rapidrabbitsliu/pc-chassis-designs/outputs/ATX-Desk-v12-print-review/Perspective.png

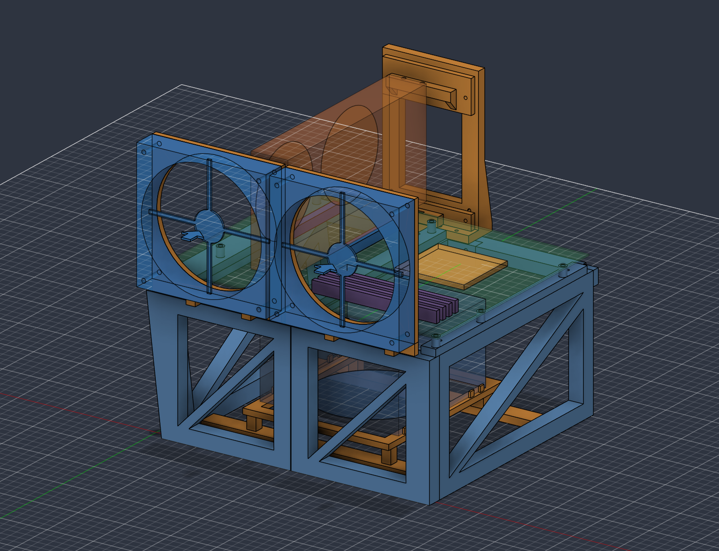
outputs/ATX-Desk-v12-print-review/Perspective.png
