rapidrabbitsliu/pc-chassis-designs/outputs/Style2-v09/Assembly.png

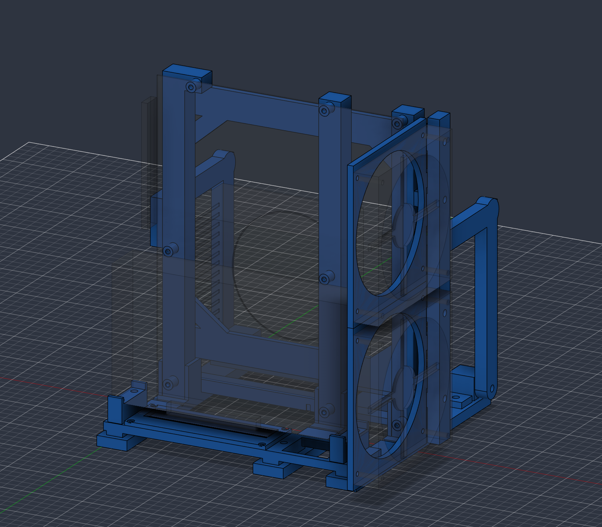
outputs/Style2-v09/Assembly.png
