rapidrabbitsliu/pc-chassis-designs/outputs/ATX-Desk-v24/README.txt

样式1 V24：M3×6、螺丝头直径7 mm配合修正，2026-11-01。
8件20处头井由CAD Ø6.6扩至Ø8.2：P03(2)、P04(2)、P05(2)、P08(4)、P09(2)、P10(2)、P11(2)、P15(4)。P12两处原Ø8.2保留并核对。
打印实测旧孔6.3 mm；旧CAD6.6 mm。结合早期0.6 mm缩孔反馈，预计新净径7.6～7.9 mm，目标>=7.5 mm，需实际试装。
仅扩大螺丝头通道，保留原3 mm承压层、M3 Ø3.4通孔和热熔螺母孔。风扇自攻螺丝孔保持V23设计，不能按M3头孔扩孔。
15件单实体、20处Ø7.6量规通道通过、2处原Ø8.2通道通过；切除范围局限于头井，整机几何干涉0、时间线健康。均不代表实体强度验证。
全套15件9盘沿用A1/0.4、PETG、0.2 mm层高、5墙、40% gyroid和各零件原支撑/裙边设置。V24未切片，打开后重新切片；V23约49小时44分/1106.22 g仅历史预算。未发送打印。
PRINT_STL为15件完整打印件，REPRINT_STL为8件补打；均为毫米。
43个有效M3短热熔螺母，P05另1孔停用。固定M3×6螺丝41颗，显卡上耳另0～2颗，风扇另8颗短自攻。
离线HTML说明书含15件独立图、13步完成图和19组热熔孔位；全部打印件图源为本版3MF。在线 https://rapidrabbitsliu.github.io/pc-chassis-designs/
