rapidrabbitsliu/pc-chassis-designs/outputs/Hook-Fit-v03/README.txt

双钩深度比较试片 V03 — 2026-10-19

优先打印 PRINT_BOTH_4.0_4.2mm.stl：两个分离零件已摆在同一平面，边缘间隔10 mm，总占地74×15 mm。导入单位mm，不要整体缩放。若软件提示拆分对象，可保留为两个对象，同一层打印，勿使用逐对象顺序打印。

每件只有32×15×3 mm前板和两个上挂钩；已去掉原来的下方定位点。孔距20 mm、钩宽3.8 mm、回钩向下3 mm与旧试片相同。钩喉净深分别4.0和4.2 mm。此数值不是总突出长度，也不是板厚。前面凹刻相应数字，槽深0.6 mm、最小笔画约0.8 mm，用于打印后辨认。两件实体总体积约3.36 cm³，不含支撑。

打印：沿用上次PETG及切片设置以便比较。大平面朝下、挂钩朝上，已摆好方向；上钩倒扣底部需要少量支撑，支撑应能从模型表面生成，不能只允许从平台生成。数字凹槽位于贴床面，短笔画顶部会出现小跨度桥接；预览确认，清理底部毛边后辨认。无需为文字额外加支撑。

试装：不用垫片。带钩朝向洞洞板、钩头朝下，将双钩同时插入横向中心距20 mm的两个孔，然后轻轻下移落位。拆卸先抬起约5 mm再向外取下。不要硬推、掰钩或挂重物。没有下部定位点的小试片可能较易摇摆或旋转，不能直接用总体晃动与原四孔4.4 mm试片比较；重点检查前后夹持松紧、能否落位和取下。

记录每件：插入是否顺畅；能否自然落位；前后松紧；能否轻松抬起取下。4.4 mm原试片已达到不晃且不紧的状态，并非越紧越好。选能完整落位且方便拆装的版本；如4.0不能落位先停下，不打磨。

文件：
PRINT_BOTH_4.0_4.2mm.stl：一起打印。
PRINT_depth_4.0mm.stl / PRINT_depth_4.2mm.stl：单件打印备用，不要与合并文件重复导入。
HookDepth_4.0_4.2_v03.f3d：实际Fusion MCP生成的可编辑双组件设计。
raw_depth_*.stl：Fusion原坐标导出，优先使用PRINT文件。
HookDepthBatch/：重生成脚本与manifest，新建文档，不修改现有设计。
verification.json、mesh_check.json：单一实体、时间线健康、STL封闭与体积检查；没有承载验证。

两件均仅供无负载配合测试，没有防抬起锁扣，不能挂电源。新文件独立保存，旧版本保留。
