rapidrabbitsliu/pc-chassis-designs/outputs/Single-Bracket-v05/README.txt

单侧完整挂钩支架 V05 — 2026-10-19

这是单侧装配与后续替代载荷测试的样件，不是已经确认可挂电源的成品。先只打印一只托架与一个防抬起插销。旧版完整电源防脱、左右托架连接仍未完成。本版不包括电源外壳螺丝孔，也不在电源上钻孔。

一、零件与候选紧固件
PRINT_Bracket_v05_mm.stl：主托架一只。
PRINT_AntiLiftKey_v05_mm.stl：可拆防抬起插销一只。
候选紧固件：普通金属M3六角螺母一颗、M3×8非沉头机螺丝一颗。螺母按对边5.5 mm、厚2.4 mm参考，槽对边5.7 mm、深2.6 mm；打印误差可能影响放入和止转。
规格参考：https://www.accu.co.uk/hexagon-nuts/7888-HPN-M3-A2
螺丝长度按头下长度计，不在头下额外加垫片。本几何中8 mm螺杆恰好从插销前面到背板后表面；实际打印后必须核对，端部不可突出并顶住洞洞板。若不能轻松完整啮合螺母，不换更长螺丝硬拧。
没有这套螺丝螺母时，可以先无负载挂板检查配合，但不能把松放插销当作已固定的防抬起结构。

二、采用的几何
上方双钩中心距20 mm，钩宽3.8 mm、喉深4.0 mm、向下回钩3 mm；保持已验证的挂钩接触截面。下方双定位舌与上方孔中心相距80 mm，跨两个40 mm竖向间隔。
背板32 mm宽、6 mm厚，托面32 mm宽、6 mm厚，从背板前面伸出92 mm；靠单侧的8 mm厚三角筋，留有切去尖角的三角减重窗口。前挡边高出托面6 mm。托架总包络约107×120×32 mm，实体体积61.41 cm³，不含打印支撑。
电源占位体140×150×86 mm，从背板前面留2 mm，托面前端留2 mm。占位体没有真实接口或风扇格栅，实际使用前需检查接口、风道与线缆。它不是打印零件。
板后实际净空按约10 mm记录，板厚仍未精确测量；不再用板厚5 mm强行校核4 mm喉深，而以试片实配结果为依据。

三、打印
STL单位mm，PRINT文件已经摆好打印朝向。托架三角筋的外侧大平面与背板、托面、前挡边的同侧边缘共面，直接贴打印平台，不再悬空。三角筋本体不需要大面积底部支撑，挂钩和局部孔槽仍需检查支撑。允许局部支撑从模型表面生成；不要误把整个三角减重窗口塞满支撑。
平移三角筋会改变托面的扭转受力，本版托面和前挡边从24 mm加宽至32 mm；这只是装配与打印改进，没有证明与居中筋承载等效。后续左右件需镜像，并复核电源侧面和插头空间。
几何对比：V04离床水平朝下面积约3209 mm²，V05约131 mm²；贴床面积约3841 mm²。此统计只看水平面，不能当作切片支撑体积或打印时间。实际支撑请以逐层预览为准。
插销大平面贴床、舌头向上，通常不需要支撑，螺丝孔为竖直孔。两个文件分别导入，各打印一件，不导入raw文件以免重复。
沿用已验证的PETG材料配置；这不是单纯的配合小片，建议使用足够外壁（例如5道）并检查根部、斜撑和托面切片连续。外壁数量不构成承重保证。侧放方向是装配样件起点，并非经过强度优化的最终方案。

四、安装顺序（先无负载）
1. 清除支撑，重点清理4 mm钩喉、插销导向孔和六角螺母槽。勿改变已验证的接触尺寸。
2. 在挂板前，把M3螺母从背面放入上部右侧六角槽，应低于或齐于背面。不得凸出造成背板离板。若槽过紧，不硬压开裂。
3. 先不要装防抬起插销。选同一块洞洞板内的矩形四孔：左右20 mm、上下80 mm，避开拼缝和墙面固定螺丝。仅一只样件，不要求现在与第二只相距120 mm。
4. 上方双钩与下方双舌同时对孔，轻推，向下落位约3–5 mm。较大的背板可能改变贴合手感，不能认为小片通过就一定完整件通过。
5. 落位后，从正面把插销的短舌推入背板右上方长方导向孔。舌头进入上部长孔剩余空间，用来限制支架上抬。前部小平板应贴住背板前面。
6. M3×8螺丝穿过插销圆孔，拧入预装螺母，轻轻锁住即可；不要靠强拧消除不配合。
7. 空载、手托着托架，轻试上抬，检查插销能否限制抬起而不是从孔里退出。检查左右摇晃、背板翘起、孔边局部挤压和实际拆卸。
8. 拆卸必须先卸螺丝、取下插销，再上抬并抽出整只支架。托住零件，避免螺母掉落。

插销是新的试验设计，尚未实物验证。只做名义几何检查，未用真实板厚、孔边倒角及漆层验证其限制行程。若插销无法插入、不能阻止上抬或难以退出，记录卡点，不进行载荷测试。

五、这次反馈哪些
四点能否同时入孔和落位；背板是否贴板；托面是否大致水平；螺母能否齐平放入；插销能否装入、固定和取出；锁住后能否限制上抬。暂不放电源，不用单只托架承接整台电源。
完整装配通过后再制定替代载荷与受热蠕变观察步骤，单侧样件不代表左右均分载荷，也未验证插拔线缆的额外力矩。仍需后续左右件、电源侧向和抬起防脱设计。

六、文件和验证
Single_Bracket_v05.f3d为Fusion MCP实际创建并导出的设计，保留草图和时间线，含电源占位参考。草图使用固定尺寸，此版不是全尺寸实时关联模型；改动需统一复核。
SingleBracket/为可重新生成的新文档脚本和manifest。不会修改已有设计。
verification.json记录实体包络和体积，mesh_check.json记录打印网格封闭与朝向检查。Fusion装配干涉检查为0（托架、插销和电源占位体，排除仅面接触）。尚未进行强度计算、载荷、温升或实物装配验证。

本轮V05变化摘要：三角筋从宽度中间移到z=-16至-8 mm一侧；托面和前挡边加宽并从z=-16 mm起始，使各部分共面贴床；三角减重窗口尖角改为短边过渡。4.0 mm钩喉、双钩20 mm间距、上下80 mm孔距、防抬起插销及M3孔槽不变。旧V04保留，请勿混用两版主托架。V04插销与V05插销几何相同，已打印的插销可以继续试配。
