rapidrabbitsliu/pc-chassis-designs/docs/风格1 桌面双层开放式机箱.md

# 风格 1 桌面双层开放式机箱

登记日期：2026年10月22日。机箱记为 **风格 1**；当前为 **V16 显卡插入与工具避让修正版**，其余结构沿用 **V13 一体横梁与重新拆件版**。风格编号表示结构方案，V15 表示该方案的模型版本；风格 2 是另一套方案。

## V16 装机避让修订

2026年10月24日，根据最新实物照片修订三件：P12显卡塔取消音频接口遮挡的X158底部孔，只收短该孔所在前伸底脚24 mm，后部立柱及调节固定点保留，整体宽度仍104 mm。P14下插脚座导向块截到X132，露出X140底部固定孔；两个下插脚槽的位置与尺寸不变。

P13撤销V14/V15的平台加长和孔前移，改为从最初V13的前缘缩回2 mm（Y246.84），上下厚度10 mm不变。用户确认孔从原位向支架侧退1.5 mm（X100/120、Y251），给外径5 mm短热熔螺母保留约1.66 mm前壁。

[V16 Fusion](../outputs/ATX-Desk-v16/ATX_Desk_v16_gpu_access.f3d)、[V16十盘工程](../outputs/ATX-Desk-v16/Style1_V16_All_Parts_10_Plates_With_Temporary_Repair.3mf)、[三件补打包](../outputs/Style1-V16-GPU-Replacement-Parts.zip)、[完整修订说明](../outputs/ATX-Desk-v16/README.txt)。第10盘改放P12/P13/P14三件，V16尚未在Bambu Studio重切片；旧版两件盘的时间与用量不适用。

先紧固底部X80/X140两颗M3×6，再安装上托片和显卡。后横梁原第三热熔孔停用，可保留，后横梁无需重打。剩余两孔Ø10 mm竖直工具包络与P12/P14无体积相交；音频接口没有详细CAD实体，最终配合仍需实物确认。本次不是强度或热性能验收。下文V15及更早尺寸均为历史记录，不适用于这三件新件。

## V15 平台长度最终修订

2026年10月24日，用户将平台延长量改为2 mm，两个螺母孔仍向显卡侧前移3 mm。平台前缘Y=242.84，孔中心仍为X=100/120、Y=246.5；外径5 mm螺母的前壁约1.16 mm。P12及V14其余改动不变，本次仅P13变化。

[V15 Fusion](../outputs/ATX-Desk-v15/ATX_Desk_v15_gpu_fit.f3d)、[V15修订说明](../outputs/ATX-Desk-v15/README.txt)、[V15补打包](../outputs/Style1-V15-GPU-Replacement-Parts.zip)。一盘项目尚未重新切片。已采用V14显卡塔时无须重打P12；先打印新P13核对配合和热熔薄壁。原参考显卡方盒的局部重叠减至约1 mm，仍以实物试装为准。下方V14的3 mm平台加长量为历史记录，已由本节替代。

## V14 显卡实物配合修正

2026年10月24日，依据用户实物照片，仅更新 P12 显卡塔及 P13 上托片：四条头部滑槽和塔底头井扩大至 CAD 8.2 mm，下槽同时穿过加强筋形成后方进入通道；保留3 mm承压腹板。以既有槽约6 mm的打印结果作补偿参考，目标打印后约7.5 mm净宽，尚需复打实测。

P13 两个热熔孔及平台前缘同时向显卡侧 −Y 移动或延伸3 mm，孔中心改为 X=100/120、Y=246.5，平台前缘 Y=241.84。外径5 mm的螺母前面约有2.16 mm材料。下插脚座和其他15件不改。

[当前 Fusion 模型](../outputs/ATX-Desk-v14/ATX_Desk_v14_gpu_fit.f3d)、[修订说明](../outputs/ATX-Desk-v14/README.txt)、[两件补打包](../outputs/Style1-V14-GPU-Replacement-Parts.zip)。补打包内的一盘3MF已经摆好并带基线配置，但尚未重切片。P13延长区域与原简化显卡方盒有约2 mm、800 mm³重叠，需先核对实卡局部轮廓；结构件间无体积干涉，四条滑槽的连续Ø7.5量规相交为0。不能将这些检查视为实物装机验收。

以下章节是V13完整结构、九盘及说明书基线，涉及P12/P13时以本节和V14修订说明为准。

硬件型号、尺寸和九孔坐标统一引用[硬件尺寸与通用设计基准](硬件尺寸与通用设计基准.md)。本文件记录风格 1 的最终布局、结构、拆件、打印配置及验证范围。

## 布局与外观

这是一个 PETG 打印的桌面双层开放式框架：上层主板平放、显卡正常直插，下层电源横放并居中。前上方设置两把并排的 140 风扇，向主板及显卡区域送风；背部保留主板与显卡接口、电源排风通道。

参考当前装配：[V13 Fusion 装配图](../outputs/ATX-Desk-v13/Assembly.png)。图中的蓝色框架、浅色主板梁、橙色附件、绿色主板和透明显卡只是识别部件的显示颜色，不限定实际耗材颜色。CPU、内存、显卡和电源的简化实体用于检查布局，不能当作完整实物模型。

保留左右及前侧承重框架。CPU 右侧保持垂直并与上方结构对齐；PCIe 左侧单侧内收，使底部宽度达到 290。后侧由连续横梁连接左右框架，不设置遮挡电源排风的大面积支撑板。

早期的双侧内斜、下层前挡板、显卡尾部托架、电源上方完整限位框，以及后横梁中间拼接，均不属于本基线。

## 朝向与气流

沿用硬件文档的坐标：X 朝 CPU 右侧，Y 朝背部接口，Z 向上。

| 部位 | 风格 1 的方向 |
| --- | --- |
| 主板 | 水平放置，CPU 在显卡插槽右侧，内存在右前侧 |
| 显卡 | 插第一条长 PCIe，风扇朝 −X，背板朝 CPU 一侧 |
| 主板 DP 和显卡显示接口 | 均朝后，即 +Y |
| 电源 | 下层横放，进风大风扇朝下 −Z，排风朝后 +Y |
| 两把机箱风扇 | 前上方并排安装，朝后 +Y 送风 |

电源通过底部开放托架吸气，托架只承托外壳边缘并限制位移。细扎带用于防脱。整机主要载荷经框架传递至桌面，不通过电源外壳承担。

## 关键尺寸

以下为当前 CAD 的设计值，单位 mm。Z 从桌面计算。

| 项目 | 当前值 | 含义 |
| --- | --- | --- |
| 桌面接触宽度 | 290 | 沿 9→8→7 号孔方向，X 12.45～302.45 |
| 左侧内收量 | 16.45 | PCIe 侧在 140 高度内向内收；CPU 侧垂直 |
| 框架上沿 | Z 140 | 主板梁安装基面 |
| 主板纵梁上表面 | Z 148 | 安装柱从这里继续向上 |
| 主板底面 | Z 158 | 安装柱高约 10；PCB 暂按厚 1.6 建模 |
| 电源包络 | X 77.4～227.4，Y 51.92～191.92，Z 30～116 | 150 × 140 × 86，下层居中 |
| 电源底部进风离桌面 | 约 30 | 中央进风区域保持开放，实物需留意线缆和桌面杂物 |
| 主板底面与电源顶面高度差 | 42 | 梁和加强筋占用部分空间，不能视为完整 42 的空腔 |
| 三根主板纵梁 | 每根长 243.84 | 沿前后方向布置，整根打印 |
| 后部一体横梁 | 304.45 × 47.34 × 20 | 连续单实体，无中间拼缝 |
| 双风扇一体底梁 | 284 × 31 × 20 | 四点固定至前框，面板通过安装耳固定 |
| 两根底部横条 | 每根 274 × 20 × 8 | 配合两侧框架形成 290 落地宽度；零件旧名称中的 290 不是本体长度 |
| 显卡固定塔 | 104 × 38 × 162 | Z 140～302，底部固定至后横梁 |

上层结构宽度约 306.45，主板仍有少量外伸。包含当前简化硬件和风扇的参考包络约为宽 309 × 深 332 × 高 302，未计实际 CPU 散热器、外接插头和线缆，不能直接据此判断完整实机占用空间。

## 承重与连接

主板九个安装点通过三根纵梁和侧部框架向下传力。左右框架、前框、后横梁和底横条形成闭合连接，避免只有孤立立柱支撑。前框角部有连接孔，中缝通过一体连接耳固定；底横条与侧框使用搭接座及螺丝连接。

显卡固定塔底部直接连接后部承重横梁，塔身设置加强筋。上部可调托片承接显卡金属挡板的安装耳，下部可调接收件容纳两个金属插脚；上下分别定位，避免仅靠一个横槽固定。可调件从背面锁紧，滑块内放短热熔螺母。实卡插脚和安装耳仍需试装核对，模型可调不等于已经验证实物适配。

两只风扇面板分别带安装耳，连接到一体底梁；底梁通过四个锚点连接前框。风扇本身为外购件，模型里的轮廓和十字只表达硬件位置，不应作为需要打印的叶片或风扇本体。

## 拆件与九盘安排

可打印件共 **17 件**，均为单个闭合实体。长件允许在热床平面内斜放，保持 100% 比例；不用为了单一方向长度超过 256 就强制拼接。所有零件的实际摆放及 brim 已按 256 × 256 检查。

| 盘号 | 零件 | 件数 | 支撑 | 已切片估时 |
| --- | --- | ---: | --- | --- |
| 1 | CPU 侧框架、三根主板纵梁 | 4 | 中纵梁需要 | 12小时45分 |
| 2 | PCIe 侧内斜框架 | 1 | 无 | 7小时12分 |
| 3 | 前侧 PCIe 框架、显卡上托片、下插脚接收件 | 3 | 下接收件需要 | 7小时04分 |
| 4 | 前侧 CPU 框架，含中缝连接耳 | 1 | 需要 | 5小时41分 |
| 5 | 一体后横梁、一体双风扇底梁，均斜放 | 2 | 风扇底梁需要 | 5小时14分 |
| 6 | GPU 侧 140 风扇安装面板 | 1 | 无 | 1小时44分 |
| 7 | CPU 侧 140 风扇安装面板 | 1 | 无 | 1小时44分 |
| 8 | 电源托架、显卡固定塔主体 | 2 | 两件均需要 | 8小时31分 |
| 9 | 两根 274 底横条，均斜放 | 2 | 无 | 2小时54分 |

后横梁平面斜放后包络约 220.94 × 220.94；风扇底梁约 209.30 × 209.30；底横条约 207.89 × 207.89，以上不含 brim。完整对象尺寸及支撑配置见[分盘清单](../outputs/ATX-Desk-v13/plate-list.csv)和[摆盘检查数据](../outputs/ATX-Desk-v13/plate-checks.json)。

## 已保存的打印配置

下表是 V13 最终 3MF 中的基线配置，不是所有 PETG 品牌的通用参数。Bambu Studio 2.7.1.62 已完成九盘切片。

| 设置 | 当前值 |
| --- | --- |
| 打印机与喷嘴 | Bambu Lab A1，0.4 |
| 材料与热床 | PETG Basic，纹理 PEI |
| 普通层高和首层层高 | 均为 0.20 |
| 墙层数 | 5 |
| 填充 | 40%，Gyroid |
| 顶部与底部层数 | 顶部 6，底部 5 |
| Brim | 左右侧框 3，其余 5；间距 0.1 |
| 支撑 | 六个对象启用普通自动支撑，仅热床；其余关闭 |
| 支撑顶部与底部 Z 间距 | 均为 0.16 |
| 支撑阈值角 | 25° |
| 喷嘴温度 | 首层和后续均 245°C |
| 热床温度 | 首层和后续均 70°C |
| 最大体积流量 | 13 mm³/s |
| 速度基线 | 外墙 60、内墙 150、稀疏填充 200、首层 50 mm/s |
| 打印顺序与比例 | 逐层打印，100% |

九盘切片总估计为 **52小时48分，1175.48 g PETG，其中支撑 34.89 g**。分盘时间分别取整后相加可能有一分钟差异。切片估计不等于实机实际耗时。

此前实际使用 AMS A4 的 PETG；发送每盘时仍需将项目材料映射到当时的实际 PETG 料槽，确认空板。不要把料槽编号当作模型固有属性。重新打开后如软件要求，重新切片再发送。

## 装配材料与顺序

以 M3 × 6 螺丝和 M3 H4.5 OD5 短热熔螺母为主，按约 48 组准备。现有 H8 螺母不能直接替换所有短螺母孔。风扇与面板之间另用匹配风扇的紧固件；电源另备宽约 3 的细扎带，绑带路径避开进风网、排风网、AC 插口及开关。

先安装热熔螺母，再依次装底横条及侧框、前框、后横梁、电源托架、主板纵梁、显卡塔和可调件、风扇底梁及面板。先轻紧，整体校正后再锁紧。采用完整 V13 连接体系，不根据已打印情况混用旧版连接件。

## 文件入口与验证范围

- [风格 1 V13 图解安装说明书](../outputs/ATX-Desk-v13/Style1_V13_Assembly_Manual.html)：2026年10月23日新增，17 件编号、21 组热熔孔位和 13 步完成状态图。
- [说明书及维护资料包](../outputs/ATX-Desk-v13/Style1_V13_Illustrated_Manual.zip)。装配顺序以说明书为准：电源在上方仍敞开时放入，再装主板纵梁和显卡塔。底部横条四颗螺丝头未沉入模型，须增加高于实测头部突出量的等高脚垫，防止螺丝头顶桌面。该要求未修改 CAD。
- [Fusion V13 完整装配模型](../outputs/ATX-Desk-v13/ATX_Desk_v13_one_piece.f3d)
- [Bambu Studio 最终九盘项目](../outputs/ATX-Desk-v13/ATX-Desk-v13-All-Parts-9-Plates.3mf)
- [可打印毫米 STL 文件夹](../outputs/ATX-Desk-v13/PRINT_STL/)
- [整套交付压缩包](../outputs/ATX-Desk-v13-complete.zip)
- [原始零件尺寸数据](../outputs/ATX-Desk-v13/parts.json)
- [V13 建模源文件](../outputs/ATX-Desk-v13/Sources/Build_V13.py)和[连接细节处理源文件](../outputs/ATX-Desk-v13/Sources/Finish_V13.py)

使用最终九盘项目，不使用中间的 Arranged 版本作为最终打印入口。Raw_STL 是 Fusion 原始导出，可能带原始单位及装配坐标，直接打印优先采用 PRINT_STL 或最终 3MF。

已完成 Fusion 时间线健康检查、单实体检查、装配体积干涉检查、关键接触检查、导出网格闭合与法线检查、CAD 和网格体积比对，以及九盘含 brim 的打印区域和切片检查。网格体积与 CAD 差异在 0.3% 以内。

目前仍是原型：没有完成整套实物承重、长期温升、PETG 蠕变和反复拆装验证；显卡金属挡板和完整硬件装配仍待实物核对。后续风格 2 可继承硬件基准与设计优先级，重新选择结构和气流，不需照搬风格 1 的朝向、框架外形或分件方式。
