rapidrabbitsliu/pc-chassis-designs/docs/风格2 竖板前置显卡机架.md

# 风格 2：竖板、前置显卡、竖放电源

2026年10月22日，当前为 V07 双140风扇布局原型，独立于风格 1 V13。下方早期版本参数保留为历史记录，当前变更以 V07 为准。

## 当前 V07：内存侧向接口侧送风的双140风扇

- 按用户确认，两把风扇平行向 −X（主板后置接口侧）吹，风向位于主板板面内，不是朝板面垂直吹。由于本方案主板竖放，风扇在右侧上下排列：上方对应内存/CPU，下方对应显卡。
- 暂用140×140×25风扇和124.5四孔距；上方中心Y−78/Z238，下方中心Y−78/Z86；风扇厚度方向X262～287。
- 新增一根侧安装立梁及两个独立风扇框。立梁用四个一体连接座固定到右立柱X248.49侧面，固定中心Z50、130、236、290，避开原侧框与风扇框连接耳。
- 新右立柱在上述四点增加M3热熔螺母孔。若已经打印V06，其余原件可沿用，右立柱须用V07版本。
- 总高314，低于315限制；现有模型前后包络306，比V06增加49；含风扇宽度约299.84，落地底座不变。实际CPU散热器与外接线缆不计入此包络。
- 打印结构件19个；不透明蓝色为打印件，半透明灰色为硬件。Fusion实体干涉为零、时间线健康；CPU散热器/内存没有实际包络，因此该结果不代表所有实机硬件已验证。
- 紧固件：M3×长4.5×外径5热熔螺母62个，M3×6螺丝62颗，建议各备70。新增风扇采用穿透安装，暂按8颗M4×40＋8个普通M4螺母，并非新增M4热熔螺母；实物风扇孔径需先核对。
- 当前模型：[彩色Fusion](../outputs/Style2-v07/Style2_V07_Dual140_Colored.f3d)、[STEP](../outputs/Style2-v07/Style2_V07_Dual140.step)、[效果](../outputs/Style2-v07/Dual140_Front.png)、[检查报告](../outputs/Style2-v07/verification.json)、[打印说明](../outputs/Style2-v07/PRINT_README.txt)、[源脚本](../work/build_style2_v07.py)。
- 打印项目：[V07 十三盘 3MF](../outputs/Style2-v07/Style2_V07_A1_PETG_All_Parts_13_Plates.3mf)、[完整打印包](../outputs/Style2-V07-Dual140-A1-PETG-Print-Package.zip)。19个单体、13盘均经Bambu Studio 2.7.1.62实际切片；预计1103.92g、51小时46分，全部无支撑。已验证保存后的机器、层高、墙层、填充、擦料塔设置；未发送打印。

## V06 历史：限位方向更正为左右

显示区分已另存为 [V06 彩色版 Fusion](../outputs/Style2-v06/Style2_V06_Colored.f3d)：16 个打印结构件统一不透明蓝色，7 个硬件示意实体统一灰色、25% 不透明度。[颜色预览](../outputs/Style2-v06/Colored_Structure.png)和[显示设置脚本](../work/color_style2_v06.py)一并保留；此修改不改变几何尺寸。

打印准备已完成：16 个结构件拆分为10盘，见 [Bambu Studio 十盘项目](../outputs/Style2-v06/Style2_V06_A1_PETG_All_Parts_10_Plates.3mf)、[打印说明](../outputs/Style2-v06/PRINT_README.txt)、[分盘清单](../outputs/Style2-v06/print_plate_list.csv)和[单件毫米 STL](../outputs/Style2-v06/PRINT_STL/)。A1/0.4/PETG/纹理PEI，0.20层高，5墙、40% Gyroid、顶6底5；245°C/70°C。立柱与横撑平躺、长件斜放，显卡承托梁翻面，全部无支撑；底脚3 brim，其余5。全部十盘经 Bambu Studio 2.7.1.62 实际切片，约932.24 g、43小时47分，未发送打印。完整打印包在 [ZIP](../outputs/Style2-V06-A1-PETG-Print-Package.zip)。这表示打印文件已准备好，实物配合和强度验收仍未完成。

用户通过两张圈图纠正限位方向：需要 X 左右两端限位，V05 的 Y 前后高挡边为错误理解，现已撤掉。

- 两根电源承托横条均在电源 X 两端设置挡块；排风端直挡，线缆端为 45° 导入斜面，挡高 10，左右各留 0.5 间隙。
- 电源仍为 X −0.84～139.16、Y38～124、Z22～172。直挡内侧面 X−1.34；斜面限位内侧面 X139.66，平顶 2、坡长 10。
- 从线缆侧略抬高 10.6，沿 −X 推入 60 后落座，85 个离散包络姿态通过检查。没有验证带线缆或真实外壳凸起的插入过程。
- 底部挡块占用壳体下缘，因此不再声称完整排风面都无遮挡；已检查模型中 Z36 以上的排风格栅外 100 及风扇外 30 的空间无框架干涉，实物格栅最低位置仍需核对。
- 16 个闭合结构件、Fusion 干涉为零、A1 含 brim 逐件包络通过。高度 313.8、结构深度257；尚未完成强度和实物适配验证。
- 当前文件：[V06 Fusion](../outputs/Style2-v06/Style2_V06_313_8mm.f3d)、[STEP](../outputs/Style2-v06/Style2_V06_313_8mm.step)、[左右限位细节](../outputs/Style2-v06/Left_Right_Stops_Detail.png)、[检查报告](../outputs/Style2-v06/verification.json)、[建模源码](../work/build_style2_v06.py)。

## V05 历史：方向错误的前后限位，已由 V06 替代

- 靠主板侧为直挡边，内侧面 Y37.5；外侧限位内侧面 Y124.5。电源范围 Y38～124，前后各留 0.5 装配间隙。
- 承托面 Z22，限位最高 Z32，即有效挡高 10。外侧导入斜面宽 90，45°，从 Y136.5/Z22 上升至 Y126.5/Z32，并保留 2 宽平顶；朝内为直面，落座后限制前后移动。
- 这不是弹性卡扣，不能防止电源向上脱出；后续仍需绑带或经实测确认的螺丝固定。应先略抬高电源再推入、落座，不能贴着底面直接水平硬推。
- 在完整框架中用 140 × 86 × 150 的保守电源包络检查：抬高 10.6、从后侧向主板平移 60，再垂直下降落座，共 85 个离散姿态均无碰撞。采样检查不等于实物装入验证，未包含插头、线材和机壳凸起。
- 后脚座前缘由 Y124 改为 Y124.5，避免与电源壳零间隙贴合。
- 整体仍高 313.8、前后深 257，结构件 16。Fusion 零干涉、时间线健康、进排风通道和逐件含 brim 打印包络均通过。
- 当前文件：[V05 Fusion](../outputs/Style2-v05/Style2_V05_313_8mm.f3d)、[STEP](../outputs/Style2-v05/Style2_V05_313_8mm.step)、[限位斜坡细节](../outputs/Style2-v05/PSU_Stop_Ramp_Detail.png)、[装配效果](../outputs/Style2-v05/Rear_PSU_Stops.png)、[检查报告](../outputs/Style2-v05/verification.json)、[打印包络](../outputs/Style2-v05/print_envelope_checks.json)、[建模源码](../work/build_style2_v05.py)。

## V04 历史：电源靠近主板，左右直角框，缩短后底座

- 电源向主板方向移动 17，当前 X −0.84～139.16、Y 38～124、Z 22～172。排风面与侧边柱齐平的关系保持；电源距立柱后表面 18，距横撑后表面 6。
- 左右外置框取消长斜段，改为顶面水平、后侧竖直的直角形。主截面 20 × 12，转角局部加圆形肉位；与主板立柱通过两颗间距 24 的侧向 M3 螺丝连接。
- 直角框顶梁底面 Z174，电源顶面 Z172，留 2；后竖杆前缘 Y126，电源后面 Y124，留 2。两侧框位于电源风口侧边，不压在风扇面上。
- 底脚后端从 Y195 缩至 Y152；底脚前端仍为 Y−105，故结构前后深度从 300 降为 257，减少 43。左右宽度没有因此缩小，总高仍为 313.8。
- 托架固定位置改为 Y35、111，后托架的中段延伸出限位唇，避开后脚座；电源由托架承重，不作为框架结构件。
- 16 件单闭合实体、Fusion 零干涉、时间线健康。完整排风面向外 100 的通道，以及 Ø120 风扇外侧 30 的保守方形通道，均未发现结构件遮挡。
- 每件含各边 5 brim 的 256 × 256 打印包络通过。仍未完成切片、实物装配、底座缩短后的稳定性、承载和 PETG 蠕变验证。
- 当前文件：[V04 Fusion](../outputs/Style2-v04/Style2_V04_313_8mm.f3d)、[STEP](../outputs/Style2-v04/Style2_V04_313_8mm.step)、[后侧效果](../outputs/Style2-v04/Rear_Compact_PSU.png)、[紧凑侧视](../outputs/Style2-v04/Compact_Side.png)、[检查报告](../outputs/Style2-v04/verification.json)、[打印包络](../outputs/Style2-v04/print_envelope_checks.json)、[建模源码](../work/build_style2_v04.py)。

## V03 历史：去长斜撑，电源排风面与边柱齐平

- 删除贯穿背面的长斜撑；横梁由高 18 改为 28，每根立柱处采用上下两颗 M3 螺丝，并在四角增加约 40 mm 的一体短角撑。它们不是已完成承重验证的替代方案。
- 电源沿 −X 外移 50.84；排风面 X = −0.84，与排风侧立柱外侧面 X = −0.84 齐平。电源当前范围 X −0.84～139.16，Y 55～141，Z 22～172。
- 电源托架、端部限位与绑带槽同步移动；左右外置折线撑保留，整体高度仍为 313.8。
- 下横梁中心高度从 54 提到 57，避免加高横梁与底脚套座干涉。
- 当前有 16 个单闭合结构实体；Fusion 干涉为零、时间线健康；完整排风面向外 100 mm 无结构件遮挡。
- 16 件指定平放方向并旋转后，含各边 5 mm brim 均通过 256 × 256 包络检查，最大包络边 246.46；没有完成切片和物理强度验收。
- 当前文件：[V03 Fusion](../outputs/Style2-v03/Style2_V03_313_8mm.f3d)、[STEP](../outputs/Style2-v03/Style2_V03_313_8mm.step)、[后侧效果](../outputs/Style2-v03/Rear_PSU_Aligned.png)、[排风侧视](../outputs/Style2-v03/Aligned_Exhaust_Side.png)、[检查报告](../outputs/Style2-v03/verification.json)、[打印包络](../outputs/Style2-v03/print_envelope_checks.json)、[建模源码](../work/build_style2_v03.py)。

## 用户当前要求

- MSI Z390-A PRO 主板保持竖向，接口朝侧面；框架顶部与主板齐平。
- 安装空间最高 318 mm，整机设计目标不超过 315 mm。
- 显卡位于主板前下方，通过已购买的 PCIe 延长线连接。
- 电源竖放，排风面与主板后置接口面平行、朝同侧。
- 左右侧撑都位于框架外侧，对称折弯避开电源排风面。
- Bambu A1、0.4 喷嘴、PETG，打印区域 256 × 256 mm，优先承重和可打印性。

## V02 布局

坐标：X 沿主板宽度，Y 向主板背后，Z 向上。主板接口与电源排风均朝 −X。

| 项目 | 模型值，mm |
| --- | --- |
| 框架及主板顶部 | Z 313.8 |
| 主板板框 | X 0～243.84，Z 9～313.8，厚 1.6 |
| 主板底部避让 | 底脚在 PCB 下边缘处局部降至 Z 8.5，留约 0.5 空隙 |
| 电源 | X 50～190，Y 55～141，Z 22～172，即 140 × 86 × 150 |
| 电源排风 | −X，大风扇面朝 +Y；模型格栅只标方向，非实测开孔 |
| 显卡含挡板包络 | 235.5 × 40 × 129，Z 40～169，与主板前后错层 |
| 外侧撑 | 左右镜像，12 厚、20 宽；上端 Y10/Z260，折点 Y175/Z185，下端 Y175/Z20 |
| 三根立柱 | 连续整根，正面沿用变换后的九孔坐标 |
| 紧固件 | 以 M3×6、M3 H4.5 OD5 热熔螺母为基准；连接处沉孔留下约 3 mm 腹板 |

V01 中的主板/底脚、电源托梁/后支座和横梁/斜撑等干涉已在 V02 中修正。

## PCIe 母槽估算

照片按约 89 mm 的标准 ×16 连接器作比例参照，黑色 PCB 约 130 × 18 mm；避让先按 135 × 25 × 15。厚度及孔距未知。V02 的托盘和参考母槽只是占位，尚无经实测确认的 PCB 固定机构。显卡托垫接触位置及防脱固定同样需要实卡核对。

## 检查结果与限制

- 17 个结构件，每件单闭合实体；Fusion 时间线健康。
- 全部结构与简化硬件之间实体干涉为 0。
- 电源完整排风面向外 100 mm 的空间内没有框架实体。
- STL 拓扑边闭合检查通过；指定平放方向后，逐件旋转搜索，包含四周各 5 mm brim 均能放入 256 × 256；最大包络边约 246.46。
- 打印包络检查不等于完成摆盘、支撑设计或切片。Raw_STL 是装配坐标与 Fusion 原始单位导出，不能当作最终毫米打印入口。
- CPU 散热器和内存尺寸未确认，主板元件仅以 PCB 代替；实机装配、线材弯曲、交流插头/开关可达性尚未验证。
- 折线侧撑为排风避让方案，尚未完成承载计算、PETG 长期蠕变或实物承重测试。本版用于看布局和效果，不是最终可打印定稿。

## 文件

- [Fusion V02](../outputs/Style2-v02/Style2_V02_313_8mm.f3d)
- [STEP](../outputs/Style2-v02/Style2_V02_313_8mm.step)
- [后侧效果](../outputs/Style2-v02/Rear_PSU_Exhaust.png)
- [排风侧视](../outputs/Style2-v02/Exhaust_Side.png)
- [Fusion 检查](../outputs/Style2-v02/verification.json)
- [打印包络检查](../outputs/Style2-v02/print_envelope_checks.json)
- [建模脚本](../work/build_style2_v02.py)
- [包络校核脚本](../work/check_style2_print.py)

## V08 紧凑宽度预览（2026-10-23）

用户图中风扇至电源侧的方向由 306 mm 缩至 280 mm；另一方向仍 299.84 mm，高 314 mm。不能将 280 mm 理解为两侧均小于 290 mm。

风扇向内移 7 mm，框外沿裁去 6 mm。电源向主板方向移动 10 mm；上下横撑由 12 mm 减为 6 mm，仍保留 3 mm 螺钉承压壁，电源与横撑留 2 mm。后侧框架缩短 10 mm，底脚末端缩短 13 mm。电源前托座及底脚连接孔同步调整。

19 个打印件；模型打印件之间及与硬件参考包络之间的实体干涉为零。横撑减薄后的刚性、PETG 长期承载、真实硬件/线缆及显卡热风路径仍待验证。V08 为模型预览，未更新 Bambu 切片；修改件不可沿用 V07 打印文件。

文件：outputs/Style2-v08/Style2_V08_Dual140_Colored.f3d 和同目录 STEP、Raw_STL、verification.json。原始 STL 尚未摆盘，不可直接当最终打印包。

## V09 显卡间距 55 mm（2026-10-23）

显卡包络、GPU 托架、两端垫座、PCIe 母槽参考与托盘统一沿 Y 负向移动 12.4 mm。底脚 GPU 固定孔从 Y=-75 改至 -87.4 mm，底脚前端延长至 -117.4 mm。显卡朝主板的面 Y=-67.4，主板正面基准 Y=-12.4，平面净距 55 mm（不含未建模的主板元件突出量）。

总包络 X=299.84、Y=280、Z=314 mm，仍满足此前图中方向 280 mm 的目标。19 个打印件之间及其与硬件参考包络的实体干涉为零。55 mm 为用户要求的几何间距，不等于已完成热验证。未更新切片，不可沿用旧版 GPU 托架和底脚文件。

模型保存在 outputs/Style2-v09/Style2_V09_Dual140_Colored.f3d 和同目录 STEP，检查报告 verification.json。

### V09 打印工程已完成

19 件分 13 盘，已在 Bambu Studio 全部切片并保存，工程参数及零件数量复核通过。A1 0.4 mm，PETG Basic，0.2 mm 层高，5 层墙，40% gyroid，顶6底5，245/70°C。底脚3 mm裙边，其余5 mm，无支撑。预计1014.88 g，47小时30分。未发送打印任务。

最终工程：outputs/Style2-v09/Style2_V09_A1_PETG_All_Parts_13_Plates.3mf
完整包：outputs/Style2-V09-Dual140-A1-PETG-Print-Package.zip
