rapidrabbitsliu/pc-chassis-designs/outputs/ATX-Desk-v11-preview/README.txt

V11 后横梁接头预览，非最终打印版。
重建后横梁：左端按PCI斜侧内表面贴合，右端贴合CPU侧。两端有一体连接耳，M3螺丝穿8 mm耳板进入侧框短热熔螺母。
中间60 mm前后半深搭接，梁深23.16 mm；两颗横向M3贯穿螺栓连接（孔X132/172,Z134,沿Y轴），配金属螺母和垫片。暂定需约M3×30，最终按垫片/螺母选长。两端连接耳需比现有M3×6更长的螺丝（约M3×12起试配）。
搭接下方一体加筋最低Z120，高于电源顶面116；无中间立柱，后部保持开放。显卡塔底3处螺母孔和插脚贯通槽已重做。
保存模型实际测量：左梁-PCI侧、右梁-CPU侧、左右搭接、显卡塔底-左梁最小距离均0 mm，详见contacts.json。当前实体无体积干涉，时间线健康。几何接触不代表强度已验证。
保持底宽290、主板底面158、电源居中和底部进风30 mm。9个主板孔位置保持。
模型采用名义贴合，尚需为PETG打印配合制定公差并测试，4.6 mm螺母试孔需打印试块校准。承载/热变形、整机其他框架接头和电源防脱仍待完成；实卡金属挡板位置仍待测量。
