rapidrabbitsliu/pc-chassis-designs/docs/硬件尺寸与通用设计基准.md

# 硬件尺寸与通用设计基准

记录日期：2026年10月22日。用于风格 1 和后续风格 2 共用的硬件参考，尺寸单位均为 mm。硬件本身的尺寸、用户约束和某一风格采用的摆放方式分别记录，避免新方案沿用已经取消的布局。

## 硬件总表

| 项目 | 已确认的信息 | 尺寸及说明 |
| --- | --- | --- |
| 主板 | 微星 MSI Z390-A PRO，ATX | 官方约 305 × 244；当前 CAD 板框采用 304.8 × 243.84 |
| 显卡 | 影驰 GALAX GeForce RTX 5060 Ti 16 GB，用户提供的产品链接对应款 | 含挡板 235.5 × 129 × 40；不含挡板 223 × 114 × 40 |
| 电源 | ENERMAX 安耐美 GM650 金竞蝠，型号 ERV650G-AHG，650 W | 深 140 × 宽 150 × 高 86；大风扇朝下时高度为 86 |
| 机箱风扇 | 两把，尚未确定具体型号 | 按每把 140 × 140 × 25 预留 |
| CPU | 具体型号未记录 | 当前模型的 CPU 区域仅为位置示意 |
| CPU 散热器 | 型号和尺寸未记录 | 高度、底座和风扇包络需要补充 |
| 内存 | 主板有四条 DIMM 插槽 | 模型画出四条内存示意；实际型号、安装数量和高度未确认 |

显卡尺寸按长度 × 高度 × 厚度记录，不能把含挡板尺寸和散热器本体尺寸混用。具体系列名称不根据外观推断。电源约 1.51 kg 来自早先称重照片的记录，包含照片中的线缆，不作为裸机净重。

## 主板方向与孔位

主板平放，显卡正常直插靠近 CPU 的第一条长 PCIe 插槽，不使用延长线。此前已经对齐的俯视图以主板背部接口在上方为准：CPU 在显卡插槽右侧，内存在右前侧，第二条长 PCIe 插槽在显卡插槽左侧。

布局参考图：[已经确认的主板俯视图](../outputs/board-alignment/motherboard-top-alignment.png)。它表达元件相对位置，不是按图缩放的加工图。

为便于各风格复用，采用以下坐标定义：

- X 向右，朝 CPU 一侧；Y 向后，朝主板 DP 等背部接口一侧；Z 向上。
- 主板板框左前角的桌面投影为原点。板框范围为 X 0～304.8，Y 0～243.84；桌面为 Z 0。
- 孔号按该俯视方向排列。九孔不是等间距的规则九宫格，尤其 3 号孔比 1、2 号孔更靠前。

| 孔号 | X | Y | 位置 |
| --- | ---: | ---: | --- |
| 1 | 16.51 | 233.68 | 后排左 |
| 2 | 140.97 | 233.68 | 后排中 |
| 3 | 298.45 | 210.82 | 后排右，向前错位 |
| 4 | 16.51 | 78.74 | 中排左 |
| 5 | 140.97 | 78.74 | 中排中 |
| 6 | 298.45 | 78.74 | 中排右 |
| 7 | 16.51 | 6.35 | 前排左 |
| 8 | 140.97 | 6.35 | 前排中 |
| 9 | 298.45 | 6.35 | 前排右 |

以上是当前 V13 CAD 已核对的安装中心坐标，尚未对实物主板九孔逐一测量。用户已反馈首根打印纵梁的位置准确，这不等于整板九孔全部完成实物验收。换主板时应重新核对，不能仅凭“ATX 或 mATX”沿用全部孔位。

当前模型的主显卡插槽中心约 X 126.4，第二条长 PCIe 插槽约 X 60，PCB 厚度按 1.6 建模。这些是布局近似值，不能直接作为显卡挡板、PCIe 插槽或背部接口的精密加工基准。

## 显卡安装参考

显卡本体包络使用 223 × 114 × 40，金属挡板另留空间。含挡板总尺寸使用 235.5 × 129 × 40。显卡的显示接口与主板背部接口处于同一后侧。

风格 1 中显卡竖立在平放的主板上：风扇面朝第二条长 PCIe 一侧，即 −X；背板朝 CPU 一侧，即 +X。显卡尾部托架已经按用户要求取消，后部通过金属挡板的上方安装耳和下方两个插脚定位固定。

后续精确设计还需实物确认：显卡重量、上耳螺丝孔位置与厚度、下方两个插脚的宽度和间距、辅助供电接口位置，以及插头和线缆转弯空间。金属挡板不能仅按显卡外形长方体替代。

产品来源：[用户提供的影驰产品页](https://www.szgalaxy.com/goods/detail?id=760873753159798784)。上述两组尺寸来自用户提供的产品尺寸截图。

## 电源安装参考

电源型号按用户明确提供的 **ERV650G-AHG** 记录，外形采用 **D 140 × W 150 × H 86**。深度方向从 AC 插口和排风面延伸至线缆侧；扇面朝下时，平面投影为宽 150 × 深 140，高度为 86。

风格 1 的最终选择是电源横放在下层、尽量居中，大风扇朝下吸气，排风面朝后，与显卡接口、主板 DP 接口同向。早期“进风风扇与显卡风扇同向”和竖放电源方案已经取消。

框架和托架承担整机载荷，电源外壳不作为主板承重结构。电源实际进风网、排风网、AC 插口、开关、线缆接口及固定螺丝孔的详细位置尚未测量。CAD 中约 Ø120 的进风圆只是避让参考。

同系列其他后缀型号不能直接视为同一台电源，尤其不能将 ERV650G-AHG-MAC 或 MAV 的接口和电气规格自动套用到此型号。

## 风扇与气流

用户选择两把 140 × 140 × 25 的风扇用于上层送风。风格 1 将它们并排放在前上方，朝后吹向主板和显卡区域；电源保持独立的底部进风、后部排风路径。

当前风扇安装孔距按常见的 124.5 × 124.5 建模，安装面板通风开口约 Ø130。风扇型号尚未确定，购买后需核对实际孔距、外框尺寸、线缆出口和螺丝规格。

## 打印与桌面约束

用户要求按以下优先级设计：

1. 每个零件在实际打印方向下都能放入 256 × 256 的打印区域，包含 brim；允许平面斜放，保持 100% 比例。
2. 承重足够，连接和受力路径可靠。
3. 打印方便，尽量减少不必要的支撑、拼接和零件。
4. 美观。

当前使用 Bambu Lab A1、0.4 喷嘴、PETG。桌面沿 9 号孔朝 8、7 号孔的方向，能够完整承托的宽度约 290；用户接受上层主板和结构适度超出桌面。290 是这一方向的落地尺寸约束，不是所有方向的整机尺寸上限。

当前方案为桌面支撑，不再采用早期挂洞洞板方式。风格 2 如改变安装方式，需要重新确定支撑和空间约束。

## 螺丝与热熔螺母

用户给出的螺母尺寸顺序为“螺纹内径 × 高度 × 滚花外径”：

| 现有材料 | 正确解释 | 当前用途 |
| --- | --- | --- |
| 3 × 8 × 5 | M3，长 8，外径 5 | 长热熔螺母；按局部厚度选择，不默认每处都使用 |
| 3 × 4.5 × 5 | M3，长 4.5，外径 5 | V13 主要采用的短热熔螺母 |
| 螺丝螺纹段约 6 | 当前按 M3 × 6 配合设计 | 实际头型、头径仍需核对 |

2026年10月24日实物反馈：现有一款 M3×6 蘑菇头螺丝头径约7 mm，V13显卡塔原CAD 6.6 mm槽实测约6 mm，无法放入。V14显卡塔将头槽和底部头井扩大至CAD 8.2 mm，目标打印净宽约7.5 mm；其余V13零件的旧头井未统一更改，不能将“螺纹均为M3”视为所有头型均兼容。螺丝头高度仍未确认。

V13 多处螺丝头井为 Ø6.6，连接腹板约 3，使 M3 × 6 能获得约 3 的螺纹啮合。特殊大头、手拧头或附大垫片的螺丝需要另核对。热熔螺母试装底孔采用 Ø4.6 或 Ø4.7，最终效果受螺母实物和打印尺寸影响；它们不是冷压装配孔。

## 后续补充清单

优先补充 CPU 散热器高度与包络、实际内存高度、显卡挡板详细尺寸和电源线缆转弯空间。若风格 2 改变主板方向，保留硬件尺寸及上述孔位坐标关系，再重新推导机箱坐标、气流、承重点和打印方向。

主板尺寸来源：[MSI Z390-A PRO 官方规格](https://br.msi.com/Motherboard/Z390-A-PRO/Specification)，官方以 12 × 9.6 英寸及约 30.5 × 24.4 cm 表示板型。电源型号和包络还参考早先“创建参数化理线夹试作品”会话中的用户确认、卷尺照片及称重记录。结构和切片资料见[风格 1 文档](<风格1 桌面双层开放式机箱.md>)。
