rapidrabbitsliu/pc-chassis-designs/outputs/ATX-Desk-v16/README.txt

风格1 V16：显卡插入及底座螺丝工具通道修订
2026-10-24

以V15为输入，仅改P12显卡塔、P13上托片、P14下插脚座，其余14件沿用。全部17件完整模型为 ATX_Desk_v16_gpu_access.f3d。

P13：撤销V14/V15的平台加长及孔前移。相对最初V13，前缘沿+Y缩回2 mm，改为Y246.84；平台上下厚度仍为10 mm。用户确认两个热熔孔从原位Y249.5向支架侧退1.5 mm，改为Y251.0（X100/120），孔径4.7 mm，使用M3×4.5×5短热熔螺母。外径5 mm螺母前方保留约1.66 mm材料。该变化相对V15为平台前缘缩回4 mm、孔后退4.5 mm。

P12：取消被音频接口遮挡的第一处底部固定孔（X158/Y248.5）；对应前伸底脚在CPU侧收短24 mm，前沿部分X70～150、Y244～254。后部立柱、加强筋根部及两侧上下调节孔保留，因此支架整体宽度仍为104 mm，不宣称整体缩短。剩余两个底部固定孔为X80/140、Y248.5。原有8.2 mm头部通道保留。原后横梁的未使用X158热熔孔不影响使用，无需重打后横梁。

P14：两插脚导向块从X140截到X132，另一端从X84轻收至X85，给底部两孔的螺丝头及工具让位；后部调节背板保留，两个下插脚槽的中心X96/116、开口宽度与前后位置均不变。

装配顺序：先安装下插脚座和显卡塔，拧紧底部两颗M3×6固定螺丝，再装上托片并插入显卡；最后调节高度、锁紧滑块和显卡金属上耳。不得依靠上耳螺丝强拉显卡入槽。后横梁接收显卡塔的热熔螺母从三处实际使用改为两处；已装入但停用的第三个可保留。

几何检查：17件均为单个闭合实体，结构件体积干涉为0；简化硬件参考包络干涉为0；时间线健康。剩余底部两孔以Ø10 mm、Z148.01～310的竖直工具包络检查，与P12/P14的相交体积均为0。工具检查不包含尚无精确模型的主板音频接口及完整线束，也不代替实物试装或长期强度验收。

PRINT_STL/ 为17件指定打印方向、毫米单位的完整模型；REPRINT_STL/ 为P12、P13、P14三件补打模型。三件一盘含5 mm brim，打印包络已检查在256×256 mm内。临时盘P12普通自动支撑仅热床，P13/P14无支撑，0.2 mm、5壁、40% gyroid PETG基线。

Style1_V16_All_Parts_10_Plates_With_Temporary_Repair.3mf：原九盘更新三件，在第10盘额外放这次修补的三件；原盘号与已打标记保留。未发送打印任务。
