rapidrabbitsliu/pc-chassis-designs/outputs/ATX-Desk-v01/README.txt

ATX 桌面双层底座 V01 — PETG 试装版
适配目标：MSI Z390-A PRO、ENERMAX ERV650G-AHG、用户提供的影驰 5060 Ti 16GB 尺寸。

设计与朝向
X 正方向：从主板后置接口往前；Y 正方向：从 CPU 一端往显卡风扇一侧；Z 向上。
电源后部出风与主板 DP 接口都朝 -X；电源大风扇与显卡风扇都朝 +Y。
主板水平安装、显卡直插主 PCIe 插槽。电源侧立在下层，不承托主板框架。
主板参考板框为 304.8 × 243.84 × 1.6 mm；底面 Z=208 mm。
电源占位为 X20..160、Y45..131、Z20..170 mm，即 140 × 86 × 150 mm。
主框架侧片高 190 mm；上横梁顶面 198 mm；主板安装柱高 10 mm、直径 8 mm。
主体约 296 × 320 mm；含后部显卡固定架最大约 308 × 320 × 350 mm，不含 CPU 散热器。

文件
PRINT_*.stl：21 个独立零件，全部需要各打印一件；试片打印后不装入底座。
raw_*.stl：Fusion 装配坐标原始导出，仅供追溯，不要与 PRINT 文件重复打印。
ATX_Desk_v01.f3d：可编辑 Fusion 特征模型，含非打印硬件参考包络。
Build_ATX_Desk_v01.py：在新 Fusion 文档重生成的脚本，尺寸集中在 CONFIG 与 HOLES 中。
这是有特征历史的模型；脚本草图坐标固定，不是修改单一参数就能自动联动全体几何的完整约束模型。
geometry.json / mesh_checks.json / interference.json：几何、网格和干涉检查记录。

先打印热熔螺母试片
先单独打印 PRINT_11_INSERT_FIT_FIRST.stl，使用正式 PETG 和层高。
平放时，沿 X 从左到右三列孔径分别为 4.6 / 4.7 / 4.8 mm。
Y=8 mm 的近排用于 4.5 mm 高螺母；Y=22 mm 的远排用于 8 mm 高螺母。
试片两排孔深分别为 4.9 / 8.4 mm；热压时按顶面控制下沉约0.2 mm，不必继续压到底。
正式零件短孔深4.7 mm，主板柱及滑动螺母块为4.9 mm；长孔深8.2 mm。
主模型采用 4.7 mm 孔径。选择能完整热压、无鼓包且拧螺丝不转动的一列。
若 4.7 不合适，先调整主模型孔径再打印整套。不要冷压外径 5 mm 的螺母。

五金清单（不含试片耗材）
M3 × 6 mm：9 颗，主板固定；可用你现有的螺丝，先确认实际螺纹确为 M3。
M3 × 10 mm：8 颗，电源托梁 4、显卡后支架脚 2、尾支架脚 2。
M3 × 12 mm：27 颗，侧框连接片 16、主板横梁 6、电源压框 4、显卡挡板 1。
M3 × 16 mm：4 颗，显卡后支架滑块 2、尾支架滑块 2。
M3 平垫圈：至少 5 片用于显卡调节与挡板，主板处可另加 9 片合适的小垫圈。
M3 × 高4.5 × 外径5 mm 热熔螺母：24 颗。
M3 × 高8 × 外径5 mm 热熔螺母：24 颗。
短螺母：主板安装柱 9、侧框顶端 6、侧框托梁座 4、中横梁显卡支架脚 4、显卡滑动螺母块 1。
长螺母：侧框接缝侧面 16、电源压框底部 4、两个显卡滑块各2共4。
建议另备少量螺丝与嵌件。电源原有外壳和螺丝不需要拆动。

打印
导入单位 mm；禁止缩放。256 × 256 mm 平台。
PRINT 文件已平移贴床；长横梁和电源托梁已在平面内旋转 45°，请保留该朝向。
侧框与连接片平放；电源压框侧躺；显卡后架侧躺；尾支架脚朝下。
PETG、0.4 mm 喷嘴、0.20 mm 层高为起点。侧框/横梁/支架建议 5 道墙、6 层顶底、30–40% 填充。
显卡滑动螺母块、连接片和小滑块建议实心。具体温度与风扇沿用该耗材已验证配置。
不要一键对所有零件禁用支撑：主板横梁两端安装耳底部有悬空，需局部支撑。
横梁主跨的下筋和45°过渡可减少连续悬空；最终以切片逐层预览为准。
侧框的侧向嵌件孔朝上；框架平放不需要填满减重窗口。
各零件的孔口、窄槽及显卡滑块台阶按切片检查局部支撑。不要把嵌件孔塞入难以取出的支撑。
后显卡滑块按文件朝向打印时高96 mm，建议加裙边，并为中间开口上沿设置局部支撑。
去毛边后再试装，尤其清理孔口的象脚；装配面不得有残余支撑。

装配顺序
1. 试片通过后热熔嵌件。主板柱与滑动螺母块的嵌件顶面低于塑料约0.2 mm。
2. 左右侧框各由 rear / front 两片组成，接缝名义间隙0.4 mm；内外方向按 Fusion 装配图。
   每侧上下各一片连接片，用 M3×12 固定。连接片在两侧框外侧。
3. 装 CPU / MID / PCI 三根主板横梁，M3×12 从上穿过安装耳，拧入侧框顶端短嵌件。
   三梁 Y 中心分别为6.35 / 163.83 / 288.29 mm。不要把中梁与端梁混淆。
4. 两根电源托梁放入侧框低位让位座，M3×10 从上固定。
5. 空机试放主板，9 孔均对准、板背与横梁留空后再用M3×6逐颗固定，不靠拧紧强行拉孔。
6. 取下主板或妥善隔离，放电源，再安装两只可拆压框。
   压框用M3×12从托梁下方向上固定，长槽允许前后小幅调位；压框不需要压弯电源外壳。
   下层限位槽净长141 mm、净宽87 mm，分别给140 / 86 mm机身约1 mm总余量。
7. 后显卡支架固定在中横梁后端，尾支架固定在中横梁前端，脚用M3×10。
   先装横梁的中心螺丝，再装支架脚。脚底凹位给横梁中心螺丝头让位。
8. 显卡插入主 PCIe 插槽，后滑块用两颗M3×16和垫圈调高，长槽对准金属挡板。
   小滑动螺母块放在螺丝台下方，用M3×12和垫圈固定显卡金属挡板。
9. 尾部滑块用两颗M3×16调高，接触显卡外壳实心边缘；不要碰风扇叶片、PCB或接插件。
   需要时垫薄防滑软垫，只托住重量，不把显卡向上顶弯。

显卡配合范围与限制
GPU 包络采用用户截图：含挡板235.5×129×40、不含挡板223×114×40 mm。
厂家尺寸没有给出主板插槽到显卡外壳、挡板弯折与风扇的精确偏置；占位模型的Y=155是布局参考值。
后支架螺丝台Y槽中心范围142..214 mm，竖向调节约28 mm；尾支撑竖向调节约24 mm。
这些调节用于实物试配，不表示已证实与这张显卡所有接口、风扇和外壳边缘吻合。
先在断电状态验证挡板螺丝能自然对齐、显示线能插拔、尾托接触实心位置。
尾托横臂位于主板上方约3.4 mm（相对1.6 mm PCB顶面），必须检查附近主板元件；若相撞，先拆下尾托。
不要靠显卡支架校正主板/插槽的错误位置。

主板孔位（mm）
基准：主板后接口边X=0、CPU侧短边Y=0，板框243.84 × 304.8。
A(10.16,288.29), C(10.16,163.83), F(33.02,6.35)
G(165.10,288.29), H(165.10,163.83), J(165.10,6.35)
K(237.49,288.29), L(237.49,163.83), M(237.49,6.35)
孔位按Intel ATX标准图；微星官方规格确认该板有9个安装孔。实际主板是最终配合依据。
资料：https://ca.msi.com/Motherboard/Z390-A-PRO/Specification
资料：https://www.synthmind.com/developer_specs_atx2_2.pdf （Intel ATX 2.2，第10/12页）
显卡：https://www.szgalaxy.com/goods/detail?id=760873753159798784 （外形尺寸以用户截图为准）

验证边界
几何检查不等于承载或热态寿命验证。这版尚未实物打印、装机或做PETG长期热态蠕变测试。
最终检查：21个零件各为单一实体，Fusion时间线688项均健康；STL封闭且法线一致。
摆放后的单件最大占地224.86×224.86 mm，全部在256平台内保留至少约15 mm单侧余量。
20个装配零件与主板、电源、显卡简化包络一起检查，排除共面接触，实体干涉为0处。
STL体积与Fusion实体体积在0.2%内一致。总体积约1651.6 cm³，为实心几何体积，不能直接当作实际耗材量。
先做嵌件试片和空机配合，再逐步加硬件重量，检查连接片、横梁挠度及螺母是否松动。
主板参考仅包含PCB外框和安装孔，GPU/电源为外形包络，未建每个焊点、散热器、线缆与插头。
开放式PETG桌面试装底座不提供金属机箱的屏蔽/接地外壳功能；电源保持原壳完整。
