rapidrabbitsliu/pc-chassis-designs/outputs/ATX-Desk-v02-preview/README.txt

V02 布局预览 — 2026-10-20

本版用于确认空间和方向，尚未完成螺丝连接、拼接与全部打印朝向设计，不用于直接打印装机。
V01 文件保留；V01 主板孔位方向与已确认俯视图不一致，不再用作主板安装依据。

从元件面俯视，后置接口朝上：
CPU、内存在右；主显卡插槽在左侧中间；第二条长PCIe更靠左。
9个安装孔与用户确认的位置图一致。3号孔比1、2号孔更靠前。
主显卡插槽按距CPU侧短边约178.4 mm估计，即图中横向X约126.4 mm。
这来自用户标出的约170/118 mm和插槽宽度关系，尚非精确实测坐标。
显卡仅保留后部挡板固定架及调节滑块，尾托及其专用安装结构已删除。

电源：
型号ERV650G-AHG，采用86×140 mm占地、150 mm高度，侧立放置。
主板占地中心为X152.4、Y121.92 mm，电源占地中心与之重合。
大进风风扇朝右（CPU侧、+X），显卡风扇朝左（第二PCIe侧、-X），二者相反。
电源出风口朝上方的后置接口侧（+Y）。电源前后接口/插头/线缆尚需最终核对。

桌面290 mm约束：
横向X从7号孔一侧朝9号孔一侧增加；9号孔的X=298.45 mm。
按“从9号孔朝8号、7号方向有290 mm”计算，桌面带为X8.45..298.45 mm。
底部接触桌面的实际范围为X10.45..296.45 mm，宽286 mm，两端各留2 mm余量。
两侧框架向下内收，左侧从上端X=-4收至底部10.45 mm，右侧外缘从308.8收至296.45 mm。
上层框架最大横向宽312.8 mm，主板宽304.8 mm，均允许少量悬出。
主板底面高度仍为208 mm。前后方向未套用290 mm限制。

俯视图Top.png为便于看清插槽，临时隐藏了显卡外壳和显卡风扇参照；透视图包含这些参照。
绿色为主板外框，橙黄色方块为CPU，紫色四条为内存，蓝色两条为长PCIe。
下层中央的灰色半透明体是电源，圆形面表示进风大风扇。
CPU/内存/插槽/风扇和硬件外壳均为参照，不是打印件。

验证：
当前Fusion时间线373项健康，底面顶点检查确认宽度286 mm。
18个框架候选部件与主板PCB、电源和显卡简化包络共同进行干涉检查，排除共面接触后为0处。
未以此声明真实焊点、元件、插头、线缆和散热器均已避让；尚未实物试装、承载或热态蠕变测试。

文件：
ATX_Desk_v02_layout.f3d：可编辑的Fusion布局预览。
Perspective.png / Top.png：实际Fusion视图。
layout.json / interference.json：布局尺寸与本版检查记录。
Build_V02_Preview.py：新建文档重生成布局的源码；不覆盖V01。
