rapidrabbitsliu/pc-chassis-designs/outputs/ATX-Desk-v04-preview/README.txt

V04 布局预览：下层正面可拆遮线挡板

在V03基础上，按用户圈出的两把风扇下方正面位置加挡板。
主板、电源、上层双140风扇、CPU侧垂直/PCIe侧内收及底部290 mm宽度均沿用V03。

挡板方案
3 mm厚PETG，左右两片，中缝0.6 mm。
PCIe侧边缘跟随侧框内收斜度；CPU侧边缘垂直。
主遮挡面从离桌面8 mm处到182 mm高度，主面高174 mm。
上缘至主板横梁下缘留8 mm间隙；安装耳局部伸入上缘间隙。
面板位于正面框架外约1.4 mm，避免紧贴框架摩擦。
两片的最大平面尺寸约165.5×188.5、145.8×188.5 mm，适合256×256平台分件打印。
背面有隐藏的中缝连接耳，用于将两片连成整体，也可以分别拆卸。
前方挡板只遮线；不封电源CPU侧大风扇面，也不封电源后部排风面。
下层其余侧面保持开放；未进行温度或风量验证。

可拆固定方案（预览设计，待整机打印定稿一起核对）
上端M3×16两颗，下端M3×8两颗，中缝M3×6两颗。
M3、外径5、高4.5 mm热熔螺母共6颗：上横梁2、两侧框下固定点2、中缝背耳2。
上端间隔柱、下端间隔垫与面板一体；CPU侧框顶端增加小避让槽。
拆外部四颗固定螺丝可将拼好的面板整体取下；拆中缝两颗螺丝可分离左右片。
实际热熔孔径和螺丝长度仍需试片、试装核对，不以本预览直接量产。

检查
两片各为单一实体；完整时间线544项健康。
与框架及主板/电源/显卡/风扇简化包络一起检查，排除共面接触后实体干涉0处。
没有真实线束/插头的完整模型；8 mm上下间隙不是对所有插头可直接穿过的承诺。
理线、插拔大插头时可先拆下面板。

文件
ATX_Desk_v04_layout.f3d：可编辑完整布局预览。
Perspective.png：Fusion实际预览。
cover.json / layout.json / interference.json：尺寸和检查记录。
Sources/Add_Front_Cover.py：导入随包Base_v03.f3d并在新文档生成本版的脚本。

整机仍处于布局预览阶段；尚未完成全部结构紧固、打印支撑、实际装机与承载/热态验证。
