rapidrabbitsliu/pc-chassis-designs/outputs/ATX-Desk-v05-preview/README.txt

V05 布局预览，尚非最终打印版。
电源横放居中：150×140×86 mm，底面离桌30 mm，向下进风，向显卡接口方向排风。
电源几何中心由95降至73 mm；整机重心变化尚未计算。主板底面高度208 mm保持，底部支撑宽290 mm，CPU侧垂直，PCIe侧内收。
保留双140×140×25上层送风与前方遮线板。Internal.png临时隐藏遮线板展示内部。
底部横梁已移出电源投影。120 mm圆仅示意电源进风位置，实际开口仍需实物确认。
模型时间线健康，当前检查实体无体积干涉。紧固连接、热变形和实际装配仍待定稿。
