rapidrabbitsliu/pc-chassis-designs/outputs/ATX-Desk-v08-preview/README.txt

V08 布局预览，非最终打印版。
电源左右居中，向后平移60 mm；外形X77.4..227.4 Y111.92..251.92 Z30..116。出风面距后框外侧253.84约1.92 mm，底部进风间隙仍30 mm。
后框增加两根16 mm宽立柱，外侧局部斜撑，保留X68..236.8 Z16..125的完整尾部开口，名义168.8×109 mm。未按实物验证插头外壳、插拔手位及开关操作空间。
后框上下拼缝加入3 mm厚连接片及M3短热熔螺母试装孔。
底托重建：前横梁在电源前缘以外，后脚直接落在后框底梁；电源进风下方不加横向底板。定位架同步后移。
保留主板高度158、底宽290、双上层风扇及V07显卡后架。前部腾出理线空间，整机重心会向后变化，未量化或测试。
模型时间线健康，所检查实体无体积干涉；螺母孔4.6需PETG试块校准，其余底座连接、打印拆分和承载/热变形仍待定稿，不可按预览直接视为可打印终版。
