rapidrabbitsliu/pc-chassis-designs/outputs/ATX-Desk-v10-preview/README.txt

V10 布局预览，非最终打印版。
右侧CPU框架整体外移4 mm，垂直外表面与横梁端均为X302.45。左侧底脚同步向内移4 mm，底宽X12.45..302.45，实测模型290 mm。PCI侧倾斜内收由12.45增至16.45 mm，高140 mm。
主板和9孔不移动。PCB右边X304.8，比齐平的框架/横梁仍多2.35 mm，属于板边自身尺寸。
电源仍在主板下方中心，保持底部进风30 mm和V09左/右/前三面支撑、后方开放布局。地面支撑范围相对V09整体右移4 mm。
时间线健康、当前检查实体无体积干涉。未完成载荷/热变形、打印拆分接头、电源防脱及实卡挡板尺寸验证，不能直接视为最终打印文件。
