rapidrabbitsliu/pc-chassis-designs/outputs/ATX-Desk-v13/README.txt

V13 一体横梁与重新拆件版

2026-10-23 安装说明书：本方案登记为风格1。打开 Style1_V13_Assembly_Manual.html；单文件内嵌全部图，17件编号、21组热熔孔位和13步装配。维护包为 Style1_V13_Illustrated_Manual.zip。热熔孔已由V13 BRep独立复核为48个；M3x6固定用途46颗，显卡上耳按实物使用0至2颗，建议螺丝及短热熔螺母各备60。
装配补充：先组框架和托架，在上方仍敞开时放入并约束电源，再安装主板梁和显卡塔。底横条的四颗螺丝从底面向上安装，当前模型没有头部沉孔；四角必须加等高脚垫，净高大于实测螺丝头突出量，避免螺丝头顶桌面。这是装配说明补充，未修改CAD或打印工程。实际总高因脚垫增加。
说明书完成静态和直接插图核对；浏览器预览进程启动失败，实际排版、打印分页和交互未在浏览器验收。显卡挡板、实际散热器及线缆仍需实物适配。

交付：
ATX_Desk_v13_one_piece.f3d：Fusion 装配模型，17 个可打印单实体零件。
ATX-Desk-v13-All-Parts-9-Plates.3mf：Bambu Studio 最终保存的 9 盘项目。
PRINT_STL/：与 3MF 使用相同打印方向的毫米 STL，共 17 件；比例为 100%。
Raw_STL/：Fusion 原始导出，不建议直接用于摆盘。
plate-list.csv / plate-checks.json：每盘零件、方向后的尺寸、brim、支撑和位置。

相对 V12：
1. 后横梁重新建成一个连续实体，整体长 304.45 mm，取消中间搭接及其螺丝孔，保留两端承托、显卡塔安装、金属挡板下插脚避让和中间纵梁座。
2. 双风扇底部安装梁重新建成一个 284 mm 连续实体，四点固定到前框；两只风扇面板各增加两个安装耳，与底梁用螺丝固定。
3. 保留三根 243.84 mm 一体主板纵梁，九个主板安装中心不变。
4. 左右侧框、前框保持合理分件。补充四个前角连接、前框中缝上下两个一体连接耳、两根底横条的底搭接和固定孔、电源托架与底横条固定孔。
5. 多处固定孔增加标准 M3 螺丝头井，保留 3 mm 连接腹板，使 M3x6 有约 3 mm 螺纹啮合。显卡可调件改为背面锁紧、滑块内置短热熔螺母。
6. 电源托架增加两组细扎带穿孔，位于近似 120 mm 进风口投影之外，用于电源防脱。
7. 不再按照已打印情况分组；所有新版本零件重新分为 9 盘，不应混用旧版连接件。

硬件与装配：
以标准头 M3x6 和 M3 H4.5 OD5 热熔螺母为主。螺丝头井直径 6.6 mm；现有螺丝若为特殊大头、手拧头或带大垫片，需核对头部能否进入井内。打印孔 4.6/4.7 mm 需要结合实际热熔螺母试装，不能把螺母直接当冷压配合件。
M3x6 / 短热熔螺母按约 48 组预备：主板9、侧纵梁4、中纵梁2、后梁两端2、显卡塔底3、可调夹4、前框角4、前框中缝2、底横条两端4、电源托架4、风扇底梁4、风扇面板4、显卡上耳2。实卡上耳实际使用数量以实物为准。
风扇四角与风扇框之间使用风扇随附螺丝等匹配紧固件，另备。
电源防脱可用宽约 3 mm 的细扎带/绑带穿孔，选择足够长度，可串接；实机绕开 AC 插口、开关与排风网。绑带为定位防脱，主载荷由托架和框架承担。
热熔螺母先装好，再按底横条/侧框、前框、后横梁、托架、主板纵梁、显卡塔、风扇梁/面板的顺序组装。滑块的螺母从与塔贴合的一侧装入，螺丝从塔背面槽中的头井锁紧。先轻紧各处，再整体校正。

打印：
Bambu Lab A1 / 0.4 mm / PETG Basic / 0.20 mm 层高 / 5 道墙 / 40% gyroid / 顶6层、底5层，纹理 PEI。侧框 brim 3 mm，其余 5 mm；brim 间距 0.1 mm。支撑按对象设置，部分零件使用仅热床普通自动支撑。
第5盘为两根一体长梁平行斜放，未经放缩；第9盘为两根 274 mm 底横条平行斜放。
如重新打开 3MF 后需要，请重新切片；打印前将项目 PETG 材料映射到实际 AMS A4 PETG 并清空打印板。

验证范围：
Fusion 时间线健康；所有可打印件均为单个闭合实体；装配检查无体积干涉；后梁/侧框/显卡塔/中纵梁以及风扇梁/前框的接触距离为0。
导出网格为闭合一致法线网格，体积与 CAD 在0.3%以内一致；每件含 brim 均在 256x256 mm 内；同盘外轮廓保留 brim 间距。
实卡挡板位置仍应先试装确认。尚未进行整套 PETG 承重、长期温升和反复拆装测试；几何和切片检查不等于已完成实物认证。

Bambu Studio 2.7.1.62 实际切片结果：9盘全部完成，1175.48g（支撑34.89g），总52小时48分。每盘估计依次为12h45m、7h12m、7h04m、5h41m、5h14m、1h44m、1h44m、8h31m、2h54m。没有发送新打印任务。
