rapidrabbitsliu/pc-chassis-designs/outputs/ATX-Desk-v14/README.txt

风格1 V14 显卡支架实物配合修正版
2026-10-24

依据：用户三张实物照片；M3×6 蘑菇头直径约7 mm；V13凹槽实测约6 mm；用户确认上耳孔和平台均向显卡侧增加3 mm。

仅两件发生几何变化：
P12 显卡固定塔：上下四条螺丝头凹槽的CAD宽度由6.6改为8.2 mm；下槽通道贯通到加强筋外侧，保留Y260～263之间3 mm承压腹板。塔底三处螺丝头井也扩大为8.2 mm。名义宽度包含对既有打印缩差的补偿，实际打印后是否达到约7.5 mm净宽仍需实测。
P13 显卡上托片：两个热熔孔中心Y由249.5改为246.5，即向显卡侧−Y平移3 mm；平台前缘也由244.84延伸至241.84，正好增加3 mm。平台原厚度10 mm保留；螺母外径5 mm时前缘剩余材料约2.16 mm。新试孔直径4.7 mm，高4.5外径5的短热熔螺母；不能直接换H8。原位置两个孔已取消，没有留下双孔或长圆热熔孔。
P14下插脚座及其余14件沿用V13，共15件未改。

文件：
ATX_Desk_v14_gpu_fit.f3d：完整17件Fusion装配，V13原模型未覆盖。
REPRINT_STL/P12_V14_GPU_Tower.stl：只补打的显卡塔，已按打印方向平放，毫米单位、100%。
REPRINT_STL/P13_V14_Upper_Ear_Ledge.stl：只补打的上托片，同上。
PRINT_STL/：完整17件毫米打印网格；不要混淆相同文件名的V13旧件。
Style1_V14_GPU_Replacements_1_Plate_UNSLICED.3mf：上述两件已摆在同一盘，继承V13的A1 0.4/PETG、0.2层高、5墙、40%Gyroid、顶6底5、245/70°C和5 mm brim。P12普通自动支撑、仅热床；P13无支撑。尚未在Bambu Studio重切片，不能直接发送打印。打开后重新切片并核对预览、材料映射和实际空板。
verification.json：连续螺丝头量规、结构与参考包络检查。
mesh_checks.json / replacement-plate-checks.json：网格闭合、尺寸及含brim摆盘检查。
Fit_Photos/：本次实物问题记录；Sources/：建模和打包维护源。

建议先打印较小的P13，冷却后对照实卡检查3 mm偏移及平台延长，再做热熔；正式压入前仍在同材料试孔确认配合。
本版可沿用V13装配说明中的其余步骤和P编号；P12/P13的孔槽尺寸及孔位应以本修订为准，V13图中的旧上耳坐标不再适用。

验证与实际限制：
17件均为单个闭合实体，时间线健康；打印结构件之间无体积干涉。
上下各两条滑槽均使用Ø7.5 mm量规沿完整滑动范围和整个后方进入通道连续扫掠检查，修改前四条均被挡，修改后相交体积均为0。该结果验证CAD空间，不等于打印净宽或实物强度验证。
平台前伸后，与原先“完整长方体”显卡参考包络有800 mm³交叠，前后方向约2 mm；参考包络没有描述真实金属挡板、背板和散热器的局部轮廓。保留此结果，不据此宣称整机零干涉，P13仍应先与实卡试装。
除显卡塔外的V13其他螺丝头井仍保留原尺寸，不保证直径约7 mm的蘑菇头可直接进入；如同款螺丝在其他位置也偏紧，须逐处核对。
尚未进行本次两件的新打印、承重、长期PETG蠕变及温升测试。未发送打印任务。
