rapidrabbitsliu/pc-chassis-designs/outputs/ATX-Desk-v15/README.txt

风格1 V15 上托片平台长度修订
2026-10-24

按用户最终要求：平台相对V13延长2 mm；两个螺母孔仍向显卡侧前移3 mm。其他V14改动均保留。

P13平台前缘Y=242.84；两个热熔孔中心X=100/120、Y=246.5，孔径4.7 mm。高4.5、外径5的M3短热熔螺母前方剩余材料约1.16 mm。先用同材料试孔确认热熔效果；缓慢同轴压入，防止薄壁鼓起或压歪。
P12显卡塔与V14完全相同：上下四条头部通道及底部头井CAD宽8.2 mm，下通道已贯穿加强筋，保留3 mm承压腹板。此前完整Ø7.5 mm量规检查继续适用于未修改的P12。
相对V14仅P13变化，另16件未变；相对V13仅P12和P13为新件。

ATX_Desk_v15_gpu_fit.f3d：完整17件Fusion模型。
REPRINT_STL/P13_V15_Upper_Ear_Ledge.stl：本次只需更新的P13。
REPRINT_STL/P12_V15_GPU_Tower.stl：与V14的P12相同，已采用V14 P12时无需再次更换。
PRINT_STL/：完整17件、毫米单位、指定打印方向。
Style1_V15_GPU_Replacements_1_Plate_UNSLICED.3mf：P12/P13同盘，A1 0.4/PETG基线，P12普通自动支撑仅热床，P13无支撑。尚未重新切片；打开后核对预览、材料映射和空板，再发送打印。

验证：两处螺母孔中心保持不变；从V14平台前缘精确去除1 mm，体积差700 mm³；其余16件体积未变。17件单闭合实体，结构件间无体积干涉，时间线健康，网格和含brim打印包络已检查。
平台与简化显卡方盒仍有约1 mm的前后包络重叠，实物挡板附近的局部形状仍需试装。未进行本次新打印及热熔实测；未发送打印任务。

Bambu Studio 十盘更新（2026-10-24）：
Style1_V15_All_Parts_10_Plates_With_Temporary_Repair.3mf：已在 Bambu Studio 打开并原生保存。原九盘名称、已打标记及配置保留，原 P12/P13 替换为 V15；第10盘“临时修补”额外放 P12/P13 两件。
第10盘已在软件中切片通过：预计总时间6小时9分，PETG 132.17 g（43.96 m）。0.2 mm、5壁、40% gyroid；P12普通自动支撑仅热床，P13无支撑，5 mm brim。工程保存模型和参数，不嵌入G-code，重新打开时可重新切片。未发送打印。
Source_User_V13_9_Plates_Before_Update.3mf 为更新前用户九盘工程备份。
