rapidrabbitsliu/pc-chassis-designs/outputs/ATX-Desk-v06-preview/README.txt

V06 布局预览，尚非最终打印版。
主板底面由208降到158 mm，显卡/固定架/双140风扇同步降低50 mm。
电源保持居中横放，底面30、顶面116 mm，向下进风，朝接口侧排风。主板底面与电源顶面间距42 mm；最低横梁128 mm，固定架顶125 mm，局部仅3 mm间隙。
移除前遮线板及原左右支撑墙，改前后承重框架；两侧只保留低位连接条与顶部纵梁。前侧斜撑，后侧大排风开窗。
底部宽290 mm，PCIe端向内收、CPU端垂直。
时间线健康，当前检查实体无体积干涉。此版用于比较布局，紧固件/拆分接头/热熔螺母连接/载荷和热变形尚待定稿验证，不能直接作为最终打印文件。电源进风圆为近似示意。
