rapidrabbitsliu/pc-chassis-designs/outputs/ATX-Desk-v07-preview/README.txt

V07 显卡后挡板固定结构概念预览，未作承载试验，不可直接作为最终打印版。
保留V06总体布局。后架重建：壁厚10，底脚8 mm，增加后向三角筋。底脚三处M3通孔对应后框架短热熔螺母试装孔。
上折耳：10 mm厚水平承托台，双下加强筋，短M3热熔螺母孔；上座高低可调总行程30 mm。折耳孔暂定X100/120 Y249.5，承托面Z282，均需实物核对。
下插脚：双贯通定位槽，暂定中心X96/116，槽长14宽2.4 mm，可向上调8 mm；名义位置底部由底脚限制。下方底脚及后框架同步贯通避让，不能强行用定位槽将显卡向下拉。
热熔螺母孔径4.6为试孔值，配用户M3×4.5×5短螺母，需PETG试块校准。
上/下滑座使用M3贯穿螺丝、垫片及背面螺母锁紧。现有6 mm螺丝不足以连接滑座与10 mm塔壁，也不足以固定8 mm底脚，需另配较长螺丝，最终长度待连接与垫片确定。
显示接口窗口为布局预留，实卡接口及插头外廓需复核。
当前模型时间线健康，检查实体无体积干涉，不等于已验证GPU金属挡板装配或PETG强度。实际折耳高度、插脚间距/厚度/伸出长度及挡板平面仍待实测。
