rapidrabbitsliu/pc-chassis-designs/outputs/ATX-Desk-v09-preview/README.txt

V09 布局预览，非最终打印版。
左/右/前三面框架支撑，后侧去除立柱和底框，仅保留显卡支架下方上横梁。上横梁中缝增加M3连接片。
电源恢复X152.4 Y121.92居中，底面Z30，向下进风。删除上方两个门形固定框，保留底托和低矮限位块，最终电源防脱紧固方式仍待确定。
CPU侧主板横梁端从X308.8收到302.45（缩短6.35）；孔柱中心X298.45、半径4，因此保留至302.45以不削薄孔柱，较CPU底框外面298.45仍突出4 mm。主板PCB原宽304.8，仍略有自然悬出。9个孔中心保持。
主板底面158、底部宽290保持，CPU侧垂直，PCIe侧内收。左右框架长度247.84，打印方向与接头尚需定稿。
当前时间线健康，所检查实体无体积干涉。无承载或热变形测试。主板横梁的打印拆分、各框架连接及电源防脱仍须完成；V07显卡实物挡板孔位和插脚尺寸仍待核对。
