rapidrabbitsliu/pc-chassis-designs/outputs/ATX-Desk-v11-preview/Joint_detail.png

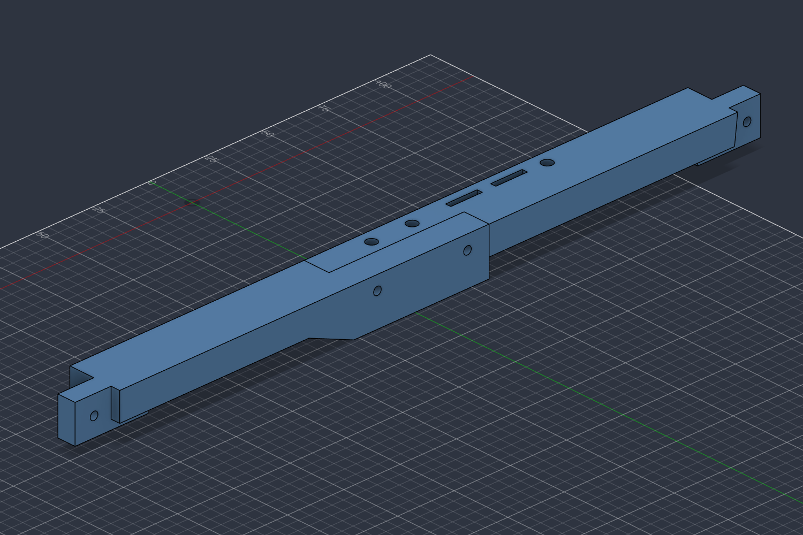
outputs/ATX-Desk-v11-preview/Joint_detail.png
