rapidrabbitsliu/pc-chassis-designs/outputs/ATX-Desk-v11-preview/Rear.png

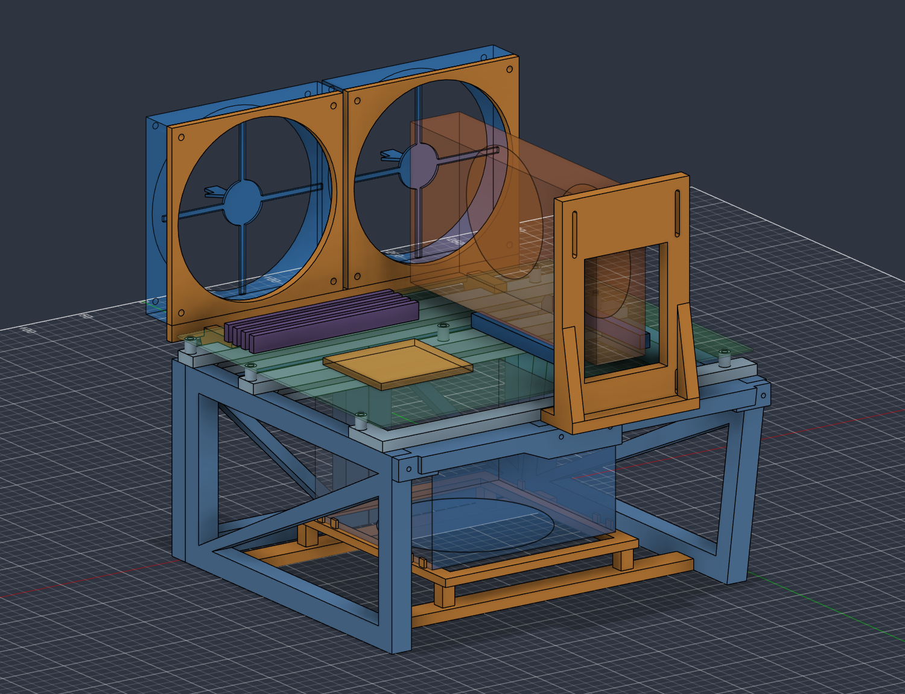
outputs/ATX-Desk-v11-preview/Rear.png
