rapidrabbitsliu/pc-chassis-designs/outputs/board-alignment/motherboard-top-alignment.png

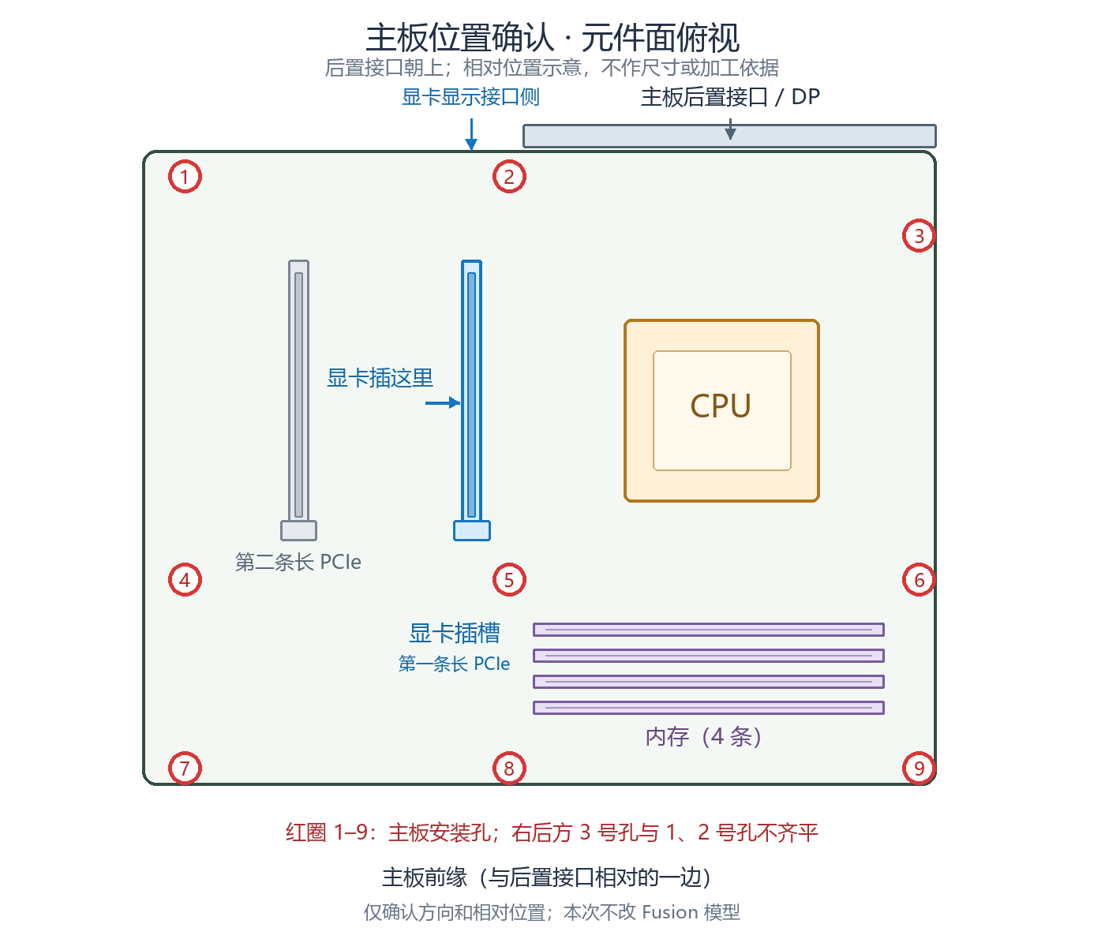
outputs/board-alignment/motherboard-top-alignment.png
