rapidrabbitsliu/pc-chassis-designs/work/atx-reference/holes.png

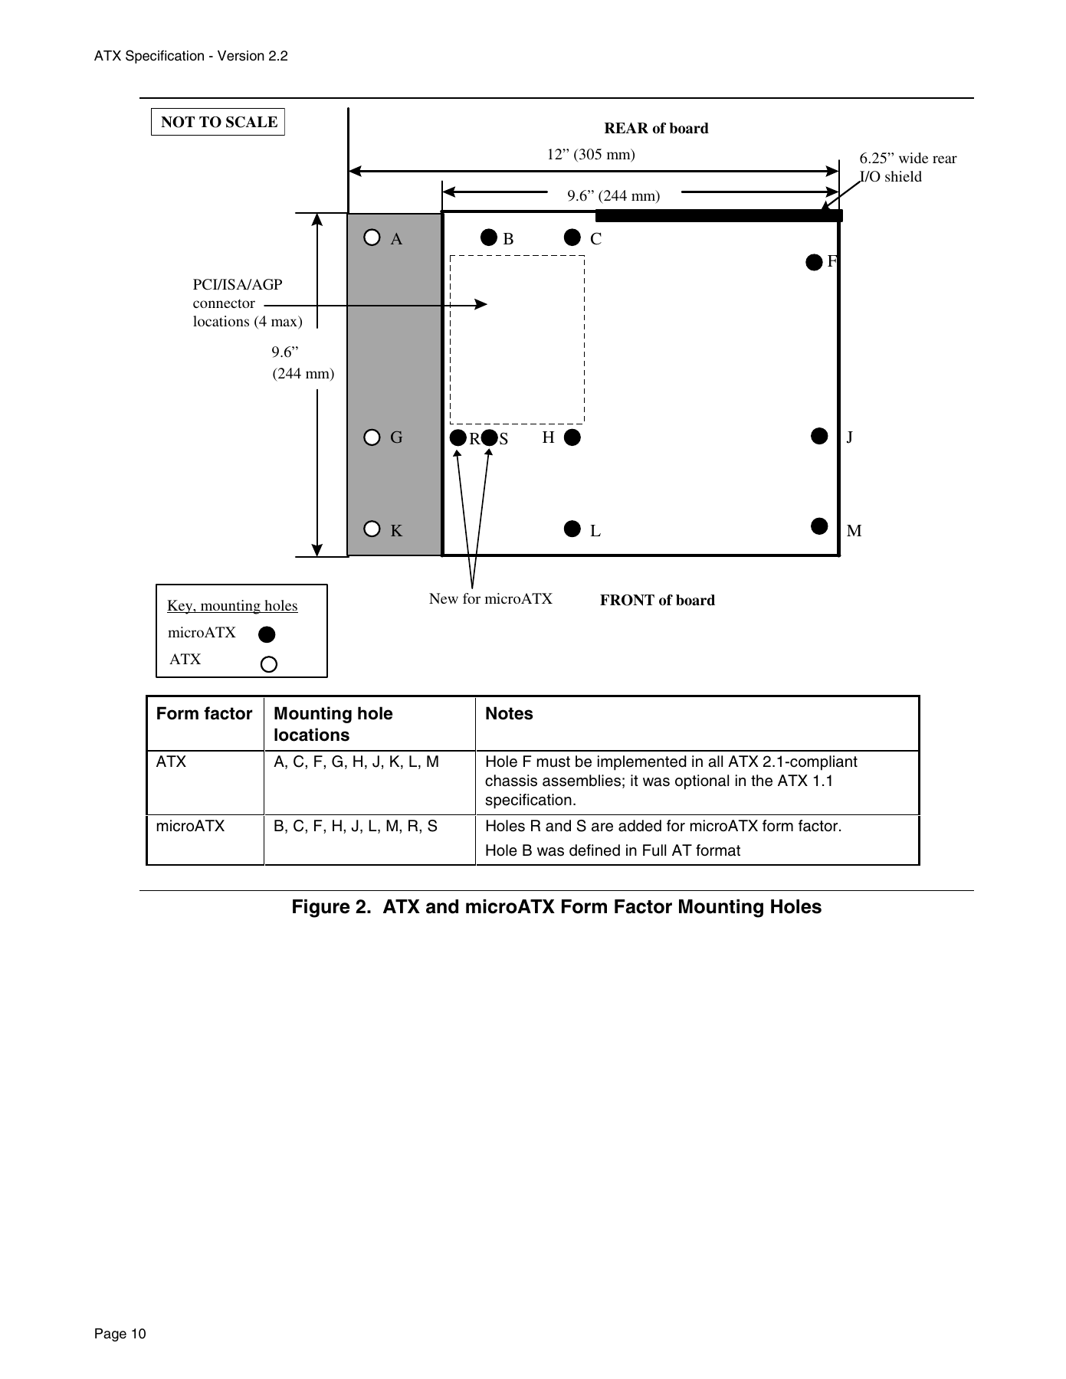
work/atx-reference/holes.png
