rapidrabbitsliu/pc-chassis-designs/work/atx-reference/layout.png

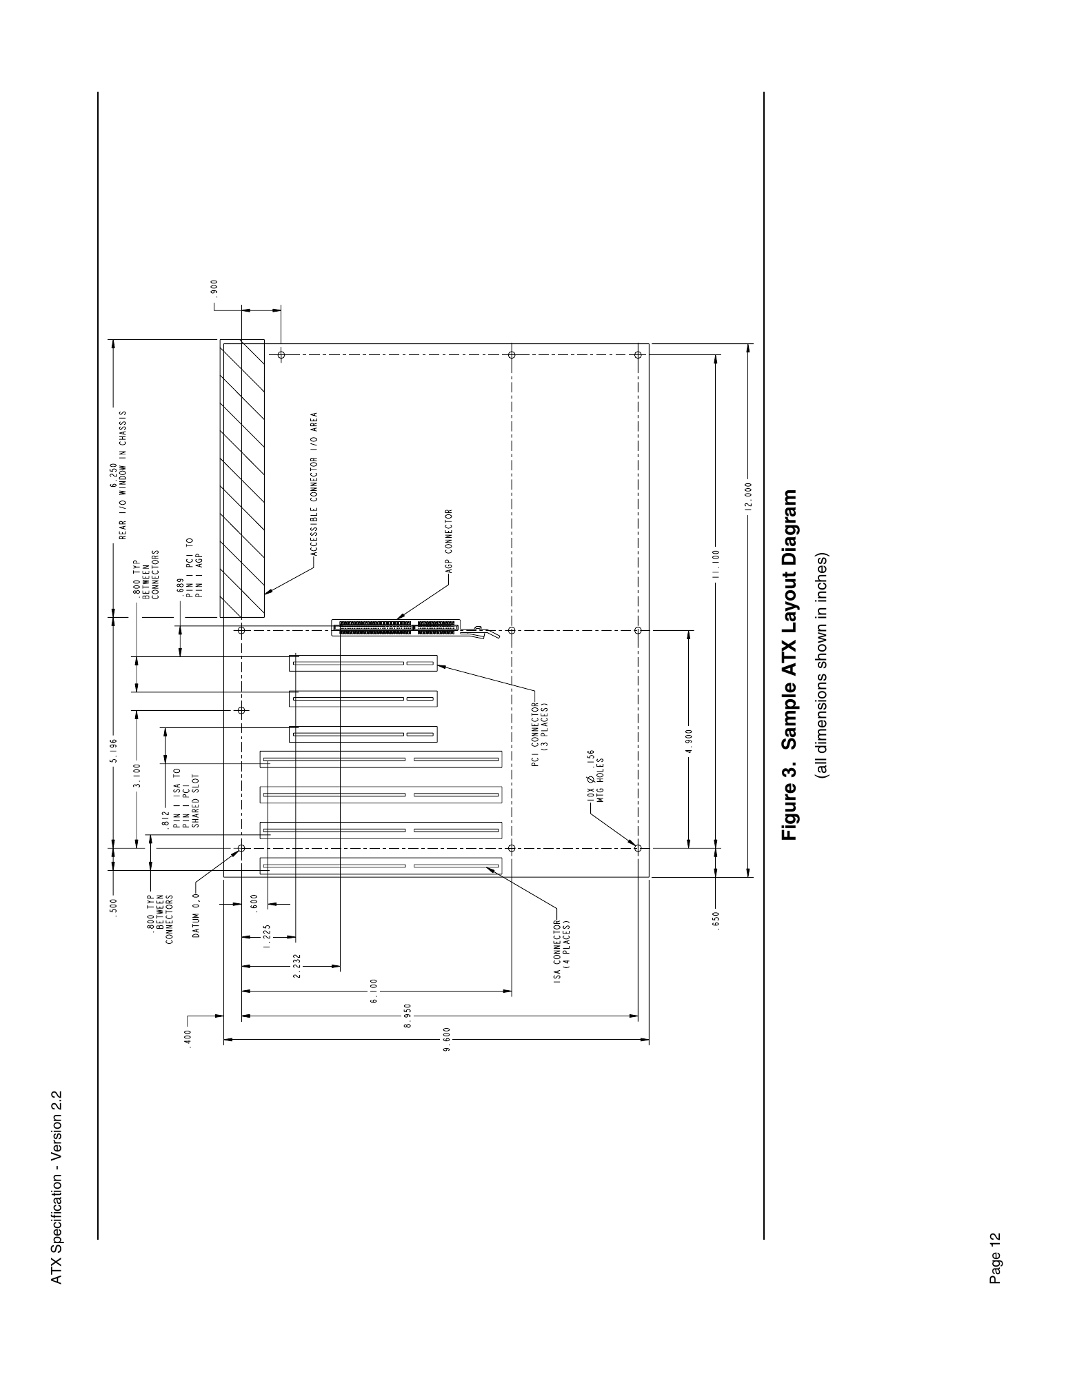
work/atx-reference/layout.png
