rapidrabbitsliu/pc-chassis-designs/work/atx-reference/layout_rot.png

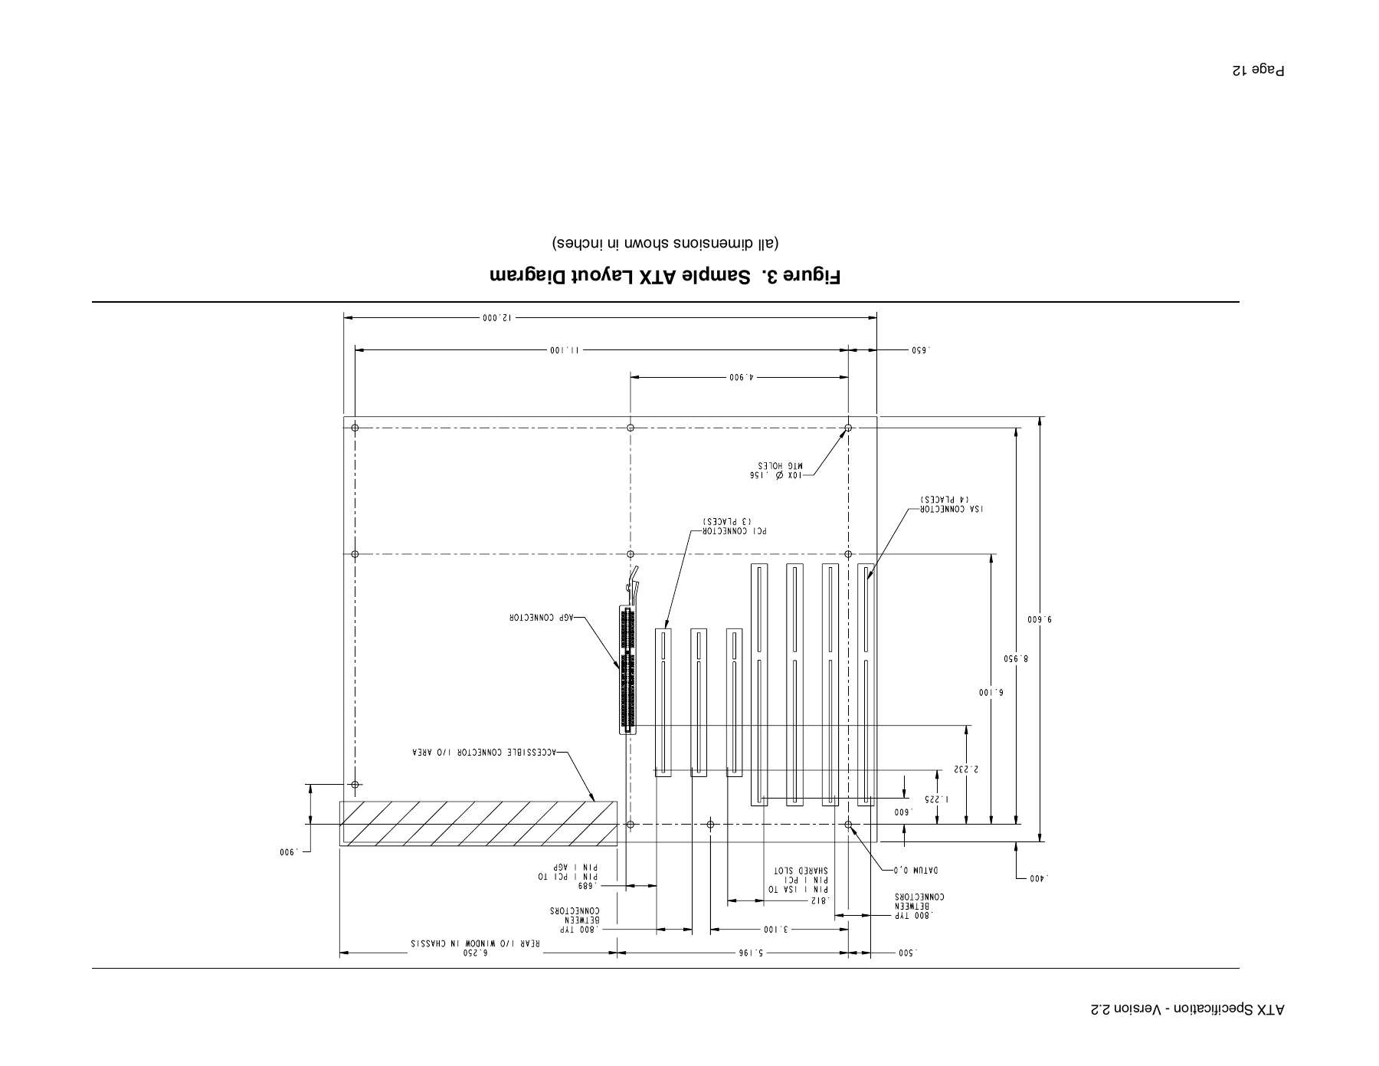
work/atx-reference/layout_rot.png
