rapidrabbitsliu/pc-chassis-designs/work/atx-reference/layout_upright.png

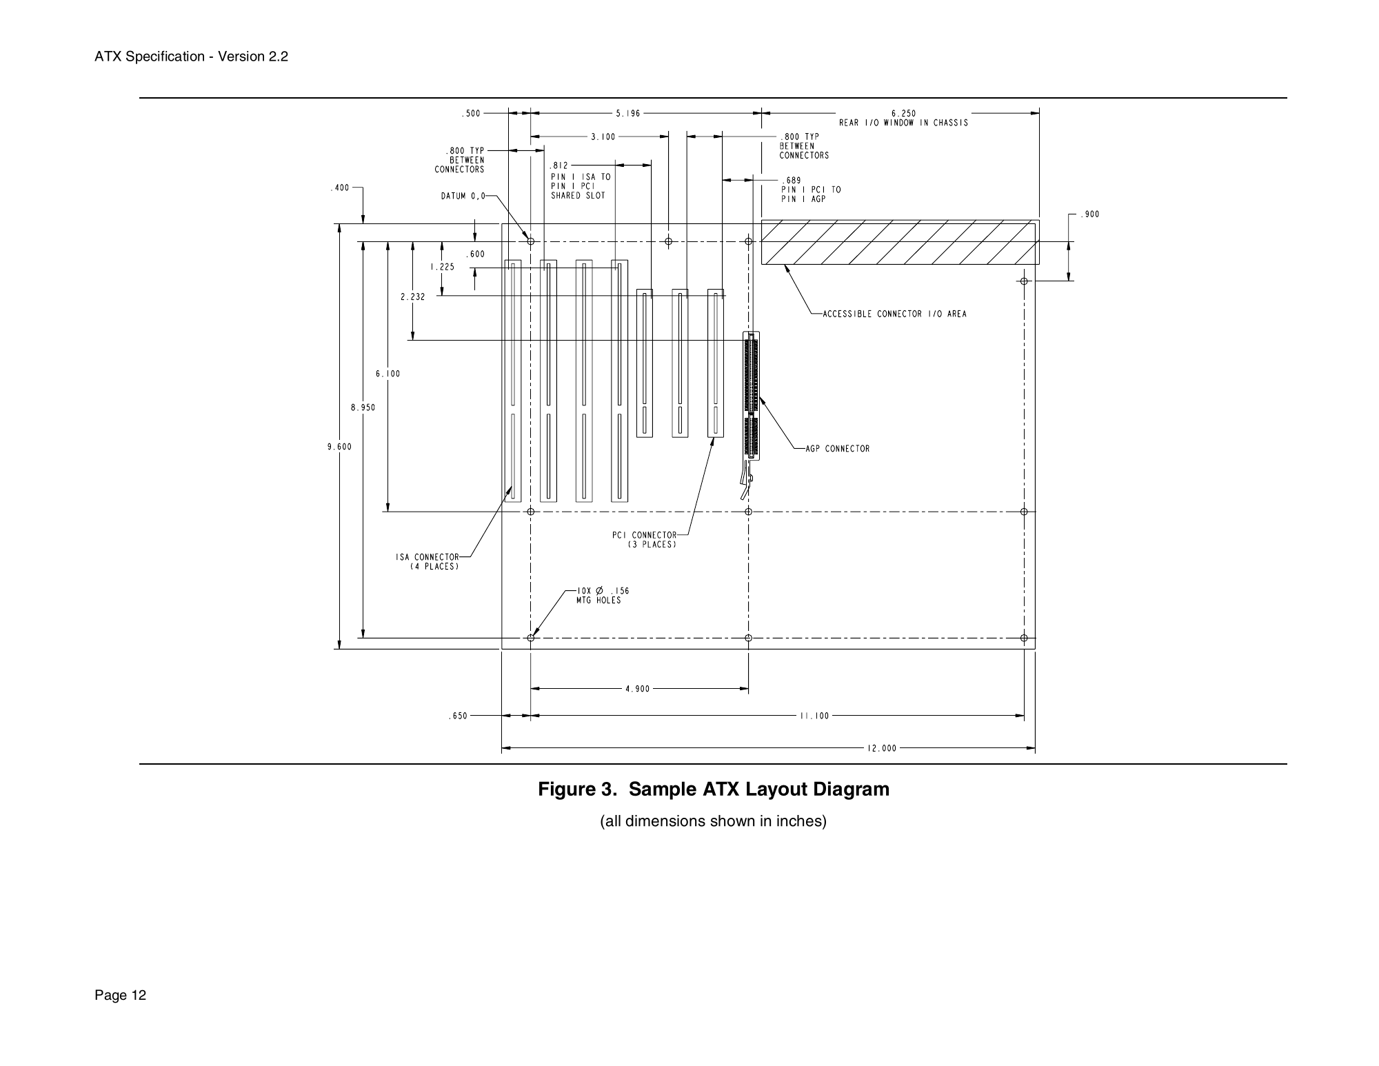
work/atx-reference/layout_upright.png
