rapidrabbitsliu/pc-chassis-designs/work/atx-reference/msi-layout.png

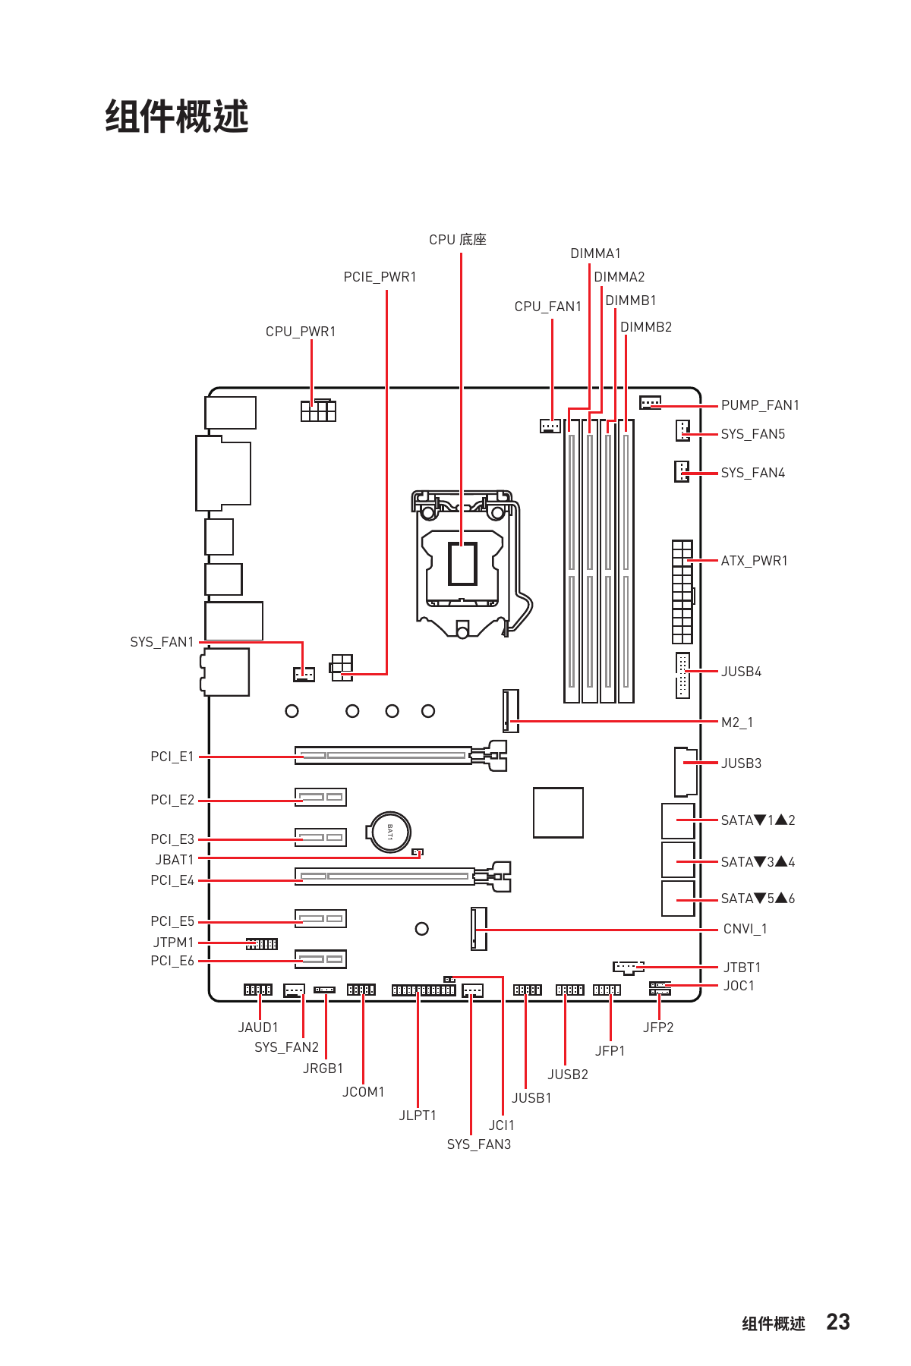
work/atx-reference/msi-layout.png
