rapidrabbitsliu/pc-chassis-designs/outputs/First-Print-V12/FIRST_CPU_Mainboard_Rail_V12.3mf

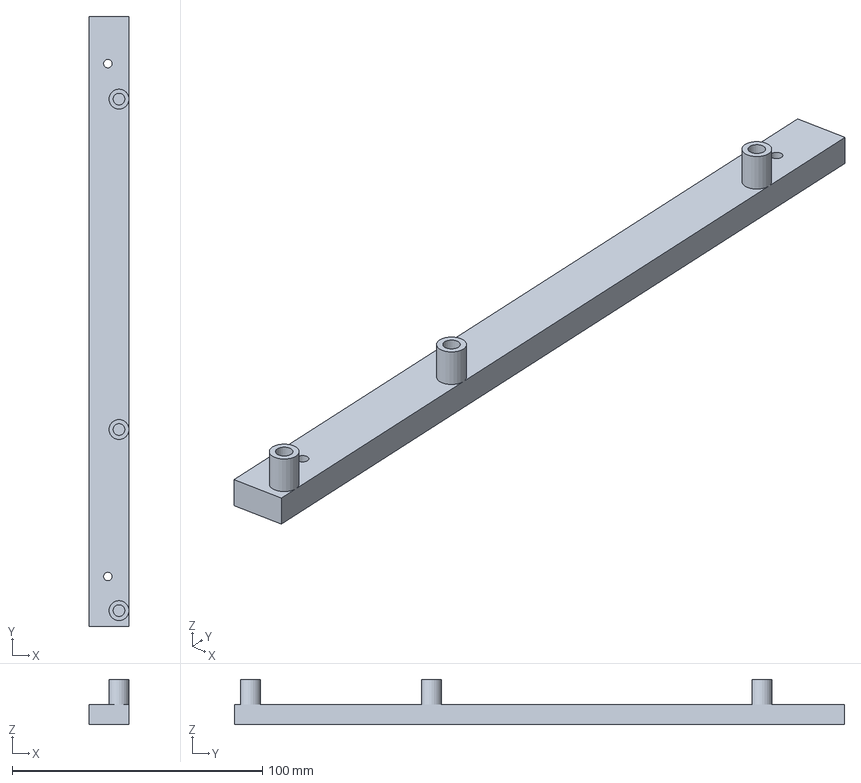
[picture p11: CAD file, 2026-10-24]
outputs/First-Print-V12/FIRST_CPU_Mainboard_Rail_V12.3mf
16.0 x 243.8 x 18.0 mm
