rapidrabbitsliu/pc-chassis-designs/outputs/ATX-Desk-v12-MultiPlate.3mf

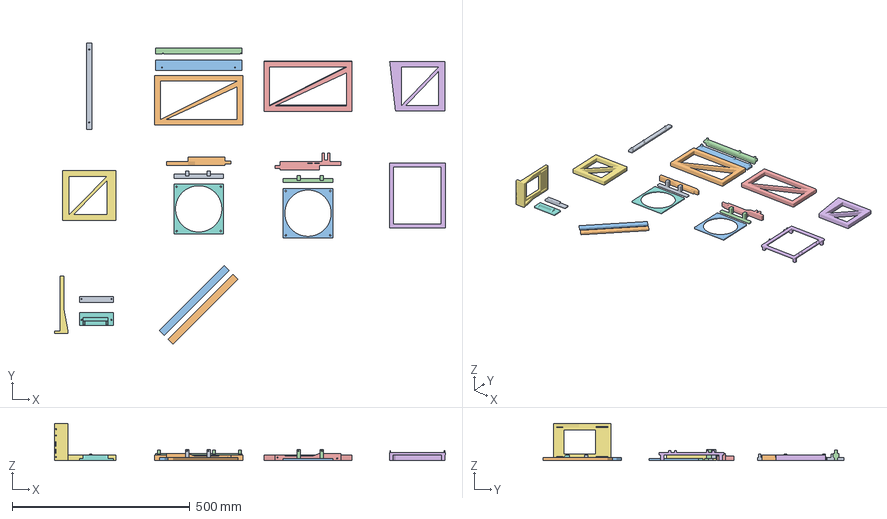
[picture p12: CAD file, 2026-10-24]
outputs/ATX-Desk-v12-MultiPlate.3mf
1098.6 x 847.0 x 104.0 mm
ALREADY_PRINTED_19_CPU_LONGITUDINAL_BOARD_RAIL_243_84mm.stl
16_CPU_VERTICAL_SIDE_FLUSH_TO_BEAM.stl
19_PCI_LONGITUDINAL_BOARD_RAIL_243_84mm.stl
19_MID_LONGITUDINAL_BOARD_RAIL_243_84mm.stl
16_PCI_INSET_SIDE_16_45mm.stl
12_front_PCI_SUPPORT_FRAME.stl
12_front_CPU_SUPPORT_FRAME.stl
10_GPU_140_FAN_MOUNT.stl
20_GPU_INDEPENDENT_FAN_SHOE_140mm.stl
18_REAR_BEAM_CPU_END_AND_REAR_LAP.stl
10_CPU_140_FAN_MOUNT.stl
20_CPU_INDEPENDENT_FAN_SHOE_140mm.stl
18_REAR_BEAM_PCI_TAPERED_END_AND_FRONT_LAP.stl
05_CENTERED_FLAT_PSU_CRADLE_OPEN_INTAKE.stl
07_GPU_REINFORCED_REAR_TOWER.stl
08_GPU_UPPER_EAR_LEDGE_ADJUSTABLE.stl
08_GPU_LOWER_TWO_TAB_RECEIVER_ADJUSTABLE.stl
04_front_GROUND_BAR_290mm_FLAT_PSU.stl
04_rear_GROUND_BAR_290mm_FLAT_PSU.stl
