rapidrabbitsliu/pc-chassis-designs/outputs/ATX-Desk-v24/PRINT_STL/12_front_PCI_SUPPORT_FRAME.stl

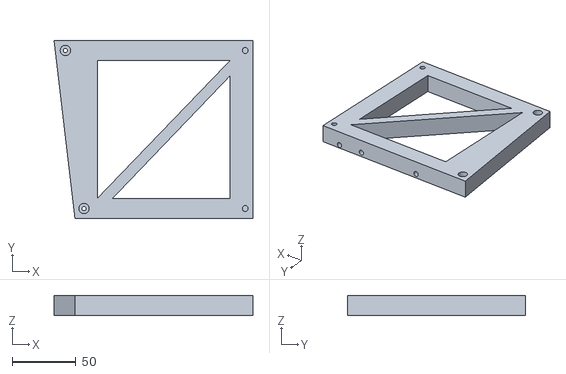
[picture p13: CAD file, 2026-11-01]
outputs/ATX-Desk-v24/PRINT_STL/12_front_PCI_SUPPORT_FRAME.stl
156.1 x 140.0 x 16.0
