rapidrabbitsliu/pc-chassis-designs/outputs/ATX-Desk-v24/Style1_V24_All_Latest_Parts_9_Plates.3mf

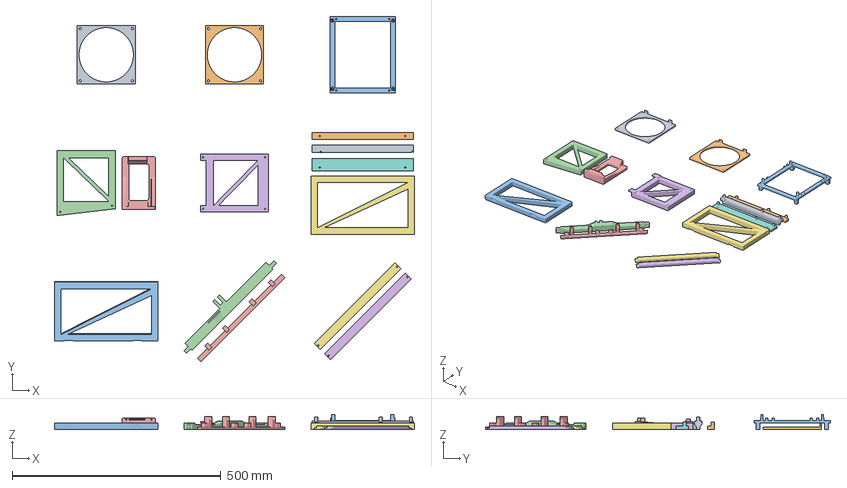
[picture p14: CAD file, 2026-11-01]
outputs/ATX-Desk-v24/Style1_V24_All_Latest_Parts_9_Plates.3mf
862.2 x 827.0 x 36.0 mm
LATEST_V24_10_GPU_140_FAN_MOUNT.stl
LATEST_V24_10_CPU_140_FAN_MOUNT.stl
LATEST_V24_05_CENTERED_FLAT_PSU_CRADLE_OPEN_INTAKE.stl
LATEST_V24_12_front_PCI_SUPPORT_FRAME.stl
LATEST_V24_07_GPU_INTEGRATED_LIGHTWEIGHT_FRAME.stl
LATEST_V24_12_front_CPU_SUPPORT_FRAME.stl
LATEST_V24_16_CPU_VERTICAL_SIDE_FLUSH_TO_BEAM.stl
LATEST_V24_19_PCI_LONGITUDINAL_BOARD_RAIL_243_84mm.stl
LATEST_V24_19_MID_LONGITUDINAL_BOARD_RAIL_243_84mm.stl
LATEST_V24_19_CPU_LONGITUDINAL_BOARD_RAIL_243_84mm.stl
LATEST_V24_16_PCI_INSET_SIDE_16_45mm.stl
LATEST_V24_18_ONE_PIECE_REAR_LOAD_BEAM_304_45mm.stl
LATEST_V24_20_ONE_PIECE_DUAL_140_FAN_RAIL_284mm.stl
LATEST_V24_04_front_GROUND_BAR_290mm_FLAT_PSU.stl
LATEST_V24_04_rear_GROUND_BAR_290mm_FLAT_PSU.stl
