rapidrabbitsliu/pc-chassis-designs/outputs/Hook-Fit-v03/raw_depth_4.2.stl

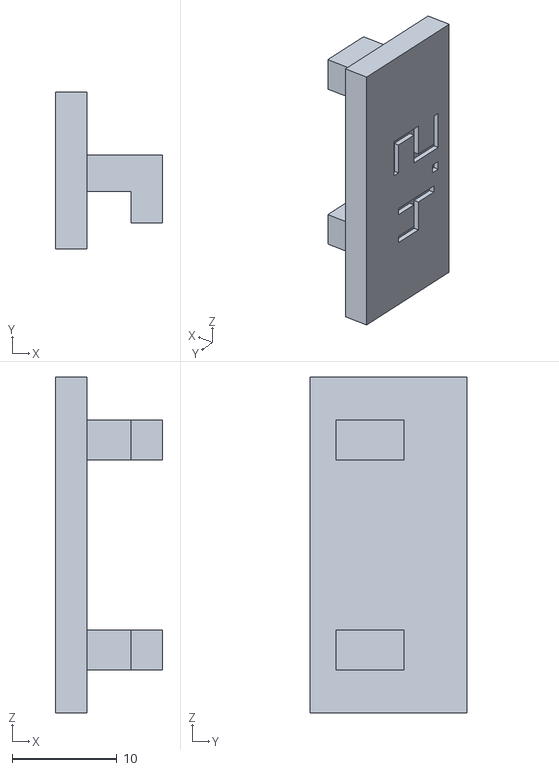
[picture p15: CAD file, 2026-10-24]
outputs/Hook-Fit-v03/raw_depth_4.2.stl
10.2 x 15.0 x 32.0
