rapidrabbitsliu/pc-chassis-designs/outputs/Single-Bracket-v05/raw_Bracket.stl

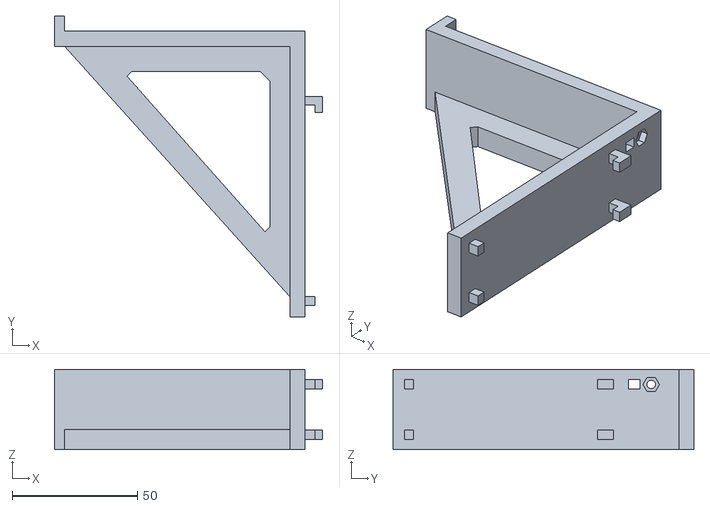
[picture p16: CAD file, 2026-10-24]
outputs/Single-Bracket-v05/raw_Bracket.stl
107.0 x 120.0 x 32.0
