rapidrabbitsliu/pc-chassis-designs/outputs/Style2-v09/Manual_Refs/REF_ENERMAX_UPRIGHT_EXHAUST_MINUS_X_FAN_PLUS_Y.stl

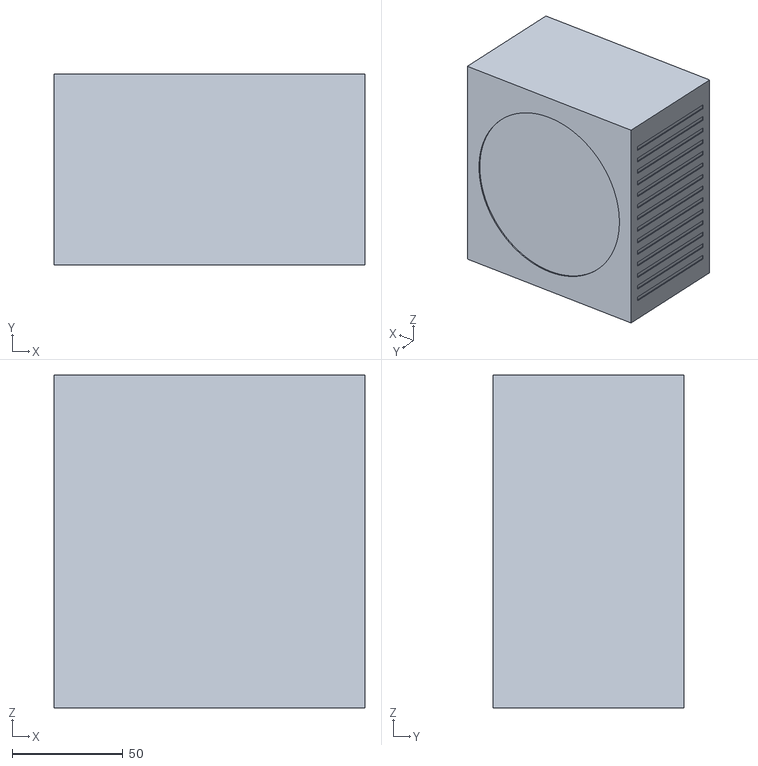
[picture p17: CAD file, 2026-10-24]
outputs/Style2-v09/Manual_Refs/REF_ENERMAX_UPRIGHT_EXHAUST_MINUS_X_FAN_PLUS_Y.stl
140.0 x 86.0 x 150.0
