rapidrabbitsliu/pc-chassis-designs/outputs/Style2-v09/PRINT_STL/03_UPPER_CROSSBAR.stl

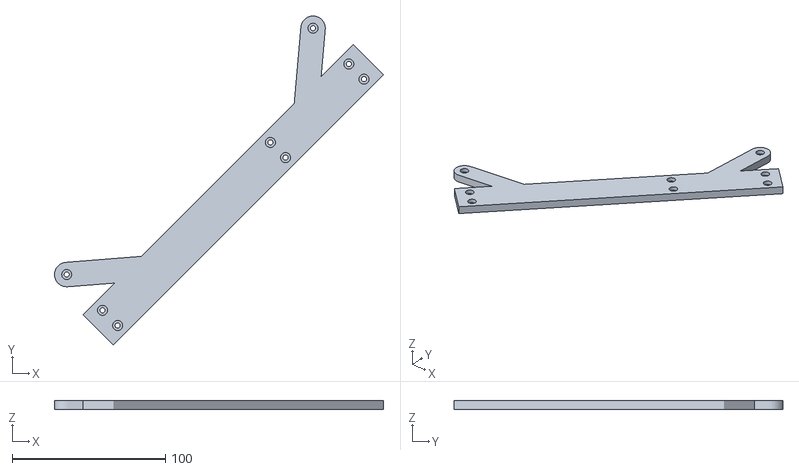
[picture p18: CAD file, 2026-10-24]
outputs/Style2-v09/PRINT_STL/03_UPPER_CROSSBAR.stl
214.7 x 214.7 x 6.00
