rapidrabbitsliu/pc-chassis-designs/outputs/Style2-v09/Raw_STL/09_PSU_SADDLE_REAR.stl

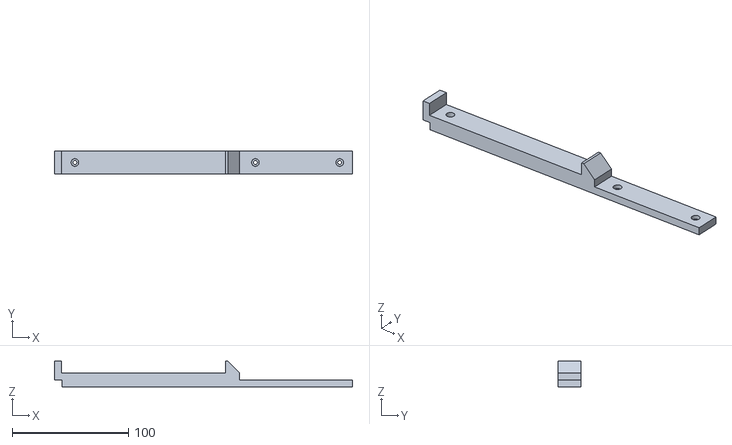
[picture p19: CAD file, 2026-10-24]
outputs/Style2-v09/Raw_STL/09_PSU_SADDLE_REAR.stl
255.8 x 20.0 x 22.0
