rapidrabbitsliu/pc-chassis-designs/outputs/Style2-v09/Style2_V09_A1_PETG_All_Parts_13_Plates.3mf

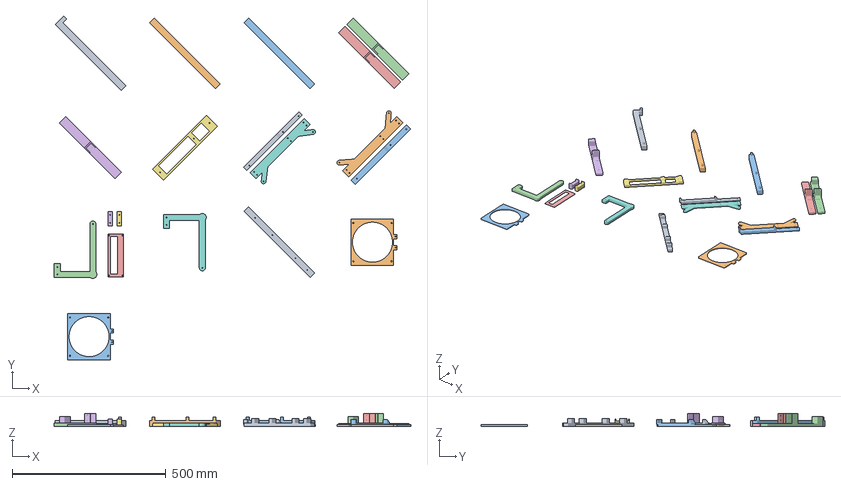
[picture p20: CAD file, 2026-10-24]
outputs/Style2-v09/Style2_V09_A1_PETG_All_Parts_13_Plates.3mf
1159.7 x 1118.7 x 42.0 mm
01_UPRIGHT_1.stl
01_UPRIGHT_2.stl
01_UPRIGHT_3.stl
02_FOOT_1.stl
02_FOOT_2.stl
02_FOOT_3.stl
06_GPU_CARRIER.stl
03_LOWER_CROSSBAR.stl
09_PSU_SADDLE_FRONT.stl
03_UPPER_CROSSBAR.stl
09_PSU_SADDLE_REAR.stl
05_SIDE_RECTANGULAR_FRAME_1.stl
07_RISER_TRAY_PENDING_MEASUREMENT.stl
08_GPU_PAD_LEFT_FIT_REQUIRED.stl
08_GPU_PAD_RIGHT_FIT_REQUIRED.stl
05_SIDE_RECTANGULAR_FRAME_3.stl
10_FAN_MAST_RIGHT_SIDE.stl
11_FAN_PANEL_GPU_140mm.stl
11_FAN_PANEL_CPU_RAM_140mm.stl
