rapidrabbitsliu/pc-chassis-designs/outputs/ATX-Desk-v24/PRINT_STL/10_CPU_140_FAN_MOUNT.stl

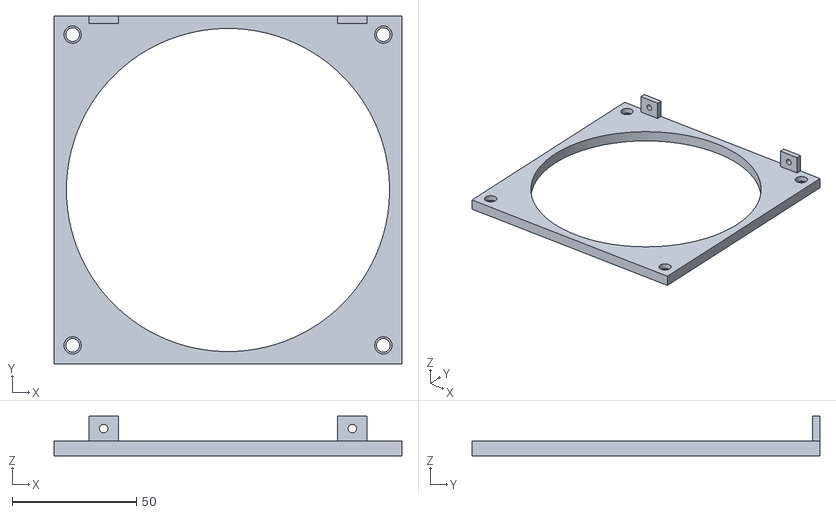
[picture p21: CAD file, 2026-11-01]
outputs/ATX-Desk-v24/PRINT_STL/10_CPU_140_FAN_MOUNT.stl
140.0 x 140.0 x 16.0
