rapidrabbitsliu/pc-chassis-designs/outputs/Single-Bracket-v05/raw_AntiLiftKey.stl

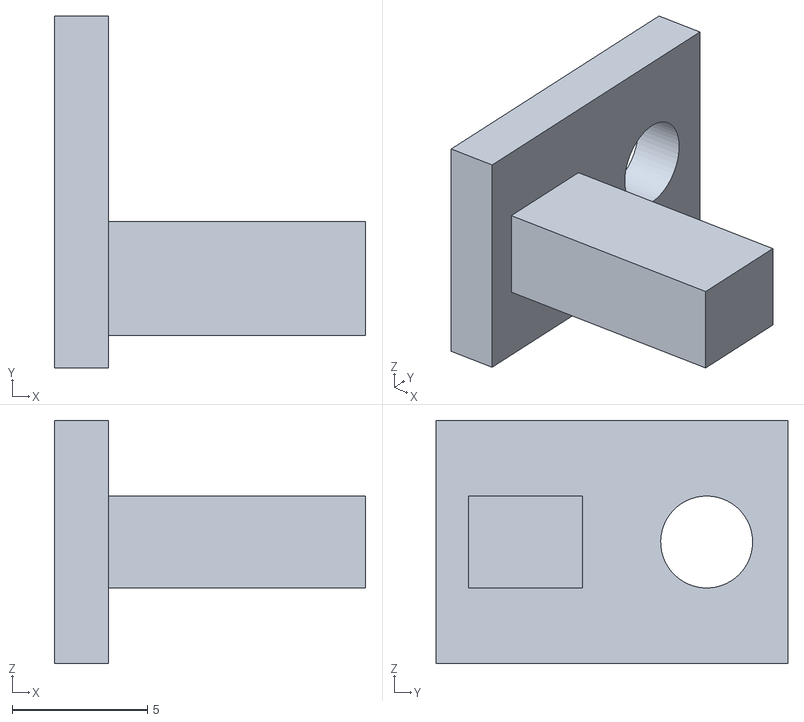
[picture p22: CAD file, 2026-10-24]
outputs/Single-Bracket-v05/raw_AntiLiftKey.stl
11.5 x 13.0 x 9.00
