rapidrabbitsliu/pc-chassis-designs/outputs/Style2-v09/Manual_Refs/REF_FAN_GPU_140x140x25_FLOW_MINUS_X.stl

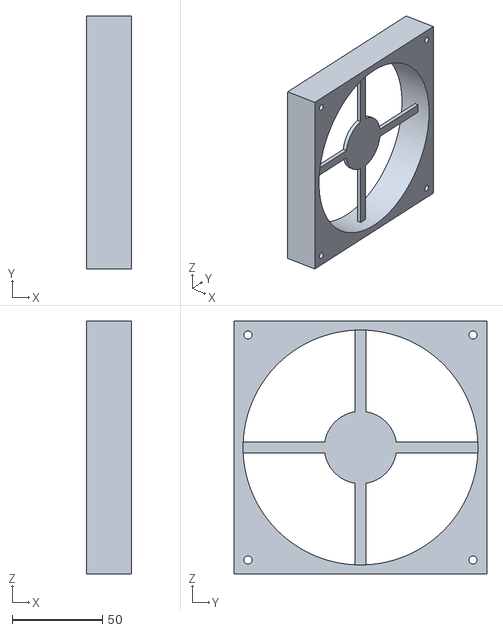
[picture p23: CAD file, 2026-10-24]
outputs/Style2-v09/Manual_Refs/REF_FAN_GPU_140x140x25_FLOW_MINUS_X.stl
25.0 x 140.0 x 140.0
