rapidrabbitsliu/pc-chassis-designs/outputs/Style2-v09/Raw_STL/07_RISER_TRAY_PENDING_MEASUREMENT.stl

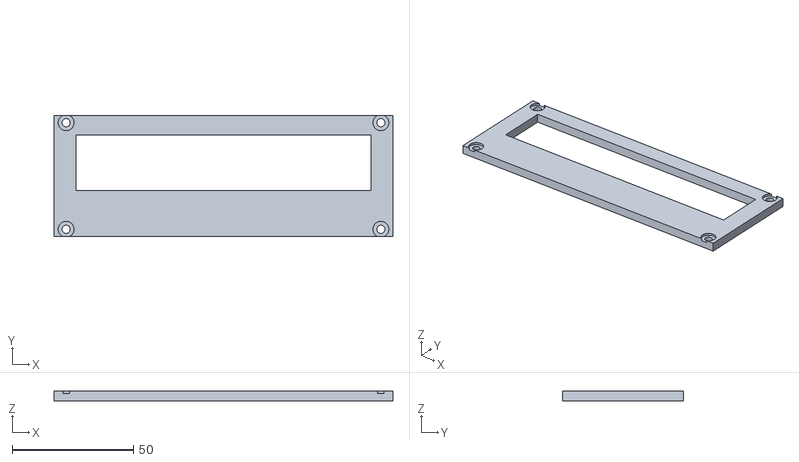
[picture p24: CAD file, 2026-10-24]
outputs/Style2-v09/Raw_STL/07_RISER_TRAY_PENDING_MEASUREMENT.stl
140.0 x 50.0 x 4.00
