rapidrabbitsliu/pc-chassis-designs/outputs/ATX-Desk-v12-print-review/PRINT_STL/18_REAR_BEAM_PCI_TAPERED_END_AND_FRONT_LAP.stl

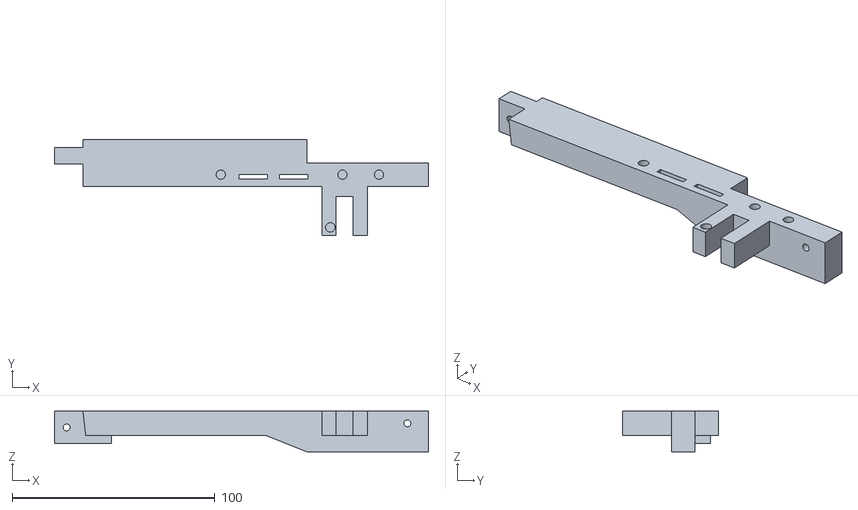
[picture p25: CAD file, 2026-10-24]
outputs/ATX-Desk-v12-print-review/PRINT_STL/18_REAR_BEAM_PCI_TAPERED_END_AND_FRONT_LAP.stl
184.4 x 47.3 x 20.0
