rapidrabbitsliu/pc-chassis-designs/outputs/ATX-Desk-v24/PRINT_STL/18_ONE_PIECE_REAR_LOAD_BEAM_304_45mm.stl

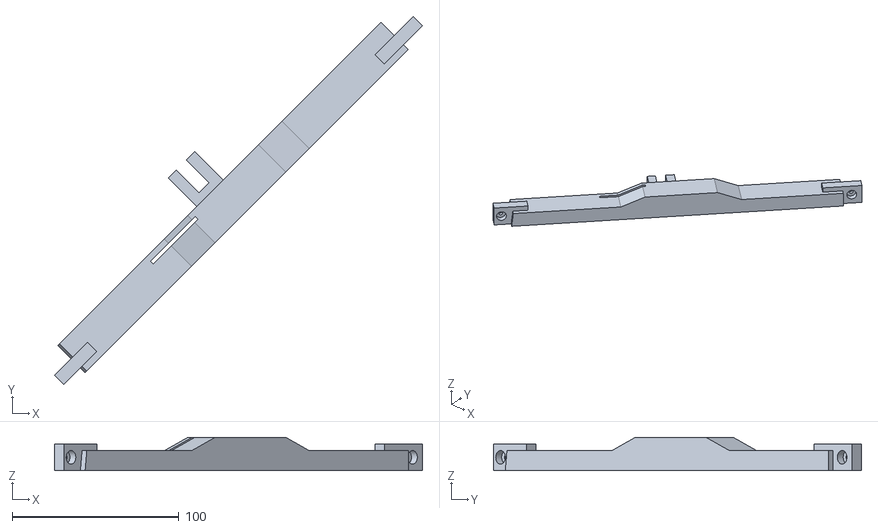
[picture p26: CAD file, 2026-11-01]
outputs/ATX-Desk-v24/PRINT_STL/18_ONE_PIECE_REAR_LOAD_BEAM_304_45mm.stl
220.9 x 220.9 x 20.0
