rapidrabbitsliu/pc-chassis-designs/outputs/Style2-v09/Manual_Refs/REF_PCIE_SOCKET_89x9x11_ESTIMATE.stl

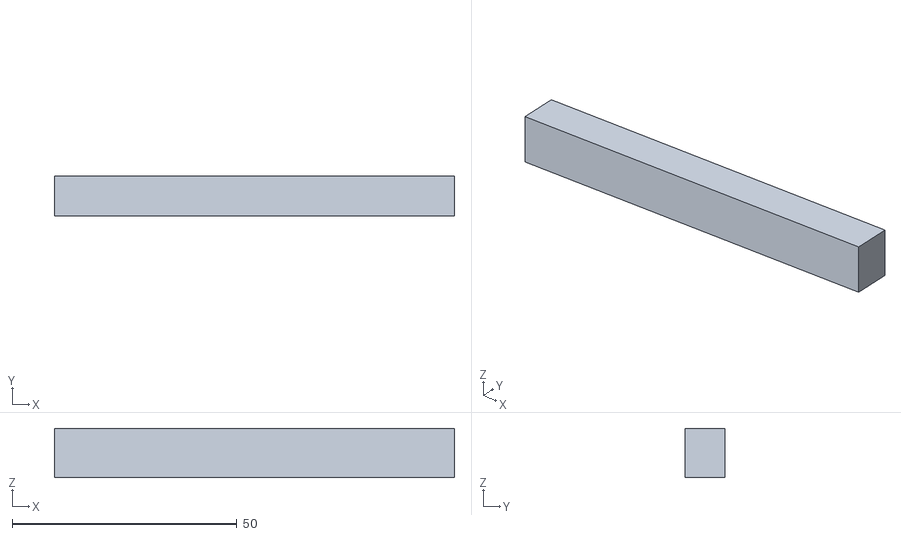
[picture p27: CAD file, 2026-10-24]
outputs/Style2-v09/Manual_Refs/REF_PCIE_SOCKET_89x9x11_ESTIMATE.stl
89.0 x 9.00 x 11.0
