rapidrabbitsliu/pc-chassis-designs/outputs/Style2-v09/PRINT_STL/05_SIDE_RECTANGULAR_FRAME_1.stl

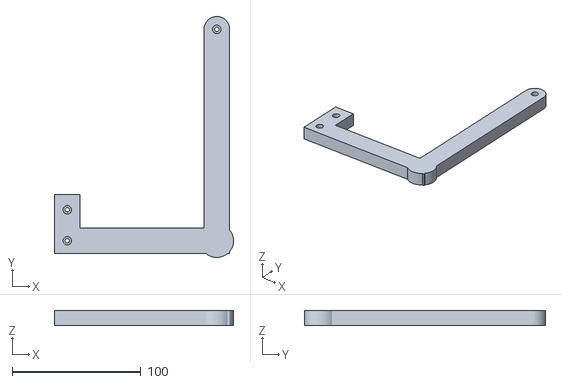
[picture p28: CAD file, 2026-10-24]
outputs/Style2-v09/PRINT_STL/05_SIDE_RECTANGULAR_FRAME_1.stl
139.0 x 187.0 x 12.0
