rapidrabbitsliu/pc-chassis-designs/outputs/Style2-v09/Raw_STL/09_PSU_SADDLE_FRONT.stl

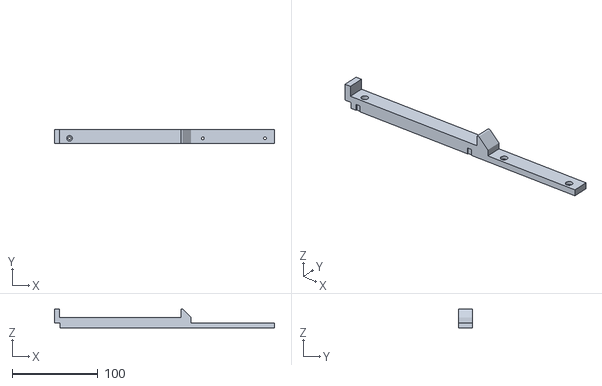
[picture p29: CAD file, 2026-10-24]
outputs/Style2-v09/Raw_STL/09_PSU_SADDLE_FRONT.stl
255.8 x 15.8 x 22.0
