rapidrabbitsliu/pc-chassis-designs/outputs/Style2-v09/Style2_V09_Dual140.step

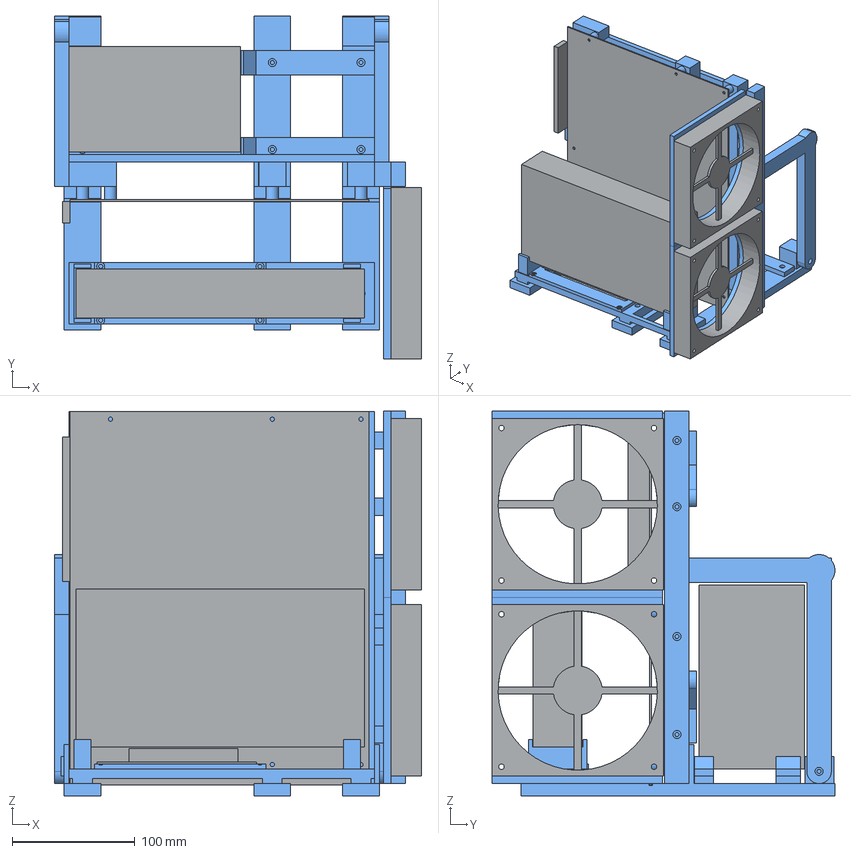
[picture p30: CAD file, 2026-10-24]
outputs/Style2-v09/Style2_V09_Dual140.step
299.8 x 280.0 x 314.0 mm
