rapidrabbitsliu/pc-chassis-designs/outputs/Hook-Fit-v03/PRINT_BOTH_4.0_4.2mm.stl

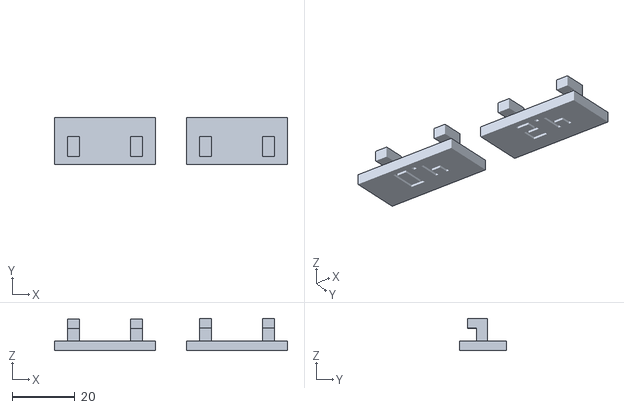
[picture p31: CAD file, 2026-10-24]
outputs/Hook-Fit-v03/PRINT_BOTH_4.0_4.2mm.stl
74.0 x 15.0 x 10.2
