rapidrabbitsliu/pc-chassis-designs/outputs/Style2-v09/Raw_STL/06_GPU_CARRIER.stl

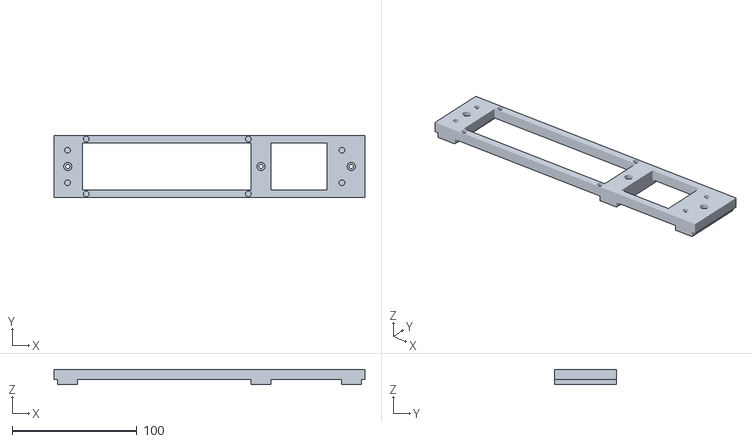
[picture p32: CAD file, 2026-10-24]
outputs/Style2-v09/Raw_STL/06_GPU_CARRIER.stl
249.3 x 50.0 x 12.0
