rapidrabbitsliu/pc-chassis-designs/outputs/Style2-v09/Manual_Refs/REF_GALAX_GPU_ENVELOPE_235.5x129x40.stl

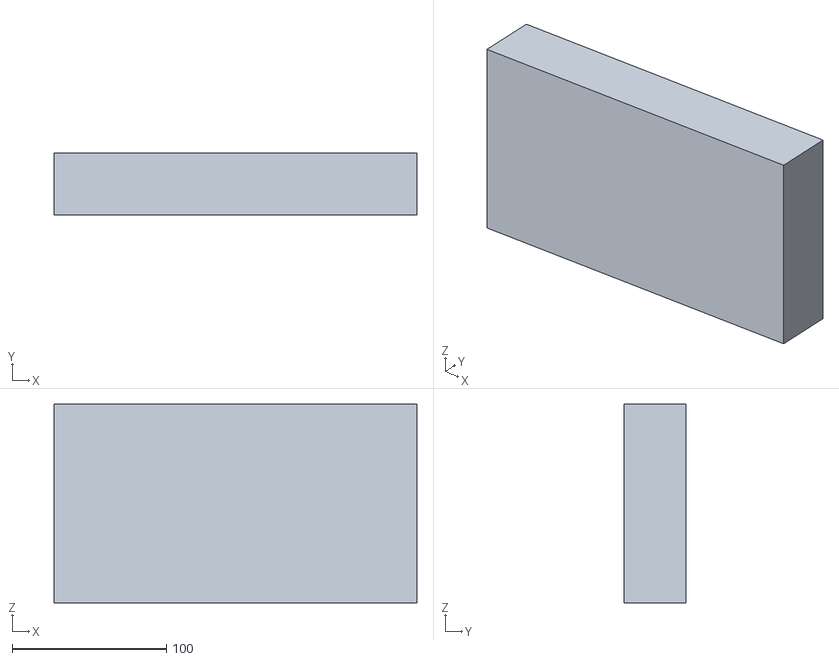
[picture p33: CAD file, 2026-10-24]
outputs/Style2-v09/Manual_Refs/REF_GALAX_GPU_ENVELOPE_235.5x129x40.stl
235.5 x 40.0 x 129.0
