rapidrabbitsliu/pc-chassis-designs/outputs/Style2-v09/PRINT_STL/11_FAN_PANEL_CPU_RAM_140mm.stl

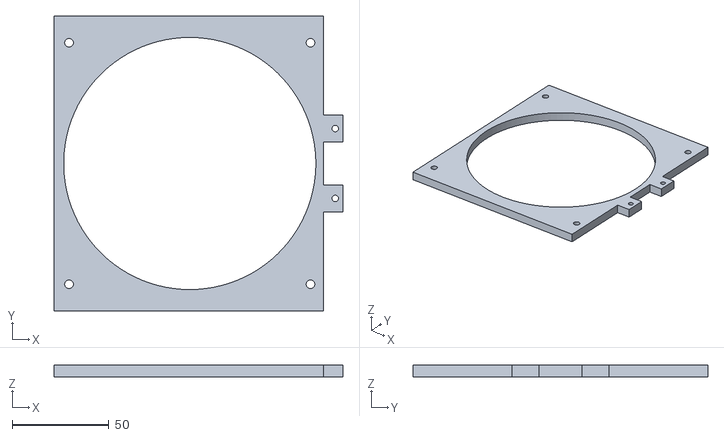
[picture p34: CAD file, 2026-10-24]
outputs/Style2-v09/PRINT_STL/11_FAN_PANEL_CPU_RAM_140mm.stl
149.0 x 152.0 x 6.00
