rapidrabbitsliu/pc-chassis-designs/outputs/Style2-v09/Raw_STL/01_UPRIGHT_3.stl

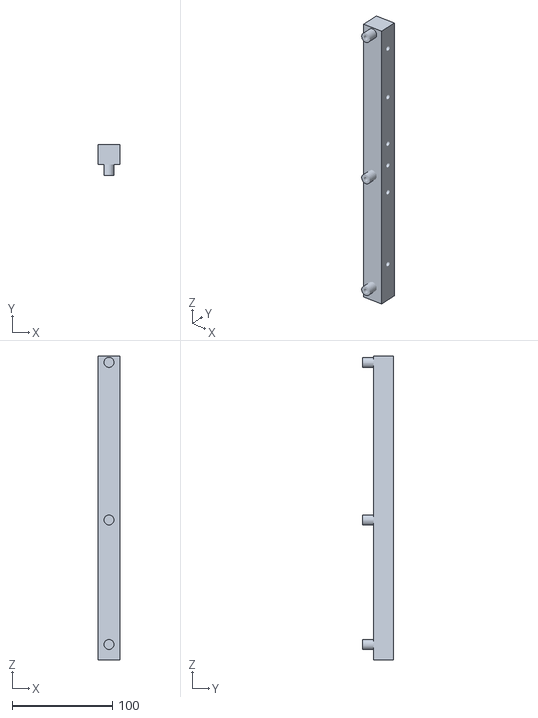
[picture p35: CAD file, 2026-10-24]
outputs/Style2-v09/Raw_STL/01_UPRIGHT_3.stl
22.0 x 30.8 x 303.8
