rapidrabbitsliu/pc-chassis-designs/outputs/ATX-Desk-v12-print-review/Raw_STL/18_REAR_BEAM_CPU_END_AND_REAR_LAP.stl

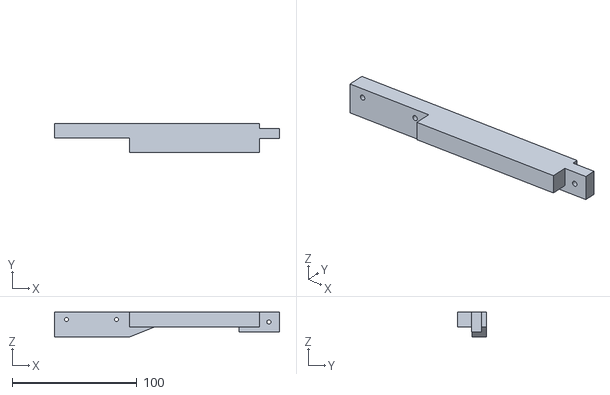
[picture p36: CAD file, 2026-10-24]
outputs/ATX-Desk-v12-print-review/Raw_STL/18_REAR_BEAM_CPU_END_AND_REAR_LAP.stl
180.1 x 23.2 x 20.0
