rapidrabbitsliu/pc-chassis-designs/outputs/ATX-Desk-v24/PRINT_STL/16_CPU_VERTICAL_SIDE_FLUSH_TO_BEAM.stl

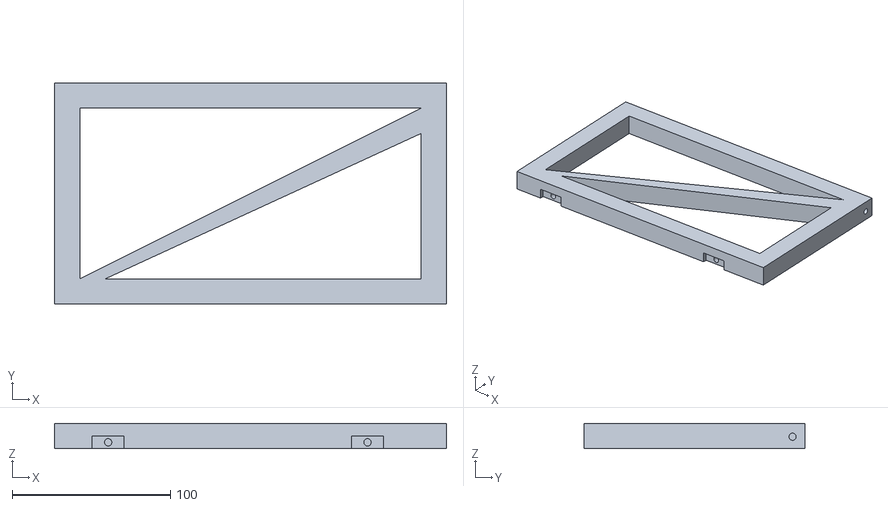
[picture p37: CAD file, 2026-11-01]
outputs/ATX-Desk-v24/PRINT_STL/16_CPU_VERTICAL_SIDE_FLUSH_TO_BEAM.stl
247.8 x 140.0 x 16.0
