rapidrabbitsliu/pc-chassis-designs/outputs/Style2-v09/Manual_Refs/REF_MSI_Z390_A_PRO_304.8x243.84.stl

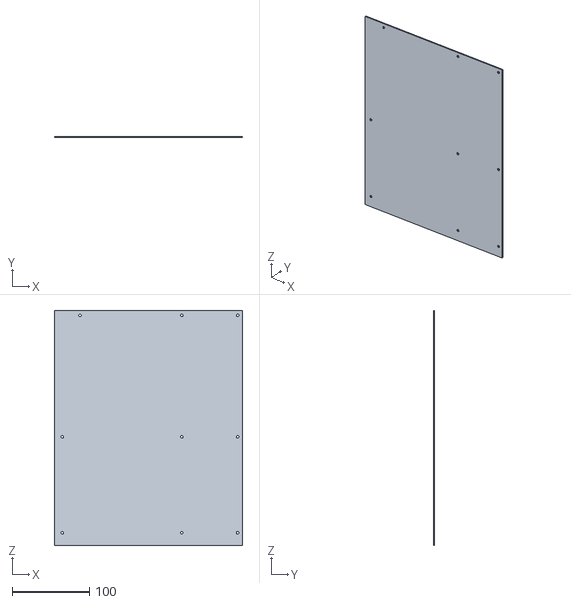
[picture p38: CAD file, 2026-10-24]
outputs/Style2-v09/Manual_Refs/REF_MSI_Z390_A_PRO_304.8x243.84.stl
243.8 x 1.60 x 304.8
