rapidrabbitsliu/pc-chassis-designs/outputs/Style2-v09/PRINT_STL/02_FOOT_2.stl

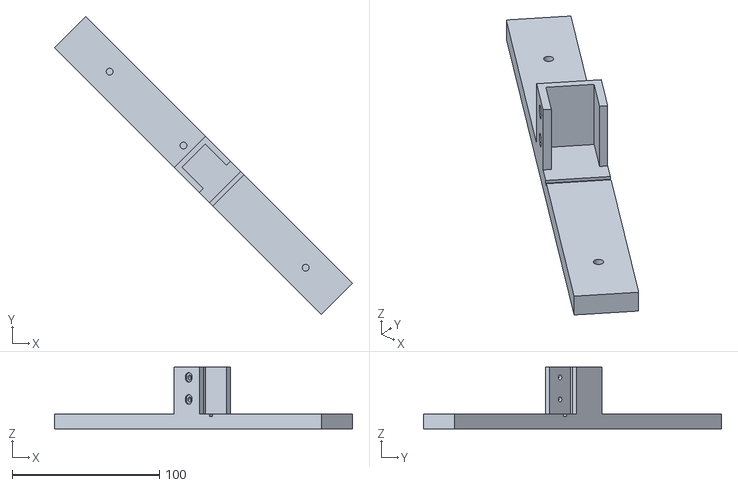
[picture p39: CAD file, 2026-10-24]
outputs/Style2-v09/PRINT_STL/02_FOOT_2.stl
202.5 x 202.5 x 42.0
