rapidrabbitsliu/pc-chassis-designs/outputs/ATX-Desk-v12-print-review/PRINT_STL/20_GPU_INDEPENDENT_FAN_SHOE_140mm.stl

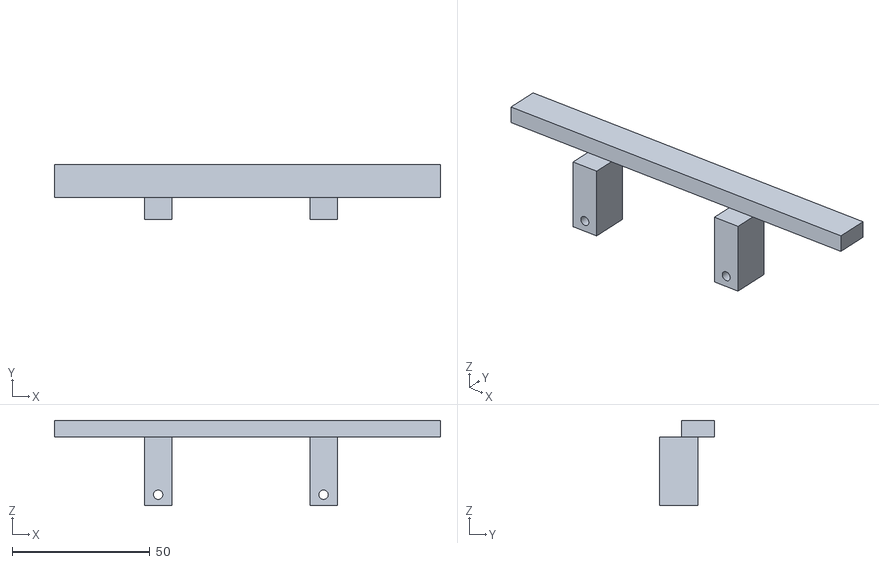
[picture p40: CAD file, 2026-10-24]
outputs/ATX-Desk-v12-print-review/PRINT_STL/20_GPU_INDEPENDENT_FAN_SHOE_140mm.stl
140.0 x 20.0 x 31.0
