rapidrabbitsliu/pc-chassis-designs/outputs/ATX-Desk-v24/PRINT_STL/04_front_GROUND_BAR_290mm_FLAT_PSU.stl

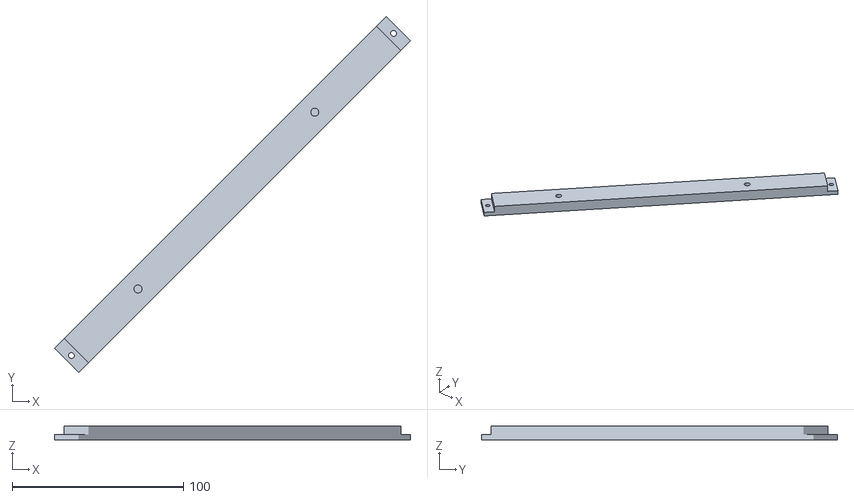
[picture p41: CAD file, 2026-11-01]
outputs/ATX-Desk-v24/PRINT_STL/04_front_GROUND_BAR_290mm_FLAT_PSU.stl
207.9 x 207.9 x 8.00
