rapidrabbitsliu/pc-chassis-designs/outputs/Style2-v09/Manual_Refs/REF_MOTHERBOARD_IO_MINUS_X.stl

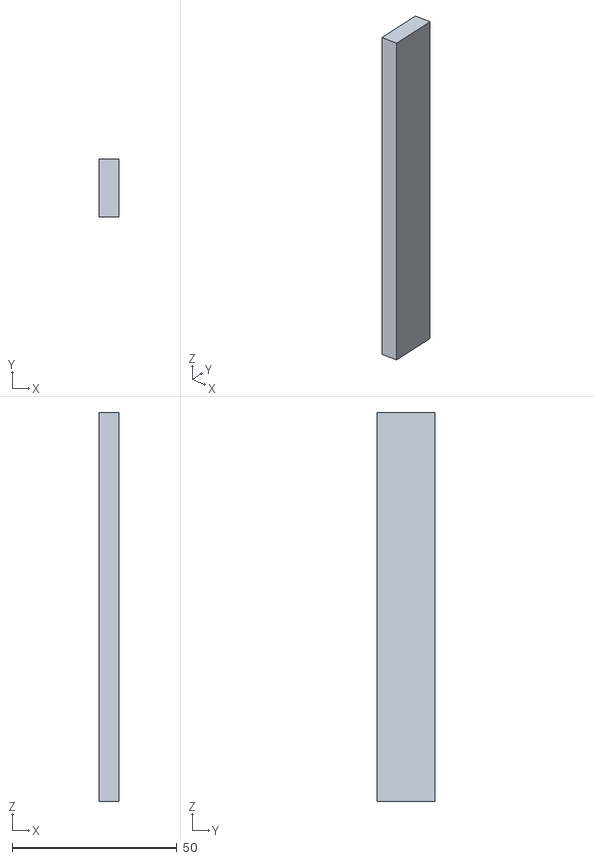
[picture p42: CAD file, 2026-10-24]
outputs/Style2-v09/Manual_Refs/REF_MOTHERBOARD_IO_MINUS_X.stl
6.00 x 17.6 x 118.0
