rapidrabbitsliu/pc-chassis-designs/outputs/Style2-v09/Raw_STL/10_FAN_MAST_RIGHT_SIDE.stl

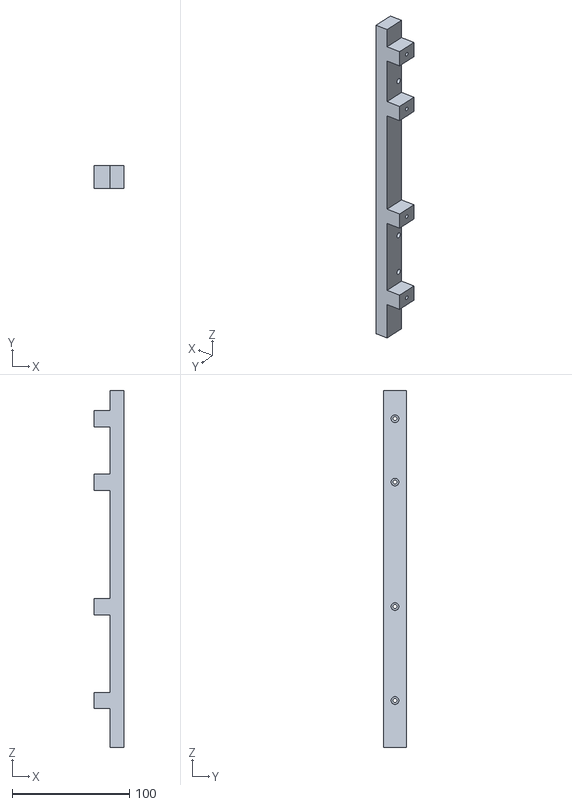
[picture p44: CAD file, 2026-10-24]
outputs/Style2-v09/Raw_STL/10_FAN_MAST_RIGHT_SIDE.stl
25.5 x 20.0 x 304.0
