rapidrabbitsliu/pc-chassis-designs/outputs/ATX-Desk-v24/PRINT_STL/20_ONE_PIECE_DUAL_140_FAN_RAIL_284mm.stl

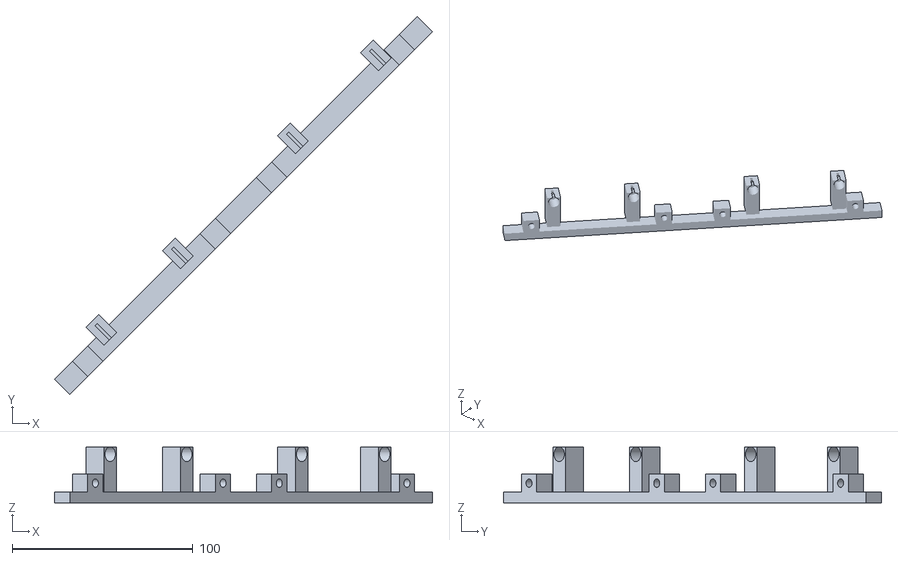
[picture p45: CAD file, 2026-11-01]
outputs/ATX-Desk-v24/PRINT_STL/20_ONE_PIECE_DUAL_140_FAN_RAIL_284mm.stl
209.3 x 209.3 x 31.0
