rapidrabbitsliu/pc-chassis-designs/outputs/Style2-v09/Manual_Refs/REF_RISER_PCB_PHOTO_ESTIMATE_130x18x1.6.stl

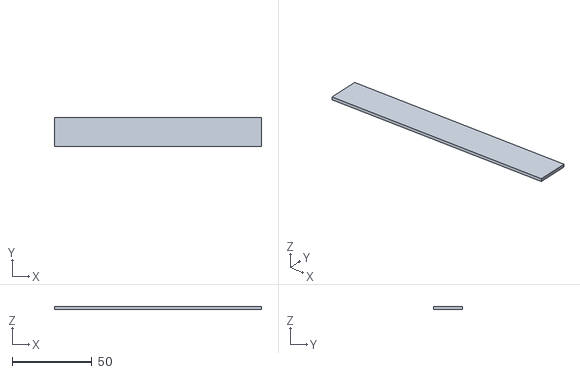
[picture p46: CAD file, 2026-10-24]
outputs/Style2-v09/Manual_Refs/REF_RISER_PCB_PHOTO_ESTIMATE_130x18x1.6.stl
130.0 x 18.0 x 1.60
