rapidrabbitsliu/pc-chassis-designs/outputs/Style2-v09/PRINT_STL/01_UPRIGHT_1.stl

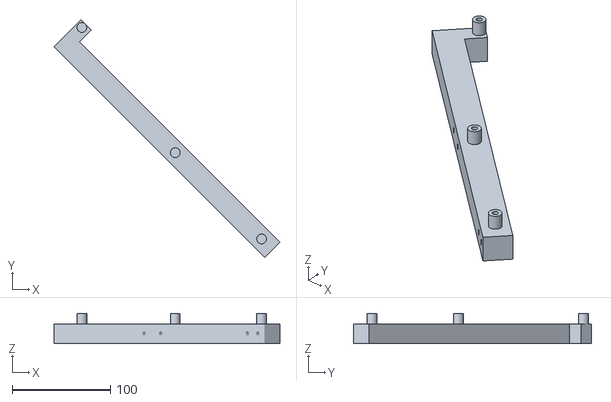
[picture p47: CAD file, 2026-10-24]
outputs/Style2-v09/PRINT_STL/01_UPRIGHT_1.stl
230.4 x 242.3 x 30.8
