rapidrabbitsliu/pc-chassis-designs/outputs/ATX-Desk-v24/PRINT_STL/05_CENTERED_FLAT_PSU_CRADLE_OPEN_INTAKE.stl

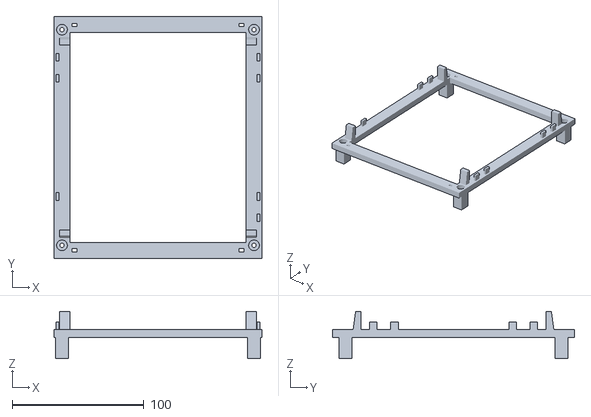
[picture p48: CAD file, 2026-11-01]
outputs/ATX-Desk-v24/PRINT_STL/05_CENTERED_FLAT_PSU_CRADLE_OPEN_INTAKE.stl
158.0 x 184.0 x 36.0
