rapidrabbitsliu/pc-chassis-designs/outputs/Style2-v09/Manual_Refs/REF_PSU_FAN_SIDE_DIRECTION_ONLY.stl

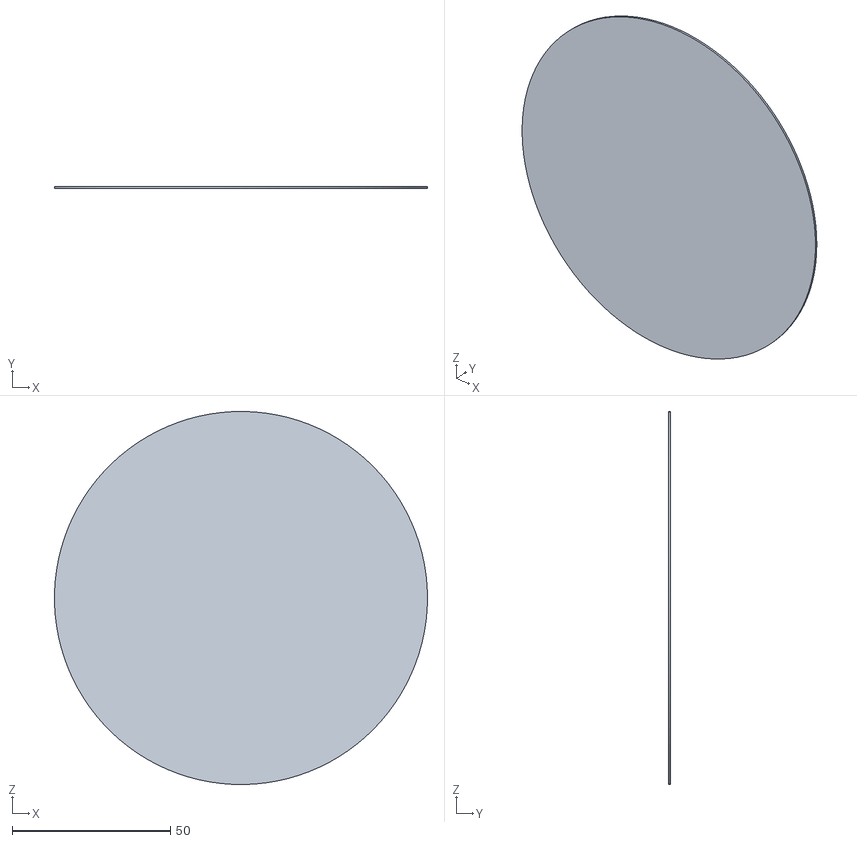
[picture p49: CAD file, 2026-10-24]
outputs/Style2-v09/Manual_Refs/REF_PSU_FAN_SIDE_DIRECTION_ONLY.stl
118.0 x 0.7 x 118.0
