rapidrabbitsliu/pc-chassis-designs/outputs/Style2-v09/PRINT_STL/08_GPU_PAD_RIGHT_FIT_REQUIRED.stl

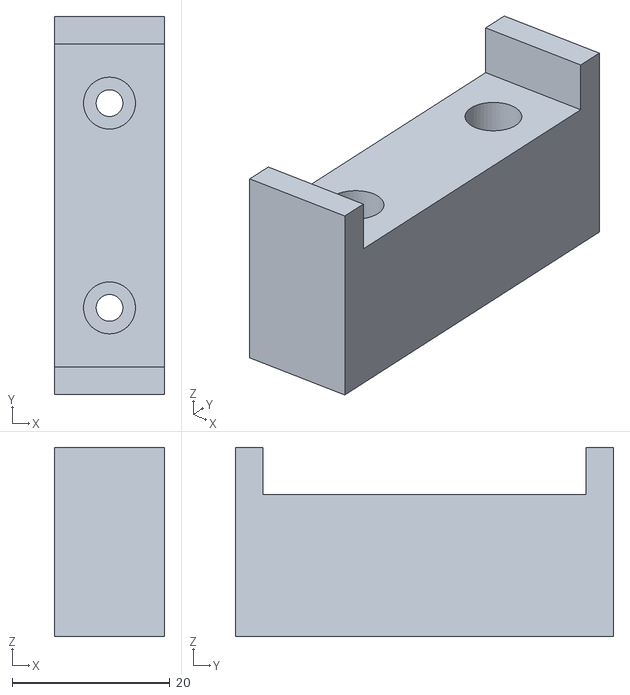
[picture p50: CAD file, 2026-10-24]
outputs/Style2-v09/PRINT_STL/08_GPU_PAD_RIGHT_FIT_REQUIRED.stl
14.0 x 48.0 x 24.0
