rapidrabbitsliu/pc-chassis-designs/outputs/Style2-v09/PRINT_STL/09_PSU_SADDLE_REAR.stl

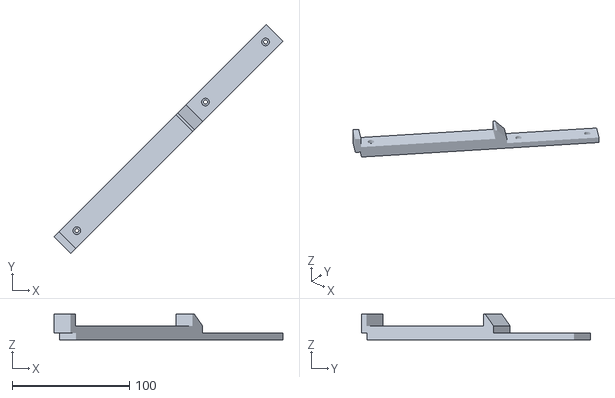
[picture p51: CAD file, 2026-10-24]
outputs/Style2-v09/PRINT_STL/09_PSU_SADDLE_REAR.stl
195.0 x 195.0 x 22.0
