rapidrabbitsliu/pc-chassis-designs/outputs/Style2-v09/Raw_STL/01_UPRIGHT_1.stl

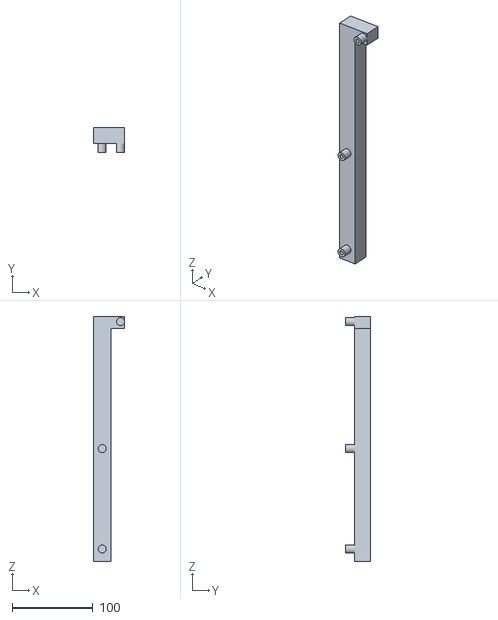
[picture p52: CAD file, 2026-10-24]
outputs/Style2-v09/Raw_STL/01_UPRIGHT_1.stl
38.9 x 30.8 x 303.8
