rapidrabbitsliu/pc-chassis-designs/outputs/ATX-Desk-v24/PRINT_STL/07_GPU_INTEGRATED_LIGHTWEIGHT_FRAME.stl

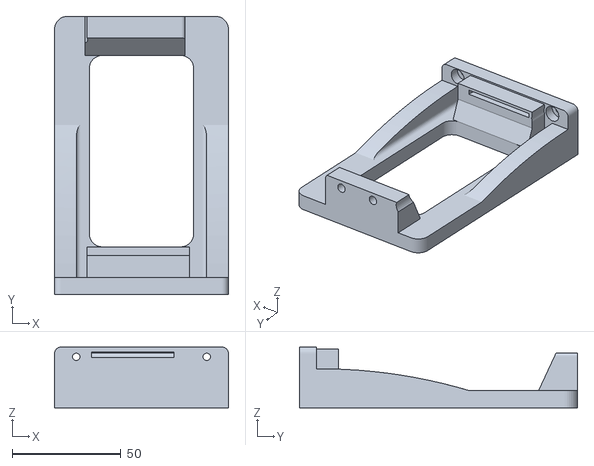
[picture p53: CAD file, 2026-11-01]
outputs/ATX-Desk-v24/PRINT_STL/07_GPU_INTEGRATED_LIGHTWEIGHT_FRAME.stl
80.0 x 128.0 x 28.0
