rapidrabbitsliu/pc-chassis-designs/outputs/Style2-v09/PRINT_STL/06_GPU_CARRIER.stl

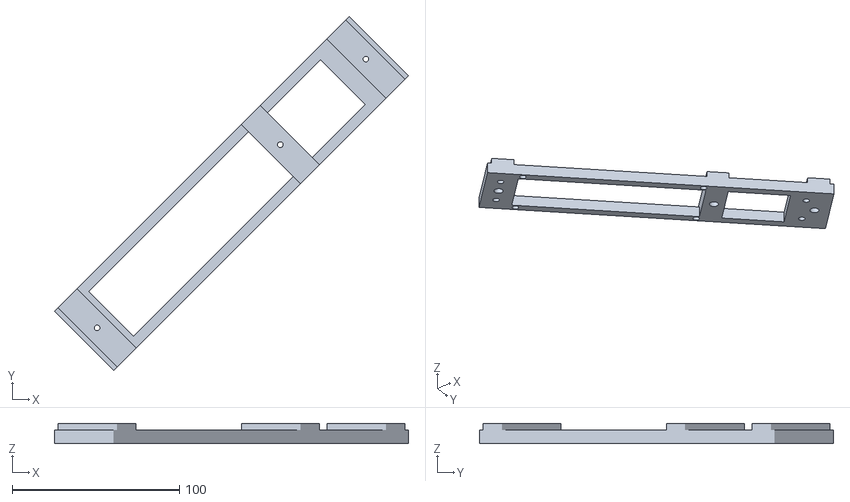
[picture p54: CAD file, 2026-10-24]
outputs/Style2-v09/PRINT_STL/06_GPU_CARRIER.stl
211.7 x 211.7 x 12.0
