rapidrabbitsliu/pc-chassis-designs/outputs/ATX-Desk-v24/PRINT_STL/12_front_CPU_SUPPORT_FRAME.stl

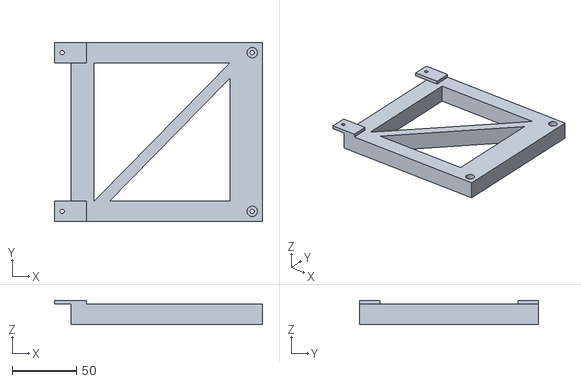
[picture p56: CAD file, 2026-11-01]
outputs/ATX-Desk-v24/PRINT_STL/12_front_CPU_SUPPORT_FRAME.stl
162.5 x 140.0 x 19.0
