rapidrabbitsliu/pc-chassis-designs/outputs/Style2-v09/Raw_STL/03_LOWER_CROSSBAR.stl

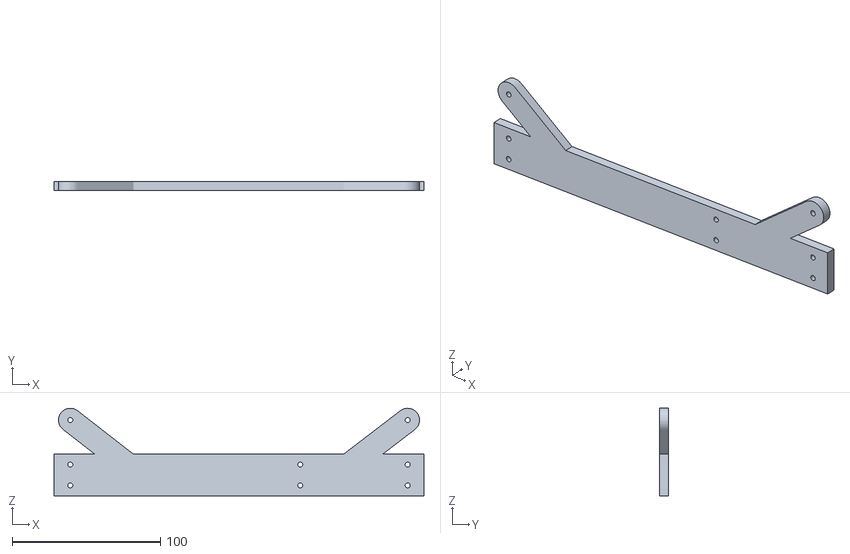
[picture p58: CAD file, 2026-10-24]
outputs/Style2-v09/Raw_STL/03_LOWER_CROSSBAR.stl
249.3 x 6.00 x 59.0
