rapidrabbitsliu/pc-chassis-designs/outputs/ATX-Desk-v24/PRINT_STL/19_PCI_LONGITUDINAL_BOARD_RAIL_243_84mm.stl

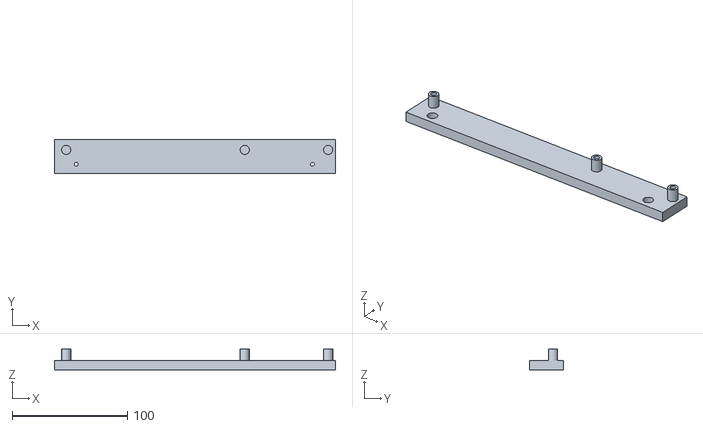
[picture p59: CAD file, 2026-11-01]
outputs/ATX-Desk-v24/PRINT_STL/19_PCI_LONGITUDINAL_BOARD_RAIL_243_84mm.stl
243.8 x 29.5 x 18.0
