rapidrabbitsliu/pc-chassis-designs/outputs/Style2-v09/PRINT_STL/01_UPRIGHT_2.stl

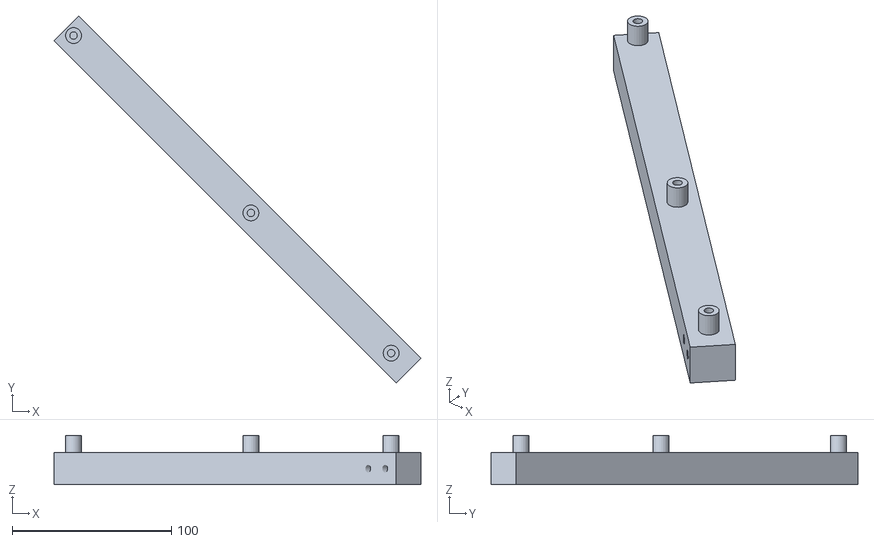
[picture p60: CAD file, 2026-10-24]
outputs/Style2-v09/PRINT_STL/01_UPRIGHT_2.stl
230.4 x 230.4 x 30.8
