rapidrabbitsliu/pc-chassis-designs/outputs/ATX-Desk-v24/PRINT_STL/19_MID_LONGITUDINAL_BOARD_RAIL_243_84mm.stl

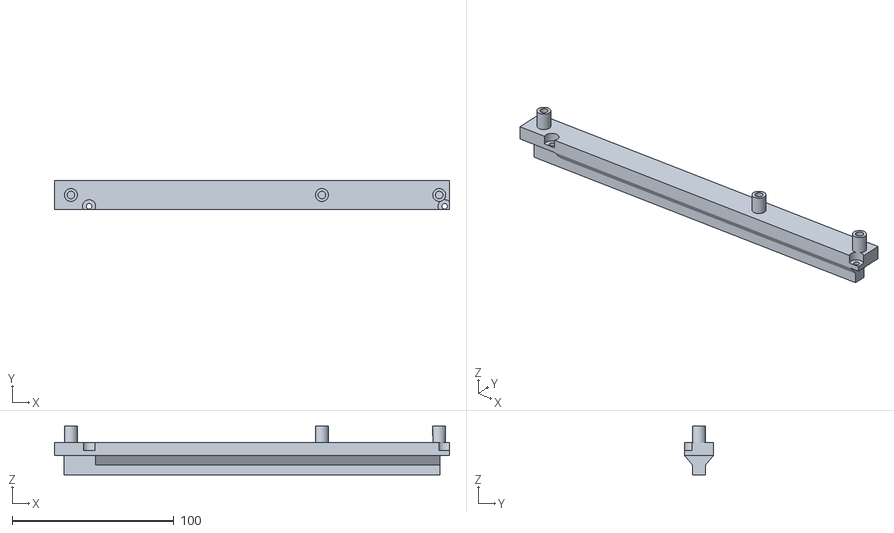
[picture p61: CAD file, 2026-11-01]
outputs/ATX-Desk-v24/PRINT_STL/19_MID_LONGITUDINAL_BOARD_RAIL_243_84mm.stl
243.8 x 18.0 x 30.0
