rapidrabbitsliu/pc-chassis-designs/outputs/Style2-v09/Raw_STL/02_FOOT_2.stl

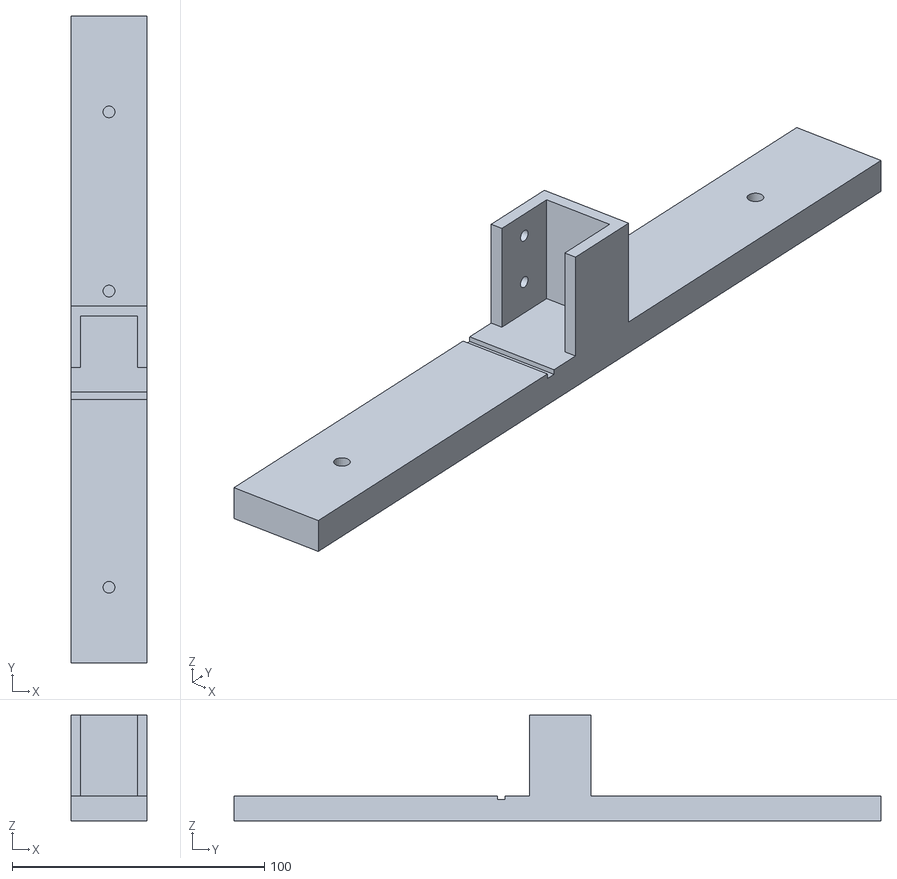
[picture p62: CAD file, 2026-10-24]
outputs/Style2-v09/Raw_STL/02_FOOT_2.stl
30.0 x 256.4 x 42.0
