rapidrabbitsliu/pc-chassis-designs/outputs/Style2-v09/PRINT_STL/09_PSU_SADDLE_FRONT.stl

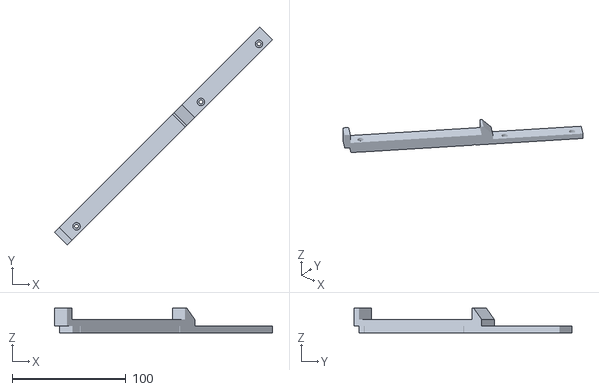
[picture p63: CAD file, 2026-10-24]
outputs/Style2-v09/PRINT_STL/09_PSU_SADDLE_FRONT.stl
192.1 x 192.1 x 22.0
