rapidrabbitsliu/pc-chassis-designs/outputs/Style2-v09/PRINT_STL/10_FAN_MAST_RIGHT_SIDE.stl

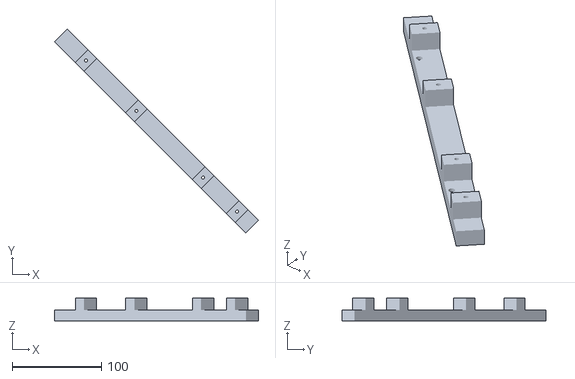
[picture p65: CAD file, 2026-10-24]
outputs/Style2-v09/PRINT_STL/10_FAN_MAST_RIGHT_SIDE.stl
229.1 x 229.1 x 25.5
