rapidrabbitsliu/pc-chassis-designs/outputs/Style2-v09/Raw_STL/03_UPPER_CROSSBAR.stl

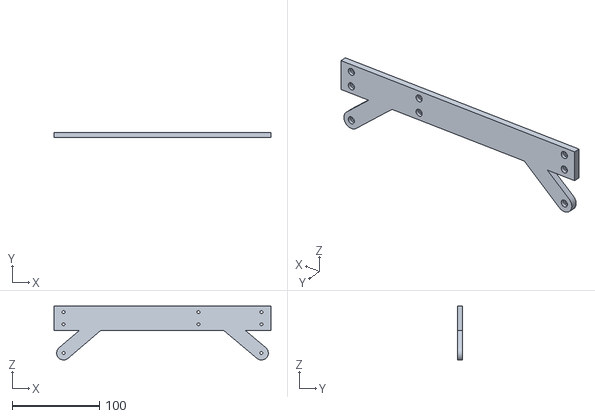
[picture p66: CAD file, 2026-10-24]
outputs/Style2-v09/Raw_STL/03_UPPER_CROSSBAR.stl
249.3 x 6.00 x 62.0
