rapidrabbitsliu/pc-chassis-designs/(list of files, cad)

Other CAD files:
outputs/ATX-Desk-v12-plate-template.3mf
outputs/Hook-Fit-v03/PRINT_depth_4.2mm.stl
outputs/Style2-v09/PRINT_STL/03_LOWER_CROSSBAR.stl
outputs/Style2-v09/Style2_V09_A1_PETG_Arranged.3mf
outputs/ATX-Desk-v12-All-Parts-10-Plates.3mf
outputs/Hook-Fit-v03/PRINT_depth_4.0mm.stl
outputs/Single-Bracket-v05/PRINT_AntiLiftKey_v05_mm.stl
outputs/ATX-Desk-v24/PRINT_STL/19_CPU_LONGITUDINAL_BOARD_RAIL_243_84mm.stl
outputs/Single-Bracket-v05/PRINT_Bracket_v05_mm.stl
outputs/Style2-v09/Manual_Refs/REF_FAN_CPU_RAM_140x140x25_FLOW_MINUS_X.stl
outputs/Style2-v09/PRINT_STL/05_SIDE_RECTANGULAR_FRAME_3.stl
outputs/ATX-Desk-v24/PRINT_STL/10_GPU_140_FAN_MOUNT.stl
outputs/Hook-Fit-v03/raw_depth_4.0.stl
outputs/Style2-v09/Raw_STL/11_FAN_PANEL_CPU_RAM_140mm.stl
outputs/ATX-Desk-v12-print-review/Raw_STL/18_REAR_BEAM_PCI_TAPERED_END_AND_FRONT_LAP.stl
outputs/Style2-v09/Raw_STL/05_SIDE_RECTANGULAR_FRAME_3.stl
outputs/Style2-v09/Raw_STL/11_FAN_PANEL_GPU_140mm.stl
outputs/ATX-Desk-v24/PRINT_STL/04_rear_GROUND_BAR_290mm_FLAT_PSU.stl
outputs/ATX-Desk-v12-print-review/Raw_STL/20_GPU_INDEPENDENT_FAN_SHOE_140mm.stl
outputs/Style2-v09/Raw_STL/08_GPU_PAD_LEFT_FIT_REQUIRED.stl
outputs/ATX-Desk-v12-print-review/PRINT_STL/18_REAR_BEAM_CPU_END_AND_REAR_LAP.stl
outputs/ATX-Desk-v24/PRINT_STL/16_PCI_INSET_SIDE_16_45mm.stl
outputs/Style2-v09/PRINT_STL/11_FAN_PANEL_GPU_140mm.stl
outputs/Style2-v09/Raw_STL/02_FOOT_1.stl
outputs/ATX-Desk-v12-print-review/PRINT_STL/20_CPU_INDEPENDENT_FAN_SHOE_140mm.stl
outputs/Style2-v09/PRINT_STL/08_GPU_PAD_LEFT_FIT_REQUIRED.stl
outputs/Style2-v09/Raw_STL/08_GPU_PAD_RIGHT_FIT_REQUIRED.stl
outputs/ATX-Desk-v12-print-review/Raw_STL/20_CPU_INDEPENDENT_FAN_SHOE_140mm.stl
outputs/Style2-v09/PRINT_STL/02_FOOT_3.stl
outputs/Style2-v09/Raw_STL/05_SIDE_RECTANGULAR_FRAME_1.stl
outputs/Style2-v09/PRINT_STL/07_RISER_TRAY_PENDING_MEASUREMENT.stl
outputs/ATX-Desk-v01/ATX_Desk_v01.f3d
outputs/ATX-Desk-v01/PRINT_01_Side_L_front.stl
outputs/ATX-Desk-v01/PRINT_01_Side_L_rear.stl
outputs/ATX-Desk-v01/PRINT_01_Side_R_front.stl
outputs/ATX-Desk-v01/PRINT_01_Side_R_rear.stl
outputs/ATX-Desk-v01/PRINT_02_Splice_L_high.stl
outputs/ATX-Desk-v01/PRINT_02_Splice_L_low.stl
outputs/ATX-Desk-v01/PRINT_02_Splice_R_high.stl
outputs/ATX-Desk-v01/PRINT_02_Splice_R_low.stl
outputs/ATX-Desk-v01/PRINT_03_BoardBeam_CPU.stl
outputs/ATX-Desk-v01/PRINT_03_BoardBeam_MID.stl
outputs/ATX-Desk-v01/PRINT_03_BoardBeam_PCI.stl
outputs/ATX-Desk-v01/PRINT_04_PSU_Shelf_front.stl
outputs/ATX-Desk-v01/PRINT_04_PSU_Shelf_rear.stl
outputs/ATX-Desk-v01/PRINT_05_PSU_Hoop_front.stl
outputs/ATX-Desk-v01/PRINT_05_PSU_Hoop_rear.stl
outputs/ATX-Desk-v01/PRINT_06_GPU_RearTower.stl
outputs/ATX-Desk-v01/PRINT_07_GPU_RearSlider.stl
outputs/ATX-Desk-v01/PRINT_08_GPU_SlidingNut.stl
outputs/ATX-Desk-v01/PRINT_09_GPU_TailTower.stl
outputs/ATX-Desk-v01/PRINT_10_GPU_TailSlider.stl
outputs/ATX-Desk-v01/PRINT_11_INSERT_FIT_FIRST.stl
outputs/ATX-Desk-v01/raw_01_Side_L_front.stl
outputs/ATX-Desk-v01/raw_01_Side_L_rear.stl
outputs/ATX-Desk-v01/raw_01_Side_R_front.stl
outputs/ATX-Desk-v01/raw_01_Side_R_rear.stl
outputs/ATX-Desk-v01/raw_02_Splice_L_high.stl
outputs/ATX-Desk-v01/raw_02_Splice_L_low.stl
outputs/ATX-Desk-v01/raw_02_Splice_R_high.stl
outputs/ATX-Desk-v01/raw_02_Splice_R_low.stl
outputs/ATX-Desk-v01/raw_03_BoardBeam_CPU.stl
outputs/ATX-Desk-v01/raw_03_BoardBeam_MID.stl
outputs/ATX-Desk-v01/raw_03_BoardBeam_PCI.stl
outputs/ATX-Desk-v01/raw_04_PSU_Shelf_front.stl
outputs/ATX-Desk-v01/raw_04_PSU_Shelf_rear.stl
outputs/ATX-Desk-v01/raw_05_PSU_Hoop_front.stl
outputs/ATX-Desk-v01/raw_05_PSU_Hoop_rear.stl
outputs/ATX-Desk-v01/raw_06_GPU_RearTower.stl
outputs/ATX-Desk-v01/raw_07_GPU_RearSlider.stl
outputs/ATX-Desk-v01/raw_08_GPU_SlidingNut.stl
outputs/ATX-Desk-v01/raw_09_GPU_TailTower.stl
outputs/ATX-Desk-v01/raw_10_GPU_TailSlider.stl
outputs/ATX-Desk-v01/raw_11_INSERT_FIT_FIRST.stl
outputs/ATX-Desk-v02-preview/ATX_Desk_v02_layout.f3d
outputs/ATX-Desk-v03-preview/ATX_Desk_v03_layout.f3d
outputs/ATX-Desk-v04-preview/ATX_Desk_v04_layout.f3d
outputs/ATX-Desk-v04-preview/Sources/Base_v03.f3d
outputs/ATX-Desk-v05-preview/ATX_Desk_v05_layout.f3d
outputs/ATX-Desk-v05-preview/Sources/Base_v04.f3d
outputs/ATX-Desk-v06-preview/ATX_Desk_v06_layout.f3d
outputs/ATX-Desk-v06-preview/Sources/Base_v05.f3d
outputs/ATX-Desk-v07-preview/ATX_Desk_v07_layout.f3d
outputs/ATX-Desk-v07-preview/Sources/Base_v06.f3d
outputs/ATX-Desk-v08-preview/ATX_Desk_v08_layout.f3d
outputs/ATX-Desk-v08-preview/Sources/Base_v07.f3d
outputs/ATX-Desk-v09-preview/ATX_Desk_v09_layout.f3d
outputs/ATX-Desk-v09-preview/Sources/Base_v07.f3d
outputs/ATX-Desk-v10-preview/ATX_Desk_v10_layout.f3d
outputs/ATX-Desk-v10-preview/Sources/Base_v09.f3d
outputs/ATX-Desk-v11-preview/ATX_Desk_v11_layout.f3d
outputs/ATX-Desk-v11-preview/Sources/Base_v10.f3d
outputs/ATX-Desk-v12-print-review/ATX_Desk_v12_print_review.f3d
outputs/ATX-Desk-v12-print-review/PRINT_STL/04_front_GROUND_BAR_290mm_FLAT_PSU.stl
outputs/ATX-Desk-v12-print-review/PRINT_STL/04_rear_GROUND_BAR_290mm_FLAT_PSU.stl
outputs/ATX-Desk-v12-print-review/PRINT_STL/05_CENTERED_FLAT_PSU_CRADLE_OPEN_INTAKE.stl
outputs/ATX-Desk-v12-print-review/PRINT_STL/07_GPU_REINFORCED_REAR_TOWER.stl
outputs/ATX-Desk-v12-print-review/PRINT_STL/08_GPU_LOWER_TWO_TAB_RECEIVER_ADJUSTABLE.stl
outputs/ATX-Desk-v12-print-review/PRINT_STL/08_GPU_UPPER_EAR_LEDGE_ADJUSTABLE.stl
outputs/ATX-Desk-v12-print-review/PRINT_STL/10_CPU_140_FAN_MOUNT.stl
outputs/ATX-Desk-v12-print-review/PRINT_STL/10_GPU_140_FAN_MOUNT.stl
outputs/ATX-Desk-v12-print-review/PRINT_STL/12_front_CPU_SUPPORT_FRAME.stl
outputs/ATX-Desk-v12-print-review/PRINT_STL/12_front_PCI_SUPPORT_FRAME.stl
outputs/ATX-Desk-v12-print-review/PRINT_STL/16_CPU_VERTICAL_SIDE_FLUSH_TO_BEAM.stl
outputs/ATX-Desk-v12-print-review/PRINT_STL/16_PCI_INSET_SIDE_16_45mm.stl
outputs/ATX-Desk-v12-print-review/PRINT_STL/19_CPU_LONGITUDINAL_BOARD_RAIL_243_84mm.stl
outputs/ATX-Desk-v12-print-review/PRINT_STL/19_MID_LONGITUDINAL_BOARD_RAIL_243_84mm.stl
outputs/ATX-Desk-v12-print-review/PRINT_STL/19_PCI_LONGITUDINAL_BOARD_RAIL_243_84mm.stl
outputs/ATX-Desk-v12-print-review/Raw_STL/04_front_GROUND_BAR_290mm_FLAT_PSU.stl
outputs/ATX-Desk-v12-print-review/Raw_STL/04_rear_GROUND_BAR_290mm_FLAT_PSU.stl
outputs/ATX-Desk-v12-print-review/Raw_STL/05_CENTERED_FLAT_PSU_CRADLE_OPEN_INTAKE.stl
outputs/ATX-Desk-v12-print-review/Raw_STL/07_GPU_REINFORCED_REAR_TOWER.stl
outputs/ATX-Desk-v12-print-review/Raw_STL/08_GPU_LOWER_TWO_TAB_RECEIVER_ADJUSTABLE.stl
outputs/ATX-Desk-v12-print-review/Raw_STL/08_GPU_UPPER_EAR_LEDGE_ADJUSTABLE.stl
outputs/ATX-Desk-v12-print-review/Raw_STL/10_CPU_140_FAN_MOUNT.stl
outputs/ATX-Desk-v12-print-review/Raw_STL/10_GPU_140_FAN_MOUNT.stl
outputs/ATX-Desk-v12-print-review/Raw_STL/12_front_CPU_SUPPORT_FRAME.stl
outputs/ATX-Desk-v12-print-review/Raw_STL/12_front_PCI_SUPPORT_FRAME.stl
outputs/ATX-Desk-v12-print-review/Raw_STL/16_CPU_VERTICAL_SIDE_FLUSH_TO_BEAM.stl
outputs/ATX-Desk-v12-print-review/Raw_STL/16_PCI_INSET_SIDE_16_45mm.stl
outputs/ATX-Desk-v12-print-review/Raw_STL/19_CPU_LONGITUDINAL_BOARD_RAIL_243_84mm.stl
outputs/ATX-Desk-v12-print-review/Raw_STL/19_MID_LONGITUDINAL_BOARD_RAIL_243_84mm.stl
outputs/ATX-Desk-v12-print-review/Raw_STL/19_PCI_LONGITUDINAL_BOARD_RAIL_243_84mm.stl
outputs/ATX-Desk-v12-print-review/Sources/Base_v11.f3d
outputs/ATX-Desk-v13/ATX-Desk-v13-Arranged.3mf
outputs/ATX-Desk-v13/ATX_Desk_v13_one_piece.f3d
outputs/ATX-Desk-v13/Manual_Meshes/04_front_GROUND_BAR_290mm_FLAT_PSU.stl
outputs/ATX-Desk-v13/Manual_Meshes/04_rear_GROUND_BAR_290mm_FLAT_PSU.stl
outputs/ATX-Desk-v13/Manual_Meshes/05_CENTERED_FLAT_PSU_CRADLE_OPEN_INTAKE.stl
outputs/ATX-Desk-v13/Manual_Meshes/07_GPU_REINFORCED_REAR_TOWER.stl
outputs/ATX-Desk-v13/Manual_Meshes/08_GPU_LOWER_TWO_TAB_RECEIVER_ADJUSTABLE.stl
outputs/ATX-Desk-v13/Manual_Meshes/08_GPU_UPPER_EAR_LEDGE_ADJUSTABLE.stl
outputs/ATX-Desk-v13/Manual_Meshes/10_CPU_140_FAN_MOUNT.stl
outputs/ATX-Desk-v13/Manual_Meshes/10_GPU_140_FAN_MOUNT.stl
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
