rapidrabbitsliu/pc-chassis-designs/outputs/ATX-Desk-v12-print-review/README.txt

V12 纵梁布局与打印尺寸校核版，未作为承载已验证的终版发布。

设计优先级：1 每件适配256×256打印床；2 承重与接头；3 打印便利；4 美观。

本版变化：
三根主板梁由左右横向改为前后纵向，均长243.84 mm，保留整件，不拼接。9个主板安装孔坐标不变。左右梁直接落在两侧框架上，中梁前端落在前框、后端落在后梁一体承托座，新增M3紧固孔。
中梁底筋连续到后端前6 mm，承托座开让位槽；左右梁可底面平放、孔柱向上。
原284 mm双风扇托架改为两只140 mm独立托架，直接落在前框并增加M3紧固孔。
258 mm底部横条整件保留，打印时绕Z轴45度放置，实际床面占用约196.58×196.58 mm。

打印文件：
PRINT_STL/中的19个STL已转为毫米、按推荐方向旋转并落到Z=0；每次单件居中导入，保留该方向，不再自动旋转或缩放。
print_parts.csv列出每件尺寸、brim及含brim占用。两侧框架247.84×140 mm，brim用3 mm；三根纵梁243.84 mm，brim可用5 mm。其余默认5 mm。全部文件加各自brim后的最大单边为253.84 mm，小于256 mm。切片软件如有额外禁区/裙边需另核对，brim宽度应按清单设置。
Raw_STL为原始导出，通常不直接用于摆盘；Sources为可复现源文件。

验证：
19件STL均为闭合一致法线网格，体积与CAD在0.3%内吻合。时间线健康，当前检查实体无体积干涉。新纵梁/承托座/风扇托架的8组接触对最小距离均0，详见contacts.json。

仍需完成：
床面尺寸通过不代表已经完成切片、支撑或承载验证。中梁端部6 mm悬空及后段5 mm侧挑檐、PCI斜侧框、GPU塔和托架需在切片预览中检查局部支撑。
未做PETG载荷/热变形测试；其余框架角部和底托防脱等接头尚待定稿，实卡挡板孔位仍需核对。当前STL用于摆盘/局部试装，勿视作整套最终打印发布。
新纵梁8 mm板厚的框架连接通常需比M3×6更长的螺丝；风扇托架连接厚14 mm也需较长螺丝。具体按螺母位置和垫片确定，螺母试孔4.7 mm需试块校准。
