rapidrabbitsliu/pc-chassis-designs/outputs/First-Print-V12/Readme.txt

首次试打：V12 CPU侧主板纵梁，数量1。
尺寸16×243.84×18 mm；文件已落到床面Z0，平底朝下，3根孔柱朝上。保持100%尺寸，单件居中，不要自动缩放。
按0.4 mm喷嘴的起始试打建议：PETG，层高0.20 mm，5圈墙，40% Gyroid，顶底各5层，不开支撑，外brim5 mm。温度/速度/风扇优先用该PETG耗材已验证预设，未知则按厂家标注。brim包含后26×253.84 mm，确认切片软件无额外禁区或过大的裙边。
先检查首层，打印完成冷却后再取件。先不装热熔螺母，轻放主板核对孔3/6/9，再试装一颗M3×4.5×5短热熔螺母。孔中心距离分别132.08、72.39 mm，总距204.47 mm。
这是首件试装版，未完成整体承载测试；不要直接批量打印其余全部零件。热熔螺母试孔4.7 mm还需按耗材/机器收缩校准，不能硬敲入。

PETG材料参考：https://help.prusa3d.com/article/petg_2059
