rapidrabbitsliu/pc-chassis-designs/outputs/ATX-Desk-v24/Style1_V24_Assembly_Manual.html

STYLE 1 / V24 / 2026.11.01

# 桌面双层开放式机架 安装说明书

15 个打印件 · 九盘 · 主板平放 · 下层电源朝下进风 · 前置双 140 风扇

最新V24：20处M3头井已扩至Ø8.2。下载V24完整打印包与离线说明书 (https://github.com/rapidrabbitsliu/pc-chassis-designs/raw/refs/heads/main/outputs/Style1-V24-3MF-and-Manual.zip)。打开3MF后请重新切片。

打印 / 保存为 PDF清空勾选

## 先确认版本和朝向

本书仅对应 风格 1 V24最新十五件版，不是风格 2 的竖主板机架。全部零件保持 100% 比例；不要混入旧版后横梁拼接件。

15

独立打印件

43

热熔螺母预留

290

模型落地宽 / mm

左右以站在两把前风扇外侧，面向主板为准：左为 PCIe 侧，右为 CPU 侧；后为主板 DP、显卡显示接口和电源排风一侧。后视图视觉左右会反转，零件身份不变。

X 向 CPU 右侧，Y 向背部接口，Z 向上。模型桌面为 Z=0，主板左前角投影为 X=0、Y=0；加脚垫后实际离桌面高度随之增加。

这是待完整实物验收的原型。显卡挡板上耳、下插脚，真实散热器、内存、线缆及长期承载仍需核对。浅灰硬件只是包络，不能证明已经完成固定。

V24对应最新网格装配图；显示颜色仅用于区分部件。

V24对应最新网格装配图；显示颜色仅用于区分部件。

## 01 · 先认零件

P01–P17 是沿用的固定编号，P13/P14已停用；实际15件，未刻入模型。出盘后可贴纸签，保留 STL 文件名和盘号；风格 2 的 P 编号不适用于本书。每件数量均为 1。

### P01 左侧内斜框

只有这一侧向内收；上边缘比底边更靠左。

只有这一侧向内收；上边缘比底边更靠左。

第 7 盘 · 数量 1 · 热熔螺母预留 7 个

装配轴向包络 32.45 × 247.84 × 140 mm；打印方向尺寸见盘号表。

热熔孔图：N01 N02 N03 N04

16_PCI_INSET_SIDE_16_45mm.stl

### P02 右侧垂直框

CPU 侧，外侧保持垂直；不可与左侧框互换。

CPU 侧，外侧保持垂直；不可与左侧框互换。

第 6 盘 · 数量 1 · 热熔螺母预留 7 个

装配轴向包络 16 × 247.84 × 140 mm；打印方向尺寸见盘号表。

热熔孔图：N05 N06 N07 N08

16_CPU_VERTICAL_SIDE_FLUSH_TO_BEAM.stl

### P03 前左框

中缝接收两个连接耳螺丝；上方还有中纵梁和风扇梁接收孔。

中缝接收两个连接耳螺丝；上方还有中纵梁和风扇梁接收孔。

第 4 盘 · 数量 1 · 热熔螺母预留 5 个

装配轴向包络 156.1 × 16 × 140 mm；打印方向尺寸见盘号表。

热熔孔图：N09 N10

12_front_PCI_SUPPORT_FRAME.stl

### P04 前右框

中缝上下各带一个一体连接耳；不是独立连接片。

中缝上下各带一个一体连接耳；不是独立连接片。

第 5 盘 · 数量 1 · 热熔螺母预留 2 个

装配轴向包络 162.45 × 19 × 140 mm；打印方向尺寸见盘号表。

热熔孔图：N11

12_front_CPU_SUPPORT_FRAME.stl

### P05 一体后横梁

304.45 mm 连续整根；中间前伸座承托中纵梁，后侧有显卡塔安装孔。

304.45 mm 连续整根；中间前伸座承托中纵梁，后侧有显卡塔安装孔。

第 8 盘 · 数量 1 · 热熔螺母预留 4 个

装配轴向包络 304.45 × 47.34 × 20 mm；打印方向尺寸见盘号表。

热熔孔图：N12

18_ONE_PIECE_REAR_LOAD_BEAM_304_45mm.stl

### P06 前底横条

实际长 274 mm，两端底搭接薄耳；装在靠风扇一端。

实际长 274 mm，两端底搭接薄耳；装在靠风扇一端。

第 9 盘 · 数量 1 · 热熔螺母预留 2 个

装配轴向包络 274 × 20 × 8 mm；打印方向尺寸见盘号表。

热熔孔图：N13

04_front_GROUND_BAR_290mm_FLAT_PSU.stl

### P07 后底横条

实际长 274 mm；与前条几何相同，可互换，本编号按安装位置区分。

实际长 274 mm；与前条几何相同，可互换，本编号按安装位置区分。

第 9 盘 · 数量 1 · 热熔螺母预留 2 个

装配轴向包络 274 × 20 × 8 mm；打印方向尺寸见盘号表。

热熔孔图：N14

04_rear_GROUND_BAR_290mm_FLAT_PSU.stl

### P08 电源开放托架

前后四个挡耳，短斜撑避开四孔；仍须扎带防止向上脱出。

前后四个挡耳，短斜撑避开四孔；仍须扎带防止向上脱出。

第 3 盘 · 数量 1 · 热熔螺母预留 0 个

装配轴向包络 158 × 184 × 36 mm；打印方向尺寸见盘号表。

热熔孔图：无热熔孔

05_CENTERED_FLAT_PSU_CRADLE_OPEN_INTAKE.stl

### P09 左主板纵梁

较宽，承接主板 1、4、7 号孔；安装柱朝上。

较宽，承接主板 1、4、7 号孔；安装柱朝上。

第 6 盘 · 数量 1 · 热熔螺母预留 3 个

装配轴向包络 29.51 × 243.84 × 18 mm；打印方向尺寸见盘号表。

热熔孔图：N15

19_PCI_LONGITUDINAL_BOARD_RAIL_243_84mm.stl

### P10 中主板纵梁

底部有连续加强筋；承接主板 2、5、8 号孔。

底部有连续加强筋；承接主板 2、5、8 号孔。

第 6 盘 · 数量 1 · 热熔螺母预留 3 个

装配轴向包络 18 × 243.84 × 30 mm；打印方向尺寸见盘号表。

热熔孔图：N16

19_MID_LONGITUDINAL_BOARD_RAIL_243_84mm.stl

### P11 右主板纵梁

较窄，承接主板 3、6、9 号孔；3 号孔前后位置错开。

较窄，承接主板 3、6、9 号孔；3 号孔前后位置错开。

第 6 盘 · 数量 1 · 热熔螺母预留 3 个

装配轴向包络 16 × 243.84 × 18 mm；打印方向尺寸见盘号表。

热熔孔图：N17

19_CPU_LONGITUDINAL_BOARD_RAIL_243_84mm.stl

### P12 一体轻量显卡支架

固定最低高度，上托台和下插脚座一体；底部仅用两颗螺丝。

固定最低高度，上托台和下插脚座一体；底部仅用两颗螺丝。

第 4 盘 · 数量 1 · 热熔螺母预留 2 个

装配轴向包络 80 × 28 × 128 mm；打印方向尺寸见盘号表。

热熔孔图：N18

07_GPU_INTEGRATED_LIGHTWEIGHT_FRAME.stl

### P15 双风扇一体底梁

长 284 mm，四条支臂连接前框；四个小托台接收面板安装耳。

长 284 mm，四条支臂连接前框；四个小托台接收面板安装耳。

第 8 盘 · 数量 1 · 热熔螺母预留 4 个

装配轴向包络 284 × 31 × 20 mm；打印方向尺寸见盘号表。

热熔孔图：N19

20_ONE_PIECE_DUAL_140_FAN_RAIL_284mm.stl

### P16 左风扇面板

125 mm孔距；背面Ø7深3沉孔，3 mm承压层及Ø5.5通孔；用短自攻螺丝，不用螺帽。

125 mm孔距；背面Ø7深3沉孔，3 mm承压层及Ø5.5通孔；用短自攻螺丝，不用螺帽。

第 1 盘 · 数量 1 · 热熔螺母预留 0 个

装配轴向包络 140 × 16 × 140 mm；打印方向尺寸见盘号表。

热熔孔图：无热熔孔

10_GPU_140_FAN_MOUNT.stl

### P17 右风扇面板

125 mm孔距；背面Ø7深3沉孔，3 mm承压层及Ø5.5通孔；用短自攻螺丝，不用螺帽。

125 mm孔距；背面Ø7深3沉孔，3 mm承压层及Ø5.5通孔；用短自攻螺丝，不用螺帽。

第 2 盘 · 数量 1 · 热熔螺母预留 0 个

装配轴向包络 140 × 16 × 140 mm；打印方向尺寸见盘号表。

热熔孔图：无热熔孔

10_CPU_140_FAN_MOUNT.stl

## 02 · 材料和工具

材料 | 需要量与建议备量 | 规格和用途
M3 热熔螺母 | 43 个有效位置，另1个停用孔 / 建议备50 | M3 内螺纹 × 高 4.5 × 滚花外径约 5。现有高 8 的螺母不能直接替换短孔。模型底孔有 Ø4.6 和 Ø4.7 两种，先试装。
M3×6 机螺丝 | 41颗固定用途 + 实卡上耳0～2颗 / 建议备50 | 32颗结构连接、9颗主板，显卡上耳另最多 2 颗。适配M3×6、头径约7 mm螺丝；20处原Ø6.6头井已改为CAD Ø8.2，另2处原Ø8.2保留。打印净孔目标至少7.5 mm，头部应能自然放入，不可强拧；头高按实际空间核对，不用沉头、自攻或大手拧头。
140×140×25 风扇 | 2 只 | 实测四孔125×125正方形排列，风扇原孔约Ø4；面板6厚，背面Ø7深3阶梯孔。确认风向、叶片及线缆避让。
风扇短自攻螺丝 | 8颗 / 建议备10颗 | 用户实测牙径5、盖径6、牙长6、总长9.2 mm；无需螺帽或热熔螺母。板孔应顺畅过牙，盖压住3 mm台阶，自攻入风扇名义约3 mm；承压边较窄，必须试装。
电源防脱细扎带 | 2 条，长度按实物 | 槽约 3.6×2.4，使用宽约 3 的细扎带，可按需要串接。沿电源壳体实边约束，勿挡进排风、开关、AC 插头和模组接口；不把电源外壳当框架承重件。
等高防滑脚垫 | 至少四个角部支撑点 | 底部四颗螺丝头未沉入模型。脚垫净高必须大于实测突出量，约 4 mm 可作选材起点；所有支点等高，不能由螺丝头接触桌面。安装脚垫会增加实机高度。
风扇接线材料 | 按硬件接口选择 | 必要的 PWM 延长线或集线器。按原厂规格核对两把风扇总电流和主板接口允许电流。
主板、电源、显卡 | 按硬件基准文档 | Z390-A PRO；ENERMAX ERV650G-AHG 140×150×86；影驰 5060 Ti 16GB。本风格不使用 PCIe 延长线。

### 热熔工具

- 可调温烙铁、匹配的 M3 热熔压头、烙铁架、耐热垫及镊子。
- PETG 同材料试孔块，直角定位工具或软夹具。
- 温度按螺母和材料厂家建议及试块表现调整，不能把喷嘴打印温度当热熔设定。

### 装配工具

- 匹配 M3 头型的短柄及正常长度螺丝刀；匹配风扇自攻螺丝的螺丝刀。
- 游标卡尺、直角尺、钢尺、修边刀、小锉及去支撑工具。
- 护目镜、清洁平整桌面及硬件要求的防静电条件。

## 03 · 先完成热熔螺母

在安装主板、电源、显卡之前完成全部热熔。只处理下列金色编号孔：Ø3.4 是通孔，Ø8.2 是螺丝头井，风扇Ø5.5通孔和Ø7沉孔是自攻螺丝穿板通道，均不装热熔螺母。

下图由对应V24最新网格绘制，金点对应孔口位置；孔序只属于本组。坐标为装配后的模型坐标，Z 从模型桌面起算，不是从每个零件底端量。压入方向单独写明；侧向和底向孔应把零件翻转后操作。

零件 | 螺母数 | 接收位置
P01 左侧内斜框 | 7 | N01 上表面主板纵梁孔；N02 前端面前框孔；N03 后端面横梁孔；N04 底搭接凹座内孔
P02 右侧垂直框 | 7 | N05 上表面主板纵梁孔；N06 前端面前框孔；N07 后端面横梁孔；N08 底搭接凹座内孔
P03 前左框 | 5 | N09 上表面三个孔；N10 中缝前面两个孔
P04 前右框 | 2 | N11 上表面两个风扇梁孔
P05 一体后横梁 | 4 | N12 上表面四个预留孔（X158塔孔停用）
P06 前底横条 | 2 | N13 上表面两个托架接收孔
P07 后底横条 | 2 | N14 上表面两个托架接收孔
P08 电源开放托架 | 0 | 不需要热熔螺母
P09 左主板纵梁 | 3 | N15 主板安装柱顶孔
P10 中主板纵梁 | 3 | N16 主板安装柱顶孔
P11 右主板纵梁 | 3 | N17 主板安装柱顶孔
P12 一体轻量显卡支架 | 2 | N18 一体上托台两个显卡上耳孔
P15 双风扇一体底梁 | 4 | N19 四个小托台顶孔
P16 左风扇面板 | 0 | 不需要热熔螺母
P17 右风扇面板 | 0 | 不需要热熔螺母

1. 去掉孔口毛刺，先在同批 PETG 试孔上确认螺母尺寸和压入效果。
2. 将本组孔口朝上，沿孔轴轻压，热熔到与孔口齐平；不要冷压、顶穿或压歪。
3. 保持不动至塑料定形，完全冷却后轻试 M3 螺丝。螺母松转、堵牙或塑料开裂须处理后再装。
4. 优先处理 P01/P02 底搭接凹座和前后端面、P12一体上托台两孔；装上硬件后这些孔口会被遮住。

### N01 · P01 上表面主板纵梁孔

从上向下 −Z

从上向下 −Z

2 个 · 底孔 Ø4.7 · 从上向下 −Z

X=4；Y=20 / 225；Z=140

### N02 · P01 前端面前框孔

从前向后 +Y

从前向后 +Y

2 个 · 底孔 Ø4.7 · 从前向后 +Y

前端面 Y=6；孔高 Z=8 / 132

### N03 · P01 后端面横梁孔

从后向前 −Y

从后向前 −Y

1 个 · 底孔 Ø4.6 · 从后向前 −Y

Y=253.84；孔高 Z=132

### N04 · P01 底搭接凹座内孔

从凹座底面向上 +Z

从凹座底面向上 +Z

2 个 · 底孔 Ø4.7 · 从凹座底面向上 +Z

Y=39.92 / 203.92；入口 Z=3.2

### N05 · P02 上表面主板纵梁孔

从上向下 −Z

从上向下 −Z

2 个 · 底孔 Ø4.7 · 从上向下 −Z

X=294；Y=20 / 225；Z=140

### N06 · P02 前端面前框孔

从前向后 +Y

从前向后 +Y

2 个 · 底孔 Ø4.7 · 从前向后 +Y

前端面 Y=6；孔高 Z=8 / 132

### N07 · P02 后端面横梁孔

从后向前 −Y

从后向前 −Y

1 个 · 底孔 Ø4.6 · 从后向前 −Y

Y=253.84；孔高 Z=132

### N08 · P02 底搭接凹座内孔

从凹座底面向上 +Z

从凹座底面向上 +Z

2 个 · 底孔 Ø4.7 · 从凹座底面向上 +Z

Y=39.92 / 203.92；入口 Z=3.2

### N09 · P03 上表面三个孔

从上向下 −Z

从上向下 −Z

3 个 · 底孔 Ø4.7 · 从上向下 −Z

风扇梁 X=50 / 110,Y=2；中纵梁 X=134,Y=3

### N10 · P03 中缝前面两个孔

从前向后 +Y

从前向后 +Y

2 个 · 底孔 Ø4.7 · 从前向后 +Y

X=146，Y=−10；Z=8 / 132

### N11 · P04 上表面两个风扇梁孔

从上向下 −Z

从上向下 −Z

2 个 · 底孔 Ø4.7 · 从上向下 −Z

X=200 / 265；Y=2；Z=140

### N12 · P05 上表面四个预留孔（X158塔孔停用）

从上向下 −Z

从上向下 −Z

4 个 · 底孔 Ø4.7 · 从上向下 −Z

中梁座 (134,222.5)；塔座 X=80 / 140 / 158,Y=248.5

### N13 · P06 上表面两个托架接收孔

从上向下 −Z

从上向下 −Z

2 个 · 底孔 Ø4.7 · 从上向下 −Z

X=79.4 / 225.4；Y=39.92；Z=8

### N14 · P07 上表面两个托架接收孔

从上向下 −Z

从上向下 −Z

2 个 · 底孔 Ø4.7 · 从上向下 −Z

X=79.4 / 225.4；Y=203.92；Z=8

### N15 · P09 主板安装柱顶孔

从安装柱顶向下 −Z

从安装柱顶向下 −Z

3 个 · 底孔 Ø4.7 · 从安装柱顶向下 −Z

对应主板孔 1 / 4 / 7；入口 Z=158

### N16 · P10 主板安装柱顶孔

从安装柱顶向下 −Z

从安装柱顶向下 −Z

3 个 · 底孔 Ø4.7 · 从安装柱顶向下 −Z

对应主板孔 2 / 5 / 8；入口 Z=158

### N17 · P11 主板安装柱顶孔

从安装柱顶向下 −Z

从安装柱顶向下 −Z

3 个 · 底孔 Ø4.7 · 从安装柱顶向下 −Z

对应主板孔 3 / 6 / 9；入口 Z=158

### N18 · P12 一体上托台两个显卡上耳孔

从上向下 −Z

从上向下 −Z

2 个 · 底孔 Ø4.7 · 从上向下 −Z

X100/120，Y251，Z268；Ø4.7深6.5 mm

### N19 · P15 四个小托台顶孔

从上向下 −Z

从上向下 −Z

4 个 · 底孔 Ø4.7 · 从上向下 −Z

X=32.4 / 132.4 / 176.4 / 276.4；Y=−14；Z=160

## 04 · 按顺序装配

螺丝数量只统计本步新使用的 M3×6；风扇另用8颗自攻螺丝。框架先轻紧、校正后再逐步锁紧，不对 PETG 或主板施加强拧力。

1

### 清点并完成热熔

本步新用 M3×6：0 颗

核对V24十五件及最新九盘工程，P13/P14编号停用。需要43个有效短热熔螺母；P05保留一个停用旧孔，可不安装。按孔位图操作并逐孔试牙。

图中共44个孔位预留，其中P05的X158旧塔孔停用。风扇阶梯孔、Ø3.4通孔及螺丝头井均不装热熔螺母。

P01 左侧内斜框P02 右侧垂直框P03 前左框P04 前右框P05 一体后横梁P06 前底横条P07 后底横条P08 电源开放托架P09 左主板纵梁P10 中主板纵梁P11 右主板纵梁P12 一体轻量显卡支架P15 双风扇一体底梁P16 左风扇面板P17 右风扇面板

清点总览

清点总览

第 1 步已完成并检查

2

### 连接左右框与两根底横条

本步新用 M3×6：4 颗

先把 P06、P07 两端薄搭接耳嵌入 P01、P02 底部对应凹座。螺丝从下面向上穿过薄耳，拧入侧框凹座内的螺母。两条分别在 Y=39.92 和 203.92。

先轻锁四颗。这里没有底部头井，螺丝头会低于模型 Z=0；四角加等高脚垫，净高须大于实测头部突出量，约 4 mm 可作选材起点。此时不得安装电子硬件。

P01 左侧内斜框P02 右侧垂直框P06 前底横条P07 后底横条

本步完成状态。螺丝、脚垫、绑带、散热器和线缆未画出，仍须按文字完成。

本步完成状态。螺丝、脚垫、绑带、散热器和线缆未画出，仍须按文字完成。

第 2 步已完成并检查

3

### 装上前侧两片框架

本步新用 M3×6：6 颗

从风扇一侧看，P03 在左、P04 在右，P04 的两个一体连接耳跨住 P03 中缝。左右各两颗螺丝从前面穿入侧框；中缝另用两颗穿过连接耳拧入 P03。

角部 4 颗，中缝 2 颗。右侧保持垂直，只有左侧向内收。不要用锁紧力弥补接合面错位。

P03 前左框P04 前右框

本步完成状态。螺丝、脚垫、绑带、散热器和线缆未画出，仍须按文字完成。

本步完成状态。螺丝、脚垫、绑带、散热器和线缆未画出，仍须按文字完成。

第 3 步已完成并检查

4

### 安装连续后横梁

本步新用 M3×6：2 颗

将 P05 横跨左右侧框上沿，前伸的中纵梁座朝主板内部。两端安装耳贴到侧框后端，螺丝从背后向前锁入侧框。

本件整根无中缝，不再添加旧版拼接片。左右端承托面应贴合，校正框架后交替轻锁；电源后排风区域保持开放。

P05 一体后横梁

本步完成状态。螺丝、脚垫、绑带、散热器和线缆未画出，仍须按文字完成。

本步完成状态。螺丝、脚垫、绑带、散热器和线缆未画出，仍须按文字完成。

第 4 步已完成并检查

5

### 安装电源前后限位托架

本步新用 M3×6：4 颗

P08四脚对准P06/P07接收孔，螺丝从四个头井向下锁紧。检查四孔口及工具通道畅通；前后挡耳向上。

先穿两条约3 mm宽细扎带，暂不收紧。挡耳限制前后位移，不能代替向上防脱扎带。

P08 电源开放托架

本步完成状态。螺丝、脚垫、绑带、散热器和线缆未画出，仍须按文字完成。

本步完成状态。螺丝、脚垫、绑带、散热器和线缆未画出，仍须按文字完成。

第 5 步已完成并检查

6

### 放入并约束电源

本步新用 M3×6：0 颗

此时上方仍敞开，从上方将电源轻放到 P08，不必穿过后横梁下面的窄余隙。大风扇朝下，排风面和 AC 插口朝后，与主板 DP、显卡接口同侧。让壳体边缘落在托架上，收紧两条预穿绑带作防脱。

电源150×140×86，前后名义间隙各0.4 mm，需实测。壳体落在托架边缘，收紧扎带防脱，避开风扇、排风、AC插口及开关。

P08 电源开放托架

本步完成状态。螺丝、脚垫、绑带、散热器和线缆未画出，仍须按文字完成。

本步完成状态。螺丝、脚垫、绑带、散热器和线缆未画出，仍须按文字完成。

第 6 步已完成并检查

7

### 安装三根主板纵梁

本步新用 M3×6：6 颗

P09 放左侧框，P11 放 CPU 右侧框，各用两颗从上向下锁紧。P10 的底筋朝下，前端落在 P03，后端落在 P05 的前伸座，两端各一颗。

三根均长 243.84，不沿 304.8 方向横放。九个安装柱顶面应在同一高度；右后 3 号孔本来就与左后两孔错开。

P09 左主板纵梁P10 中主板纵梁P11 右主板纵梁

本步完成状态。螺丝、脚垫、绑带、散热器和线缆未画出，仍须按文字完成。

本步完成状态。螺丝、脚垫、绑带、散热器和线缆未画出，仍须按文字完成。

第 7 步已完成并检查

8

### 安装一体轻量显卡支架

本步新用 M3×6：2 颗

P12底部两孔对准P05的X80/X140、Y248.5接收孔，用两颗M3×6从上向下锁紧。P05的X158旧孔不使用。

上下托台已一体固定，无调节滑块。上托台Z268，下插脚口Z158；38×2.4连续通槽需与后横梁出口相通。

P12 一体轻量显卡支架

本步完成状态。螺丝、脚垫、绑带、散热器和线缆未画出，仍须按文字完成。

本步完成状态。螺丝、脚垫、绑带、散热器和线缆未画出，仍须按文字完成。

一体显卡支架；热熔孔仅位于上托台。

一体显卡支架；热熔孔仅位于上托台。

第 8 步已完成并检查

9

### 安装主板及板上硬件

本步新用 M3×6：9 颗

先按原厂方法处理 CPU、内存和散热器背板，再将主板水平放到九个安装柱上。CPU 在右侧，背部接口朝后；用九颗 M3×6 从上面轻锁，不能弯板强行对孔。

主板底面Z158，九孔自然对位；散热器、内存和背面元件仍需实物检查。P12已固定，不存在可调滑片。

P09 左主板纵梁P10 中主板纵梁P11 右主板纵梁

本步完成状态。螺丝、脚垫、绑带、散热器和线缆未画出，仍须按文字完成。

本步完成状态。螺丝、脚垫、绑带、散热器和线缆未画出，仍须按文字完成。

第 9 步已完成并检查

10

### 直插显卡并固定上耳

本步新用 M3×6：0～2 颗

显卡插入第一条长PCIe并确认卡扣到位；下金属插脚进入P12的38×2.4通槽，上耳落在固定上托台，用0～2颗匹配M3螺丝锁紧。

上耳孔X100/120、Y251、Z268，热熔Ø4.7深6.5。最低高度按先前实测确定，但挡板、插头和散热器仍需试装。不得强掰或靠PCIe插槽承担搬运拉力。

P12 一体轻量显卡支架

本步完成状态。螺丝、脚垫、绑带、散热器和线缆未画出，仍须按文字完成。

本步完成状态。螺丝、脚垫、绑带、散热器和线缆未画出，仍须按文字完成。

第 10 步已完成并检查

11

### 预装双风扇组件

本步新用 M3×6：4 颗

P16/P17各两个底耳放在P15小托台上，用四颗M3×6向下固定。风扇贴住面板平整前面，从背面八个沉孔分别穿入用户现有短自攻螺丝并锁入风扇塑料框。

风扇螺丝另计8颗：牙径5、盖径6、牙长6、总长9.2 mm，不用螺帽。Ø7沉孔深3、承压层3、通孔CAD Ø5.5；名义进入风扇约3 mm，盖底斜面与窄承压边须试装，勿过紧。气流均朝后+Y。

P15 双风扇一体底梁P16 左风扇面板P17 右风扇面板

本步完成的桌面子组件；下一步才安装到整机。

本步完成的桌面子组件；下一步才安装到整机。

第 11 步已完成并检查

12

### 把双风扇组件固定到前框

本步新用 M3×6：4 颗

把预装组件的四条支臂落在 P03、P04 上方：左侧 X=50/110，右侧 X=200/265。四颗螺丝从支臂上方头井向下锁入前框，P16 在左、P17 在右。

本步图片为装到整机后的状态。风扇不能碰内存、显卡及线束；如果真实散热器挡住工具或风扇位置，应先拆下风扇组件再完成适配。

P03 前左框P04 前右框P15 双风扇一体底梁P16 左风扇面板P17 右风扇面板

本步完成状态。螺丝、脚垫、绑带、散热器和线缆未画出，仍须按文字完成。

本步完成状态。螺丝、脚垫、绑带、散热器和线缆未画出，仍须按文字完成。

第 12 步已完成并检查

13

### 理线和整机检查

本步新用 M3×6：0 颗

布线避开风扇、热表面和 PCB 锐边；确认电源防脱、显卡挡板固定、主板九孔、四角脚垫均完成。检查真实插头与线缆转弯空间，手转风扇确认无擦碰，再按硬件说明试运行。

框架应在桌面稳定落地，不能由四颗底部螺丝头顶住。首次运行观察温度、异响和塑料变形；几何检查不能代替 PETG 长期承载和温升验证。

本步完成状态。螺丝、脚垫、绑带、散热器和线缆未画出，仍须按文字完成。

本步完成状态。螺丝、脚垫、绑带、散热器和线缆未画出，仍须按文字完成。

第 13 步已完成并检查

## 05 · 完成检查

15件与V24最新九盘对应，停用P13/P14和旧件未混入全部短热熔螺母冷却、试牙通过，未将 H8 压入短孔P01 内斜、P02 垂直，框架接合面贴合且无层间开裂底部四颗螺丝头不接触桌面，等高脚垫使机架稳定无晃动电源落在托架边缘并可靠防脱，底部进风、背部排风和 AC 接口通畅三根主板梁柱顶同高，主板九孔自然对位且未接触不应接触的焊点显卡第一长槽直插到位，两个下插脚不顶底，上耳可靠锁紧显卡挡板和实物散热器、内存及线缆空间已适配；不强压不合孔的部件风扇真实气流箭头朝后，全部叶片转动无擦碰，线束固定在叶片之外风扇及显卡供电按原厂要求连接，插头和接口没有受拉或受挤首次试运行已观察振动、异响、温度和塑料变形，长期承载仍持续观察

勾选尝试保存在当前浏览器；换设备不保证同步。单文件内嵌全部图片，正文、图片与打印样式均可离线使用。

## 06 · 连接账和盘号

共44个螺母孔位预留，其中P05的X158旧孔停用；有效43个位置。41颗固定用途M3螺丝，加显卡上耳0～2颗，风扇另计8颗短自攻螺丝。

连接 | 通孔件 | 螺母接收件 | M3×6 数量 | 锁入方向
底横条 → 左右侧框 | P06 前底横条P07 后底横条 | P01 左侧内斜框P02 右侧垂直框 | 4 | 从底面向上；拆装电子硬件前完成
前框角部 → 侧框 | P03 前左框P04 前右框 | P01 左侧内斜框P02 右侧垂直框 | 4 | 从前向后，左右上、下各一
前框中缝连接耳 | P04 前右框 | P03 前左框 | 2 | 从前向后，上下各一
后横梁两端 → 侧框 | P05 一体后横梁 | P01 左侧内斜框P02 右侧垂直框 | 2 | 从后向前，两端各一
电源托架 → 底横条 | P08 电源开放托架 | P06 前底横条P07 后底横条 | 4 | 从上向下，四脚各一
左右主板梁 → 侧框 | P09 左主板纵梁P11 右主板纵梁 | P01 左侧内斜框P02 右侧垂直框 | 4 | 从上向下，每梁前后各一
中主板梁 → 前框和后梁座 | P10 中主板纵梁 | P03 前左框P05 一体后横梁 | 2 | 从上向下，前后各一
显卡塔 → 后梁 | P12 一体轻量显卡支架 | P05 一体后横梁 | 2 | 从上向下，仅X80/X140两孔；X158停用
风扇底梁 → 前框 | P15 双风扇一体底梁 | P03 前左框P04 前右框 | 4 | 从上向下，四支臂
风扇面板 → 风扇底梁 | P16 左风扇面板P17 右风扇面板 | P15 双风扇一体底梁 | 4 | 从上向下，每面板二
主板 → 三根主板梁 | 主板 | P09 左主板纵梁P10 中主板纵梁P11 右主板纵梁 | 9 | 从上向下，每梁三个
实卡金属上耳 → 上托片 | 显卡 | P12 一体轻量显卡支架 | 2 | 0～2颗，锁入一体上托台

盘号 | 说明书编号 | STL 文件名 | 打印方向包络 mm | 支撑
7 | P01 左侧内斜框 | 16_PCI_INSET_SIDE_16_45mm.stl | 247.84 x 142.83 x 15.891 | 无
6 | P02 右侧垂直框 | 16_CPU_VERTICAL_SIDE_FLUSH_TO_BEAM.stl | 247.84 x 140.0 x 16.0 | 无
4 | P03 前左框 | 12_front_PCI_SUPPORT_FRAME.stl | 140.0 x 156.1 x 16.0 | 无
5 | P04 前右框 | 12_front_CPU_SUPPORT_FRAME.stl | 162.45 x 140.0 x 19.0 | 自动普通支撑_仅热床
8 | P05 一体后横梁 | 18_ONE_PIECE_REAR_LOAD_BEAM_304_45mm.stl | 220.936 x 220.936 x 20.0 | 无
9 | P06 前底横条 | 04_front_GROUND_BAR_290mm_FLAT_PSU.stl | 207.889 x 207.889 x 8.0 | 无
9 | P07 后底横条 | 04_rear_GROUND_BAR_290mm_FLAT_PSU.stl | 207.889 x 207.889 x 8.0 | 无
3 | P08 电源开放托架 | 05_CENTERED_FLAT_PSU_CRADLE_OPEN_INTAKE.stl | 158.0 x 184.0 x 36.0 | 自动普通支撑_仅热床
6 | P09 左主板纵梁 | 19_PCI_LONGITUDINAL_BOARD_RAIL_243_84mm.stl | 243.84 x 29.51 x 18.0 | 无
6 | P10 中主板纵梁 | 19_MID_LONGITUDINAL_BOARD_RAIL_243_84mm.stl | 243.84 x 18.0 x 30.0 | 自动普通支撑_仅热床
6 | P11 右主板纵梁 | 19_CPU_LONGITUDINAL_BOARD_RAIL_243_84mm.stl | 243.84 x 16.0 x 18.0 | 无
4 | P12 一体轻量显卡支架 | 07_GPU_INTEGRATED_LIGHTWEIGHT_FRAME.stl | 80.0 x 128.0 x 28.0 | 无
8 | P15 双风扇一体底梁 | 20_ONE_PIECE_DUAL_140_FAN_RAIL_284mm.stl | 209.304 x 209.304 x 31.0 | 自动普通支撑_仅热床
1 | P16 左风扇面板 | 10_GPU_140_FAN_MOUNT.stl | 140.0 x 140.0 x 16.0 | 无
2 | P17 右风扇面板 | 10_CPU_140_FAN_MOUNT.stl | 140.0 x 140.0 x 16.0 | 无

### 验证范围与维护入口

V24螺丝头配合修订：8个零件20处头井从Ø6.6扩至Ø8.2；P03/P04/P05/P08/P09/P10/P11/P15需补打，3 mm承压层保留。螺纹通孔和热熔孔保持原尺寸，风扇自攻孔独立。按实测缩孔预计净径7.6～7.9 mm，需先试装。全部15件打印件插图直接提取自最新九盘3MF，按已核对装配坐标重绘；各步完成图同步更新。硬件仅为参考包络。图解来自对应V24毫米网格及已核对装配变换；保留V22电源挡耳、V20一体显卡支架和V23风扇阶梯孔。44个预留热熔孔中P05一个旧孔停用，有效43个位置；连接账最多43颗M3，风扇另8颗自攻。几何和切片检查不代表承重、冲击、温升或PETG长期蠕变验收。

模型：ATX_Desk_v24_M3_D7_head_clearance.f3d；打印工程：Style1_V24_All_Latest_Parts_9_Plates.3mf；V24九盘已按原参数摆盘，尚未切片，未发送打印。49小时44分、1106.22 g为V23历史切片估计；请重新切片核对。

两块风扇面板必须核对实际孔径、盖底斜面、窄承压边和自攻咬合；P08挡耳不等于向上防脱，必须扎带固定；真实接口、散热器、脚垫和线缆仍需实物核对。

风格1 V24 · 2026年11月1日 · P13/P14已停用；本书不适用于风格2。
