rapidrabbitsliu/pc-chassis-designs/outputs/Style2-v09/Style2_V09_Assembly_Manual.html

STYLE 2 / V09 / 2026.10.23

# 开放式机架安装说明书

先压入热熔螺母，再组装框架，最后安装硬件。适用于 19 件、13 盘的 V09 打印工程。

打印 / 保存为 PDF清空勾选

## 这份说明对应哪一版

三根竖柱、竖放电源、外侧直角支撑、上下两只 140 mm 风扇；显卡与主板基准平面间距为 55 mm。

62

热熔螺母

19

打印零件

314

总高 / mm

整体两水平方向为 299.84 × 280 mm。280 mm 对应此前收紧的风扇至电源侧方向，不代表两个方向都小于 290 mm。

V09 属于待实物装配验证的原型。PCIe 母槽尺寸、显卡接触位置、CPU 散热器和线缆空间尚未全部确认；55 mm 是图中两平面距离，不是扣除主板元件后的最小距离，也不代表散热已验证。

V09 蓝色支架与半透明硬件参考装配图

蓝色为打印支架，半透明为硬件示意。以零件编号和孔位图确定方向。

## 零件图册 · 先按编号认零件（点击步骤中的编号可跳转）

P01–P19 是本说明书的单件编号，旁边保留 Bambu 文件名与盘号。编号目前显示在说明书中，尚未刻在打印零件上；建议出盘后用纸签或记号笔在非配合面标记。外形相同的零件按安装位置区分，不需要重新打印。

### P01 左侧立柱

带顶部横向短耳；主板侧有 3 个凸台

带顶部横向短耳；主板侧有 3 个凸台

第 1 盘 · 热熔螺母 13 个

01_UPRIGHT_1

### P02 中间立柱

无顶部短耳，背面仅 4 个横撑孔

无顶部短耳，背面仅 4 个横撑孔

第 2 盘 · 热熔螺母 9 个

01_UPRIGHT_2

### P03 右侧立柱

外侧另外有 4 个风扇立梁连接孔

外侧另外有 4 个风扇立梁连接孔

第 3 盘 · 热熔螺母 17 个

01_UPRIGHT_3

### P04 左侧底脚

电源端带外侧连接凸块

电源端带外侧连接凸块

第 4 盘 · 热熔螺母 4 个

02_FOOT_1

### P05 中间底脚

电源端没有直角框连接凸块

电源端没有直角框连接凸块

第 4 盘 · 热熔螺母 3 个

02_FOOT_2

### P06 右侧底脚

电源端带外侧连接凸块，与左侧镜像

电源端带外侧连接凸块，与左侧镜像

第 5 盘 · 热熔螺母 4 个

02_FOOT_3

### P07 下横撑

两端短斜角向上；装在主板背面下方

两端短斜角向上；装在主板背面下方

第 7 盘 · 热熔螺母 0 个

03_LOWER_CROSSBAR

### P08 上横撑

两端短斜角向下；装在主板背面上方

两端短斜角向下；装在主板背面上方

第 8 盘 · 热熔螺母 0 个

03_UPPER_CROSSBAR

### P09 左侧直角框

装在左立柱外侧，螺钉头凹槽朝外

装在左立柱外侧，螺钉头凹槽朝外

第 9 盘 · 热熔螺母 0 个

05_SIDE_RECTANGULAR_FRAME_1

### P10 右侧直角框

装在右立柱外侧，螺钉头凹槽朝外

装在右立柱外侧，螺钉头凹槽朝外

第 10 盘 · 热熔螺母 0 个

05_SIDE_RECTANGULAR_FRAME_3

### P11 显卡承托梁

中间大开口，8 个螺母孔朝上

中间大开口，8 个螺母孔朝上

第 6 盘 · 热熔螺母 8 个

06_GPU_CARRIER

### P12 PCIe 母槽托盘

薄框；母槽安装方式仍待实物适配

薄框；母槽安装方式仍待实物适配

第 9 盘 · 热熔螺母 0 个

07_RISER_TRAY_PENDING_MEASUREMENT

### P13 左显卡垫座

靠显卡左端，接触壳体可承力位置

靠显卡左端，接触壳体可承力位置

第 9 盘 · 热熔螺母 0 个

08_GPU_PAD_LEFT_FIT_REQUIRED

### P14 右显卡垫座

靠显卡右端；与左垫座形状相同

靠显卡右端；与左垫座形状相同

第 9 盘 · 热熔螺母 0 个

08_GPU_PAD_RIGHT_FIT_REQUIRED

### P15 电源前托条

较窄的前侧边缘，为立柱与底脚避让

较窄的前侧边缘，为立柱与底脚避让

第 7 盘 · 热熔螺母 0 个

09_PSU_SADDLE_FRONT

### P16 电源后托条

完整宽度托条；装在电源后侧

完整宽度托条；装在电源后侧

第 8 盘 · 热熔螺母 0 个

09_PSU_SADDLE_REAR

### P17 双风扇立梁

四条短支脚连接右立柱，4 个接收孔连接风扇框

四条短支脚连接右立柱，4 个接收孔连接风扇框

第 11 盘 · 热熔螺母 4 个

10_FAN_MAST_RIGHT_SIDE

### P18 下风扇框 · 显卡

外形与上框相同，装在下方

外形与上框相同，装在下方

第 12 盘 · 热熔螺母 0 个

11_FAN_PANEL_GPU_140mm

### P19 上风扇框 · CPU / 内存

外形与下框相同，装在上方

外形与下框相同，装在上方

第 13 盘 · 热熔螺母 0 个

11_FAN_PANEL_CPU_RAM_140mm

## 01 · 先准备材料和工具

材料 | 需要 / 建议备量 | 购买或使用要点
M3 黄铜热熔螺母 | 62 / 70 个 | 长度 H4.5 mm，外径约 5 mm，M3 内螺纹；模型预留孔径 4.7 mm。不同品牌外纹不同，先用试块试装。H8 不可直接代替。
M3 × 6 mm 机螺钉 | 62 / 70 颗 | 其中框架 53 颗、主板 9 颗。选头径不超过 6.6 mm、头高不超过 3 mm 的圆柱头等合适头型；不选沉头或风扇自攻螺钉。长度从头下计算。
140 × 140 × 25 mm 风扇 | 2 只 | 当前孔距 124.5 mm，四孔贯穿固定；先核对实际孔距、孔径和厚度。
M4 × 40 mm 贯穿螺栓 + 普通 M4 螺母 | 各 8 / 各 10 个 | 用于两只风扇，不使用热熔螺母。框 6 mm + 风扇 25 mm 后需容纳螺母及垫片；到货实配，若风扇不允许 M4 穿过则更换相配规格，勿强扩孔。
M4 平垫片 | 约 16 个 | 螺栓头与螺母侧各一片；可按实际风扇安装面调整。
电源固定带 | 2 条 | 足够绕过电源和可靠承力位置的可调绑带；约 300–400 mm 长，长度以实物为准。不能遮挡进出风口，不能压电源线出口。模型窄槽不保证适配宽魔术贴。
显卡防倾固定件 | 1 套，实配 | 目前模型没有完整的金属挡板锁紧座。需补足与挡板配合的机械固定，不能让母槽承担显卡重量，也不能只依靠摩擦夹持。
PCIe 延长线及母槽固定件 | 已有延长线；紧固件待测 | 托盘当前为临时方案，尚未为实物母槽建立专用安装孔。母槽安装螺丝不包含在 62 颗中；实测后确定。
风扇接线材料 | 按接口需要 | PWM 延长线 / 一分二线，或带独立供电的集线器；先查风扇额定电流及主板风扇接口允许电流。
可选辅助材料 | 若干 | 尼龙扎带与固定座、防滑脚垫、薄软垫。加厚脚垫会增加 314 mm 总高，仍须满足置物空间高度；不得让软垫接触风扇叶片。

### 热熔工具

- 可调温电烙铁及 M3 热熔螺母压入头
- 稳定烙铁架、耐热垫、镊子
- 直角定位夹具或小台钳软夹口
- 同材料的 4.7 mm 孔试块，先试装再处理正式零件

### 装配工具

- 与所选螺钉匹配的内六角 / 十字螺丝刀
- M4 螺母扳手或小套筒
- 游标卡尺、钢尺、直角尺
- 去裙边钳、修边工具、小锉刀、护目镜
- 防静电操作条件及清洁的装配桌面

## 02 · 哪些孔先压螺母

所有热熔操作都在硬件安装前完成。螺母装在接收螺丝的 4.7 mm 盲孔里；3.4 mm 通孔只供螺丝穿过，6.6 mm 大孔用于容纳螺丝头，均不装螺母。

零件 / 文件编号 | 盘号 | 热熔螺母 | 压入位置与朝向
立柱 1P01 · 01_UPRIGHT_1 | 1 | 13 | 主板侧凸台 3；背面 6；底部侧面 2；外侧上部 2
立柱 2P02 · 01_UPRIGHT_2 | 2 | 9 | 主板侧凸台 3；背面 4；底部侧面 2
立柱 3P03 · 01_UPRIGHT_3 | 3 | 17 | 主板侧凸台 3；背面 6；底部侧面 2；外侧上部 2；风扇立梁连接 4
底脚 1P04 · 02_FOOT_1 | 4 | 4 | 朝上 3；电源侧末端凸块的外侧面 1
底脚 2P05 · 02_FOOT_2 | 4 | 3 | 朝上 3
底脚 3P06 · 02_FOOT_3 | 5 | 4 | 朝上 3；电源侧末端凸块的外侧面 1
显卡承托梁P11 · 06_GPU_CARRIER | 6 | 8 | 上表面 8：母槽托盘 4，左右显卡垫座各 2
双风扇立梁P17 · 10_FAN_MAST_RIGHT_SIDE | 11 | 4 | 朝风扇框的安装面 4，分为上下两组
合计 | | 62 个 | 立柱 39 + 底脚 11 + 显卡承托梁 8 + 风扇立梁 4

### 立柱逐面孔位图

高度均从装配后的地面 Z=0 起算；立柱底端在 Z=10，因此从零件底端量时需减去 10 mm。绿色为主板凸台孔，蓝色为背面横撑孔，橙色为侧向连接孔。侧面图把两侧孔合并展示，实际朝向见图下说明。

### 立柱 1 · 13 个

底部 20/35：朝左侧；上部 160/184：朝左外侧。

### 立柱 2 · 9 个

底部 20/35：朝左侧。

### 立柱 3 · 17 个

底部 20/35：朝左侧；160/184 及风扇孔 50/130/236/290：朝右外侧。

立柱 1 的最上方绿色孔位于伸出的短耳上，其余两个在竖柱上。立柱 3 的四个风扇连接孔高度为 50 / 130 / 236 / 290 mm，不要和背面横撑孔混淆。

底脚、显卡梁、风扇立梁的定位方法

- 三根底脚：每根上表面 3 个盲孔，对应显卡梁、电源前托、电源后托。沿显卡方向至电源方向，整机坐标 Y 依次为 −87.4 / 30 / 101 mm；从底脚显卡端的最前端量为 30 / 147.4 / 218.4 mm。底脚 1、3 电源端凸块还各有 1 个外侧横向盲孔。
- 显卡承托梁：上表面的 8 个盲孔全部压入；靠近两端的两对孔给显卡垫座，中间两对孔给母槽托盘。三处固定到底脚的通孔不装螺母。
- 风扇立梁：仅装在朝风扇框一面的 4 个接收孔，高度 68 / 104 / 220 / 256 mm；四条连接主立柱的支脚有深螺丝头孔，不装螺母。

### 这些零件不需要热熔螺母

上下横撑（03）、左右直角框（05）、母槽托盘（07）、两块显卡垫座（08）、电源前后托条（09）、两块风扇框（11）。它们的螺丝穿过去，拧入另一零件中已压好的螺母。

### 热熔操作顺序

1. 去掉裙边和孔口毛刺，确认零件没有裂纹、层间分离或明显弯曲；不要直接把孔扩到螺母外径。
2. 在同批 PETG 试块上试装。烙铁温度按螺母厂家及 PETG 的建议调节，以能缓慢压入且不过度软塌为准，不把打印喷嘴温度直接当作热熔设定。
3. 让安装面朝上、孔轴竖直，烙铁头与孔保持同轴，利用热量轻压到与孔口齐平；不要强行冷压、顶穿或继续压深。
4. 保持位置至塑料定形，完全冷却后再轻试 M3 螺丝；确认没有歪斜、堵牙、松动或凸起。
5. 逐件完成上表数量后，再开始装配。若螺母转动、拉脱或孔周围开裂，先返修或重打，不能靠拧得更紧补救。

## 03 · 按顺序装配

1

### 清点与预装检查

先清点 19 个打印件、62 个热熔螺母和紧固件。处理裙边与小孔毛刺，空装确认接合面贴合；主板和显卡先留在防静电包装中。

先完成第 02 节所有热熔螺母，冷却后再继续。

P01 左侧立柱P02 中间立柱P03 右侧立柱P04 左侧底脚P05 中间底脚P06 右侧底脚P07 下横撑P08 上横撑P09 左侧直角框P10 右侧直角框P11 显卡承托梁P12 PCIe 母槽托盘P13 左显卡垫座P14 右显卡垫座P15 电源前托条P16 电源后托条P17 双风扇立梁P18 下风扇框 · 显卡P19 上风扇框 · CPU / 内存

本步完成状态。螺母和螺丝未画出，位置见孔位图。

本步完成状态。螺母和螺丝未画出，位置见孔位图。

2

### 组装三根立柱和底脚

01_UPRIGHT_1/2/3 分别配 02_FOOT_1/2/3。主板凸台朝显卡一侧，底脚带末端凸块的一侧朝电源。每根用 2 颗 M3×6 从底脚侧面穿入，拧入立柱底部侧面螺母。

共 6 颗；先轻拧，让三个底脚平放在同一平面。

P01 左侧立柱P02 中间立柱P03 右侧立柱P04 左侧底脚P05 中间底脚P06 右侧底脚

本步完成状态。螺母和螺丝未画出，位置见孔位图。

本步完成状态。螺母和螺丝未画出，位置见孔位图。

3

### 安装上下横撑

上下横撑装在立柱背面，也就是电源一侧。每根横撑在每根立柱有 2 颗螺丝，两端短斜角连接各另有 1 颗；每根横撑 8 颗 M3×6。

共 16 颗；下横撑主体孔高度 50/64，上横撑 277/291 mm。校正立柱垂直后逐步交替拧紧，手拧贴合即可。

P07 下横撑P08 上横撑

本步完成状态。螺母和螺丝未画出，位置见孔位图。

本步完成状态。螺母和螺丝未画出，位置见孔位图。

4

### 安装电源托条与外侧直角框

两根电源托条分别对准三根底脚上中间、后方的孔，每条用 3 颗 M3×6。两侧直角框放在最外侧：上端对准立柱侧面 160/184 mm 孔，下端对准底脚末端凸块孔。

托条 6 颗，直角框 6 颗。电源出风侧必须保留通畅，不能被新增绑带或线束遮住。

P09 左侧直角框P10 右侧直角框P15 电源前托条P16 电源后托条

本步完成状态。螺母和螺丝未画出，位置见孔位图。

本步完成状态。螺母和螺丝未画出，位置见孔位图。

5

### 安装显卡承托梁和小托件

显卡梁装在三根底脚的显卡端固定孔，用 3 颗 M3×6。母槽托盘用 4 颗；左右显卡垫座各用 2 颗。承托梁与托件应一起处于 V09 向外移后的位置。

共 11 颗。母槽托盘的 4 颗只连接托盘与承托梁，并不是将延长线母槽直接锁在托盘上。

P11 显卡承托梁P12 PCIe 母槽托盘P13 左显卡垫座P14 右显卡垫座

本步完成状态。螺母和螺丝未画出，位置见孔位图。

本步完成状态。螺母和螺丝未画出，位置见孔位图。

6

### 安装主板、内存与散热器

先在桌面上按硬件原厂说明安装 CPU、内存和散热器背板。将主板孔与 9 个凸台对齐，主板接口朝电源出风的同一侧；使用 9 颗 M3×6 轻锁固定。

必须全部孔位自然对齐，凸台不能顶住元件或焊点。不要硬弯主板；散热器/内存与显卡空间需按实物确认。主板孔周围只能接触厂家允许的安装环。

本步完成状态。浅灰为硬件包络，未画出线缆、散热器、绑带和显卡挡板额外固定件；这些仍需按文字要求完成。

本步完成状态。浅灰为硬件包络，未画出线缆、散热器、绑带和显卡挡板额外固定件；这些仍需按文字要求完成。

7

### 放入并固定电源

电源竖放，出风口与主板后接口同向，风扇面朝外。由斜坡限位的一侧导入，落在两条托座上，再用两条可靠绑带固定在承力位置。

不拆电源外壳，不借用外壳散热孔穿金属件，不拧入可能过长的外壳螺丝。托座限位只定位，不能代替防倾/防脱固定。

本步完成状态。浅灰为硬件包络，未画出线缆、散热器、绑带和显卡挡板额外固定件；这些仍需按文字要求完成。

本步完成状态。浅灰为硬件包络，未画出线缆、散热器、绑带和显卡挡板额外固定件；这些仍需按文字要求完成。

8

### 装入 PCIe 延长线和显卡

先实测母槽并完成适配固定；母槽不能接触裸露导电件，也不能只用胶带承重。延长线按厂家弯折要求接入主板。显卡完全插入并锁扣，壳体边缘落在垫座可承力位置。

必须额外完成显卡挡板的机械锁紧与防倾固定。若母槽孔位、挡板固定或垫座位置尚未适配，停在此步，不通电。不要让热管、风扇、PCB 或元件承担支撑载荷。

本步完成状态。浅灰为硬件包络，未画出线缆、散热器、绑带和显卡挡板额外固定件；这些仍需按文字要求完成。

本步完成状态。浅灰为硬件包络，未画出线缆、散热器、绑带和显卡挡板额外固定件；这些仍需按文字要求完成。

9

### 安装双风扇组件

风扇立梁先用 4 颗 M3×6 连接到立柱 3 的四个侧孔。两块风扇框各用 2 颗 M3×6 连接到立梁。每只风扇用 4 套 M4 贯穿螺栓、垫片与普通螺母固定到框上。

M3 共 8 颗；M4 共 8 套。上风扇对应 CPU/内存，下风扇对应显卡。按风扇壳体气流箭头，让空气由内存侧吹向主板后接口方向；不要只凭叶片外观判断。

P17 双风扇立梁P18 下风扇框 · 显卡P19 上风扇框 · CPU / 内存

本步完成状态。浅灰为硬件包络，未画出线缆、散热器、绑带和显卡挡板额外固定件；这些仍需按文字要求完成。

本步完成状态。浅灰为硬件包络，未画出线缆、散热器、绑带和显卡挡板额外固定件；这些仍需按文字要求完成。

10

### 理线、复查后试运行

在接通市电前检查所有机械固定，布线远离叶片与发热部位。核对风扇接口电流、显卡供电连接和延长线插入状态。完成下列检查后，再按硬件原厂说明开机并观察温度与风向。

初次运行先低负载观察；显卡穿透风扇热风仍可能朝主板，需要实测确认。若晃动、异响、局部塑料变形或温度异常，断电检查。

本步完成状态。浅灰为硬件包络，未画出线缆、散热器、绑带和显卡挡板额外固定件；这些仍需按文字要求完成。

本步完成状态。浅灰为硬件包络，未画出线缆、散热器、绑带和显卡挡板额外固定件；这些仍需按文字要求完成。

## 安装细节 · 容易装反的地方

### A · 螺母先压入接收件

先在 P01–P06、P11、P17 上完成全部热熔。大号螺钉头凹槽不是螺母孔。

### B · 穿过连接件再拧入螺母

连接件贴合后轻拧即可。禁止以拧紧螺丝的方式，把歪斜的热熔螺母强拉到位。

### C · 电源限位与导入方向

P15、P16 都有左右限位。一侧斜面用于放入时导向；落位后还要用可靠绑带防倾、防脱，不遮挡通风。

### D · 55 mm 间距与风向

此图只解释基准距离。显卡穿透风扇可能仍朝主板排热；不能以 55 mm 代替实测温度。按风扇壳体箭头核对两只风扇的真实气流方向。

## 04 · 完成检查清单

材料规格已核对：M3 / H4.5 / 外径约 5 mm，未混用 H8所有 62 个热熔螺母已压入、冷却、试牙且没有松动19 个打印件清点齐全，编号与 V09 一致框架底部平稳，立柱垂直，各连接贴合，塑料未裂9 个主板固定孔自然对齐，凸台未碰元件或焊点主板、散热器与显卡实物之间没有碰撞；55 mm 基准间距已核对母槽实物已适配并固定；显卡挡板及壳体有可靠承力与防倾固定电源已用固定带约束，进出风口通畅且电源线出口无挤压两只风扇方向正确，线缆与叶片之间有余量风扇电流、供电插头及 PCIe 延长线连接已核对实际放置空间容纳机架、插头和线缆弯曲，且有进出风余量

本页勾选会尝试保存在当前浏览器；换设备或清除浏览器数据后不保证保留。静态说明离线可用，无外部字体、图片或脚本依赖。

## 05 · 零件和盘号对照

编号从 03 跳到 05 是沿用设计版本命名，不是漏件。共 19 个打印件，硬件参考模型不参与打印。

盘号 | 零件文件名
1 | P01 · 左侧立柱01_UPRIGHT_1
2 | P02 · 中间立柱01_UPRIGHT_2
3 | P03 · 右侧立柱01_UPRIGHT_3
4 | P04 · 左侧底脚02_FOOT_1
4 | P05 · 中间底脚02_FOOT_2
5 | P06 · 右侧底脚02_FOOT_3
6 | P11 · 显卡承托梁06_GPU_CARRIER
7 | P07 · 下横撑03_LOWER_CROSSBAR
7 | P15 · 电源前托条09_PSU_SADDLE_FRONT
8 | P08 · 上横撑03_UPPER_CROSSBAR
8 | P16 · 电源后托条09_PSU_SADDLE_REAR
9 | P09 · 左侧直角框05_SIDE_RECTANGULAR_FRAME_1
9 | P12 · PCIe 母槽托盘07_RISER_TRAY_PENDING_MEASUREMENT
9 | P13 · 左显卡垫座08_GPU_PAD_LEFT_FIT_REQUIRED
9 | P14 · 右显卡垫座08_GPU_PAD_RIGHT_FIT_REQUIRED
10 | P10 · 右侧直角框05_SIDE_RECTANGULAR_FRAME_3
11 | P17 · 双风扇立梁10_FAN_MAST_RIGHT_SIDE
12 | P18 · 下风扇框 · 显卡11_FAN_PANEL_GPU_140mm
13 | P19 · 上风扇框 · CPU / 内存11_FAN_PANEL_CPU_RAM_140mm

### 螺丝去向核对

立柱到底脚 6；上下横撑 16；两侧直角框 6；显卡承托梁到底脚 3；电源托条到底脚 6；母槽托盘到显卡梁 4；两块显卡垫座 4；风扇立梁到立柱 4；两块风扇框到立梁 4；主板 9。共 62 颗 M3 × 6。风扇的 8 颗 M4 另计。

依据 V09 建模源文件、零件列表及打印工程编写。此说明不包含对实体承载、长期 PETG 蠕变或散热性能的验证结论。版本更新后请同步使用对应模型与说明。
