rapidrabbitsliu/pc-chassis-designs/outputs/ATX-Desk-v12-print-review/Structure.png

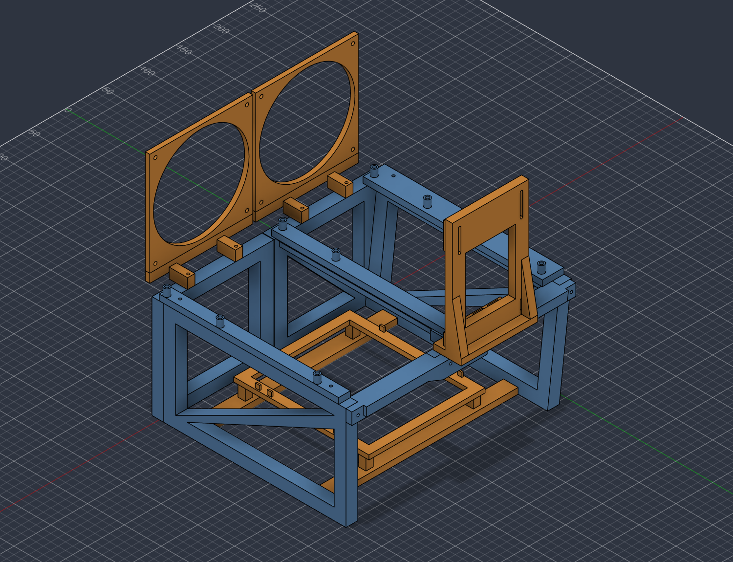
outputs/ATX-Desk-v12-print-review/Structure.png
