rapidrabbitsliu/pc-chassis-designs/outputs/First-Print-V12/First_CPU_Rail.png

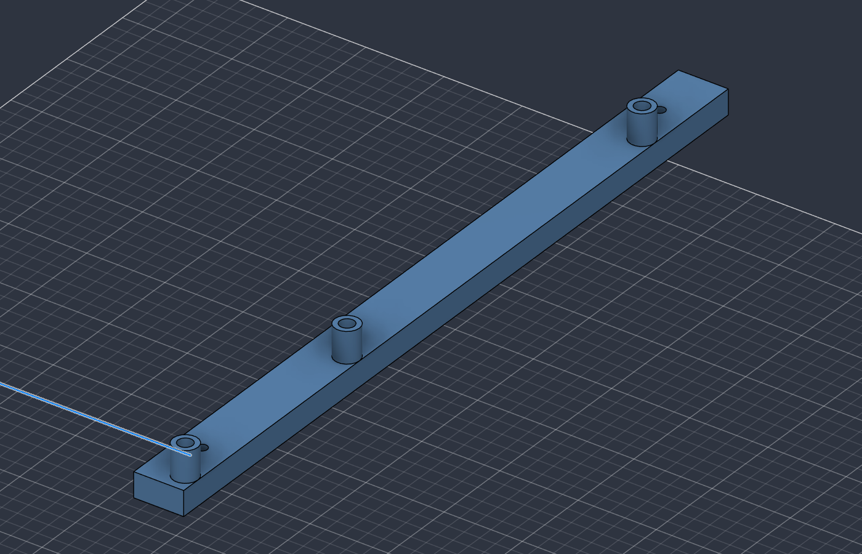
outputs/First-Print-V12/First_CPU_Rail.png
