rapidrabbitsliu/pc-chassis-designs/outputs/Style2-v09/Manual_Images/Assembly_Steps_Overview.png

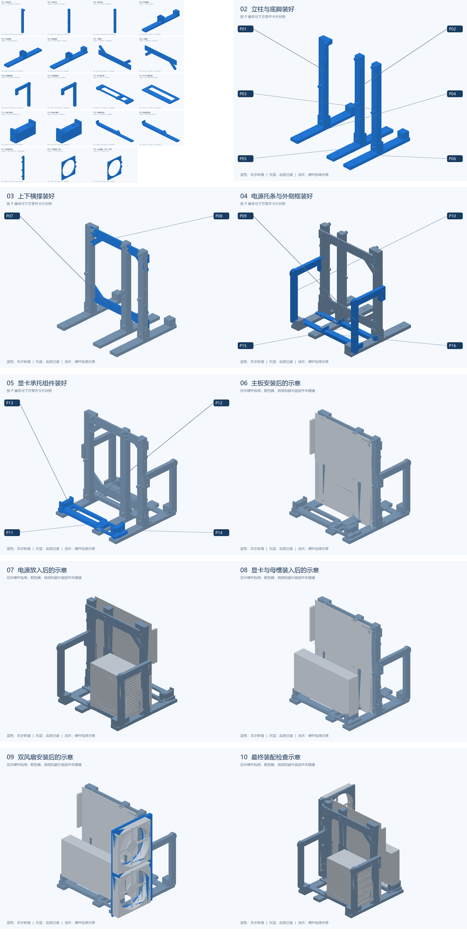
outputs/Style2-v09/Manual_Images/Assembly_Steps_Overview.png
