rapidrabbitsliu/pc-chassis-designs/outputs/Style2-v09/Manual_Images/P07.png

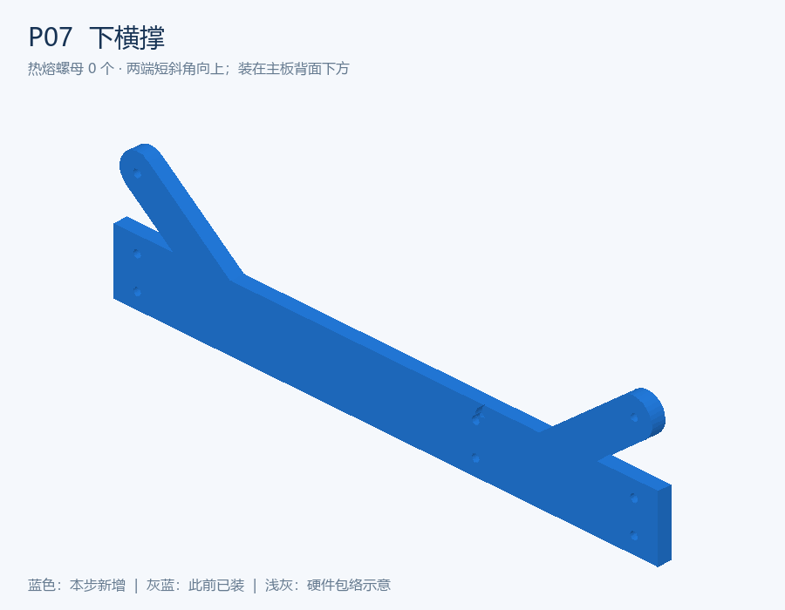
outputs/Style2-v09/Manual_Images/P07.png
