rapidrabbitsliu/pc-chassis-designs/outputs/Style2-v09/Manual_Images/P08.png

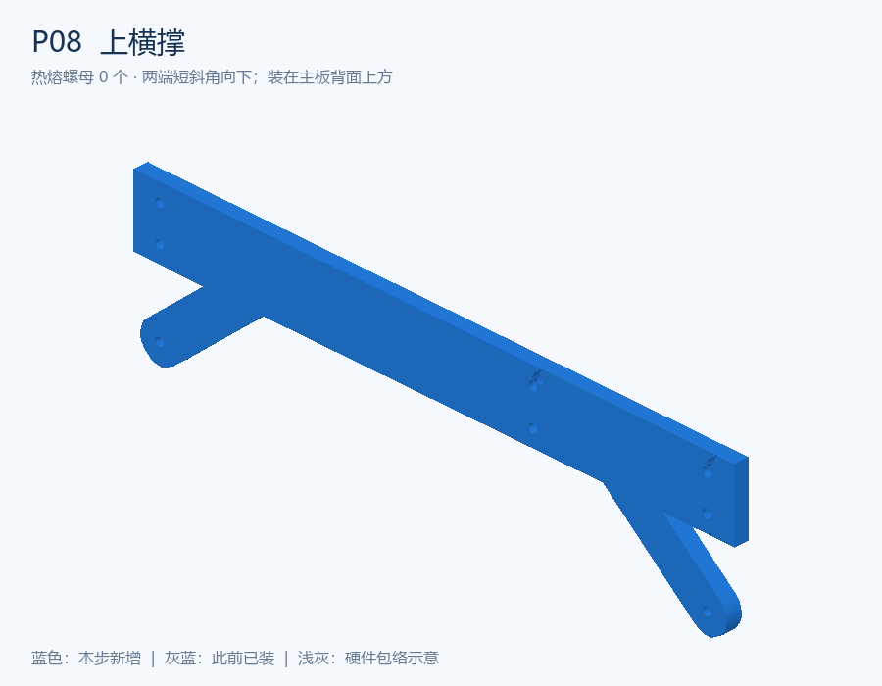
outputs/Style2-v09/Manual_Images/P08.png
