rapidrabbitsliu/pc-chassis-designs/outputs/Style2-v09/Manual_Images/P11.png

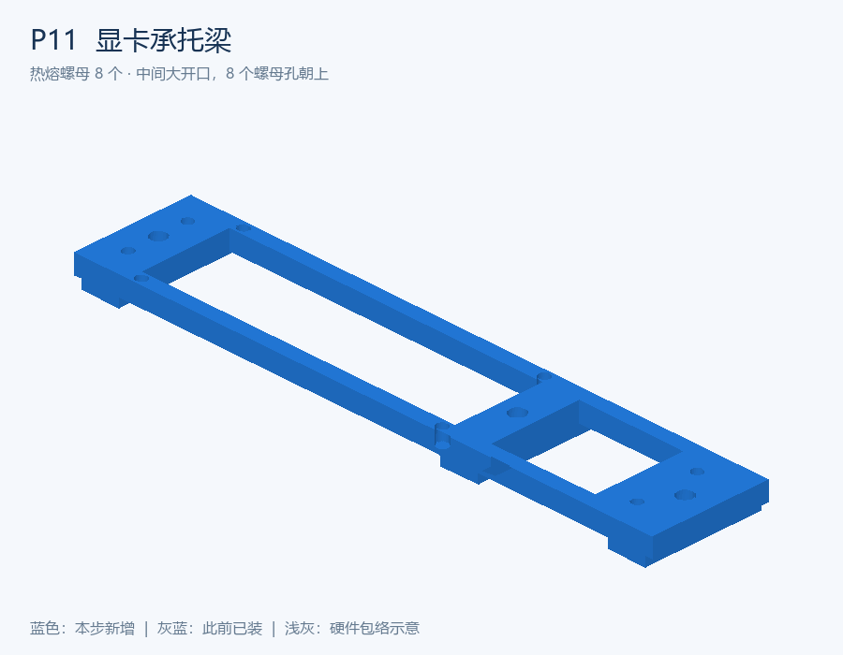
outputs/Style2-v09/Manual_Images/P11.png
