rapidrabbitsliu/pc-chassis-designs/outputs/Style2-v09/Manual_Images/P13.png

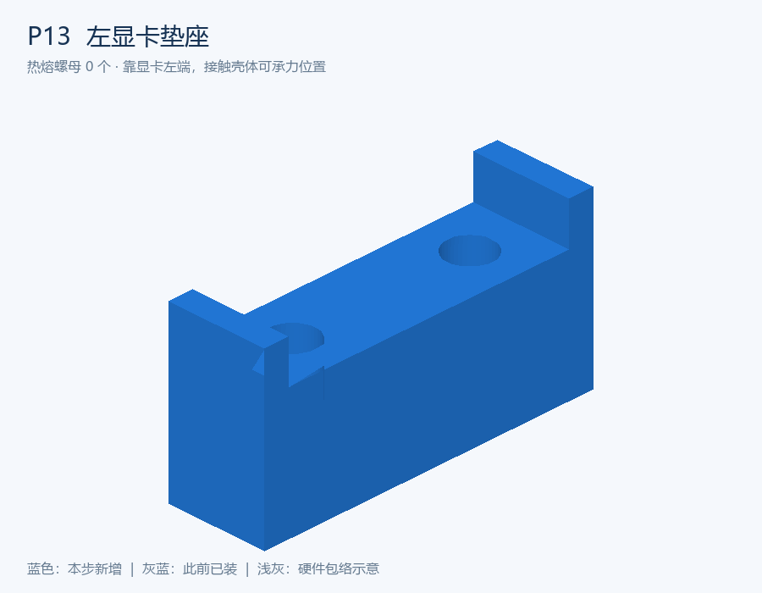
outputs/Style2-v09/Manual_Images/P13.png
