rapidrabbitsliu/pc-chassis-designs/outputs/Style2-v09/Manual_Images/step03.png

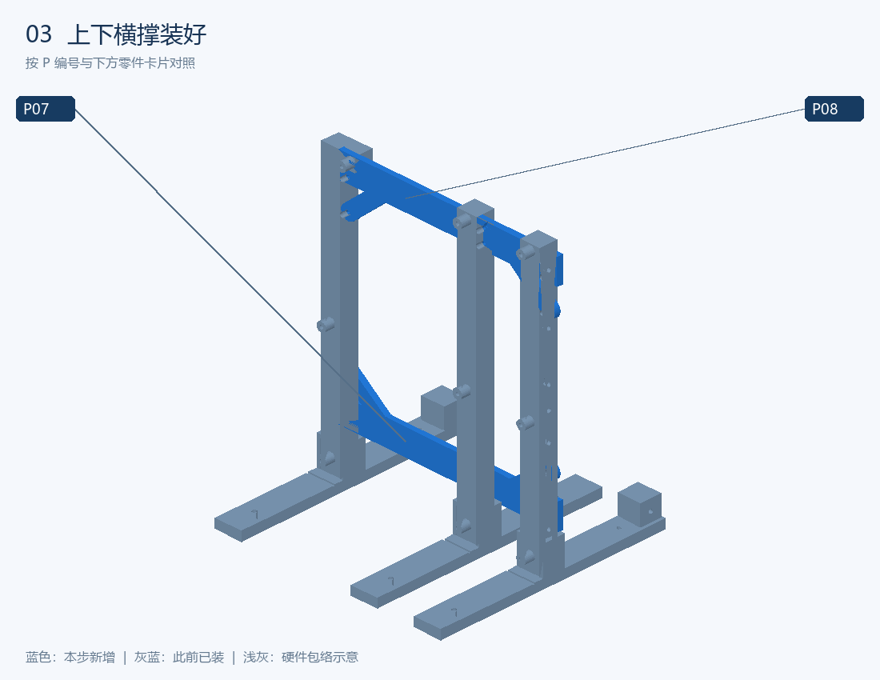
outputs/Style2-v09/Manual_Images/step03.png
