rapidrabbitsliu/pc-chassis-designs/outputs/Style2-v09/Manual_Images/step07.png

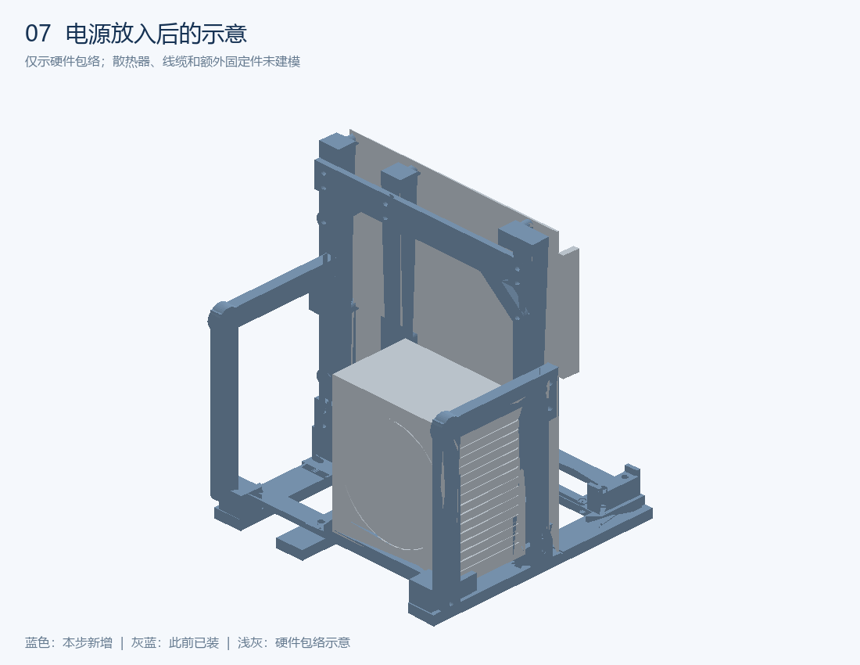
outputs/Style2-v09/Manual_Images/step07.png
