rapidrabbitsliu/pc-chassis-designs/outputs/Style2-v09/Manual_Images/step10.png

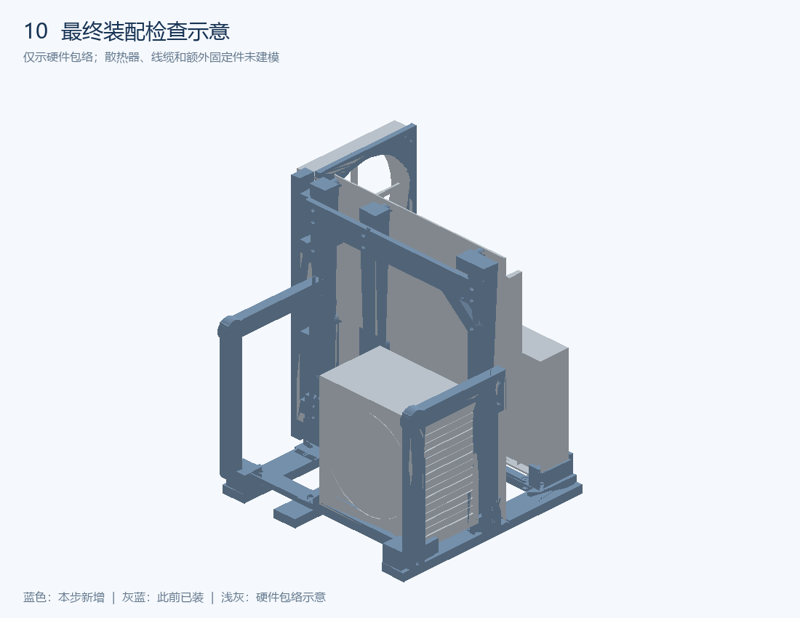
outputs/Style2-v09/Manual_Images/step10.png
