rapidrabbitsliu/pc-chassis-designs/(commit log)

2026-10-24 Archive chassis designs, print projects and cross-device recovery guide
    [01_UPRIGHT_1.stl, 01_UPRIGHT_2.stl, 01_UPRIGHT_3.stl, 02_FOOT_1.stl, 02_FOOT_2.stl, 02_FOOT_3.stl, 03_LOWER_CROSSBAR.stl, 03_UPPER_CROSSBAR.stl]
2026-10-24 Fix style 1 V16 GPU insertion and base screw access
    [04_front_GROUND_BAR_290mm_FLAT_PSU.stl, 04_rear_GROUND_BAR_290mm_FLAT_PSU.stl, 05_CENTERED_FLAT_PSU_CRADLE_OPEN_INTAKE.stl, 07_GPU_REINFORCED_REAR_TOWER.stl, 08_GPU_LOWER_TWO_TAB_RECEIVER_ADJUSTABLE.stl, 08_GPU_UPPER_EAR_LEDGE_ADJUSTABLE.stl, 10_CPU_140_FAN_MOUNT.stl, 10_GPU_140_FAN_MOUNT.stl]
2026-11-01 Publish latest V23 nine-plate 3MF and illustrated assembly manual on Pages
    [Style1_V23_All_Latest_Parts_9_Plates_GUI.3mf]
2026-11-01 feat: V24 compensate 20 M3 D7 screw head wells and refresh print delivery
    [04_front_GROUND_BAR_290mm_FLAT_PSU.stl, 04_rear_GROUND_BAR_290mm_FLAT_PSU.stl, 05_CENTERED_FLAT_PSU_CRADLE_OPEN_INTAKE.stl, 07_GPU_INTEGRATED_LIGHTWEIGHT_FRAME.stl, 10_CPU_140_FAN_MOUNT.stl, 10_GPU_140_FAN_MOUNT.stl, 12_front_CPU_SUPPORT_FRAME.stl, 12_front_PCI_SUPPORT_FRAME.stl]
